diwou/Dottie_-_The_Matrix_Clock_Extended_Edition/signal-2026-06-13-09-17-21-165.jpg

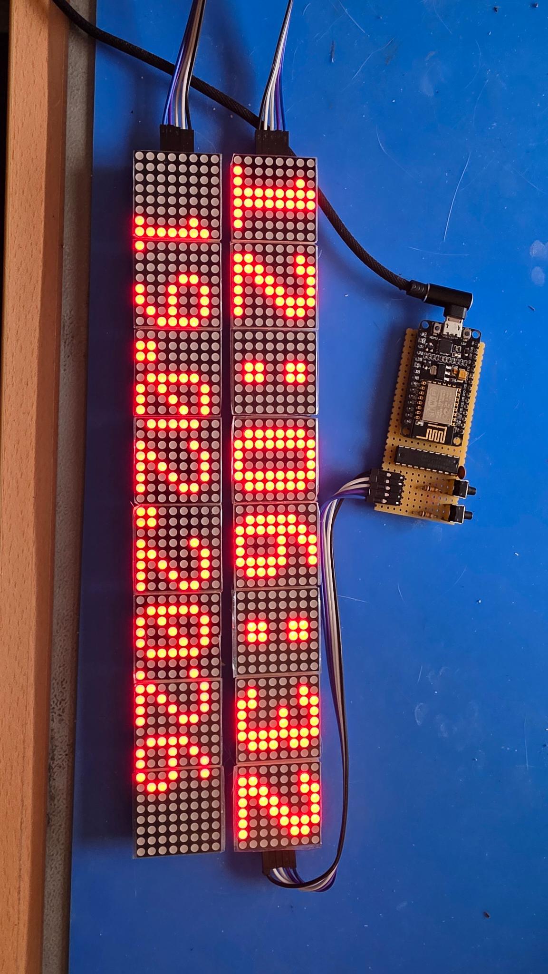
signal-2026-06-13-09-17-21-165.jpg
