diwou/Dottie_-_The_Matrix_Clock_Extended_Edition/signal-2026-06-13-09-19-30-515.jpg

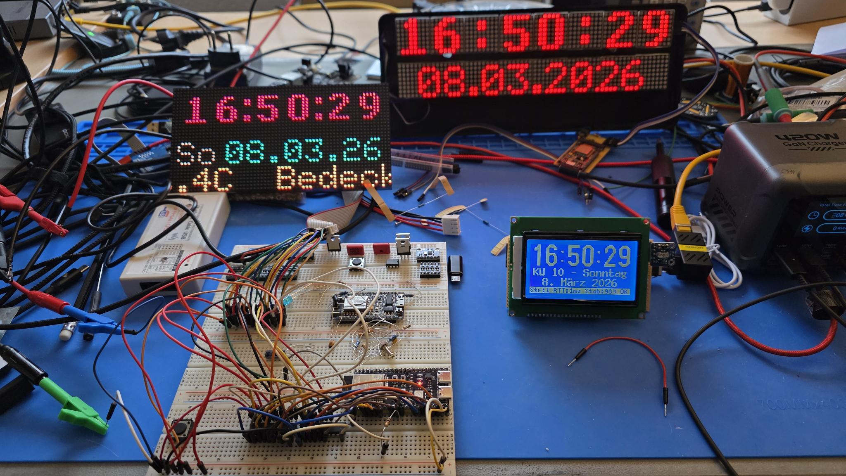
signal-2026-06-13-09-19-30-515.jpg
