diwou/Dottie_-_The_Matrix_Clock_Extended_Edition/kicad/fab/rev0.5/bom.csv

Designator | Footprint | Quantity | Value | LCSC Part #
BT1 | BatteryHolder_MYOUNG_BS-07-A1BJ001_CR2032 | 1 | CR2032
C1, C38 | 0805 | 2 | 10µ
C10, C11, C12, C13, C14, C15, C16, C17, C18, C19, C2, C20, C21, C22, C23, C24, C25, C26, C27, C28, C29, C30, C31, C32, C33, C34, C35, C36, C37, C6, C7, C8, C9 | 0805 | 33 | 100n
C3 | 0805 | 1 | 1µ
C4, C5 | 1206 | 2 | 10µ
D1 | 0805 | 1 | PWR
D2 | D_SMA | 1 | SS14
J1 | PinHeader_1x05_P2.54mm_Vertical | 1 | Conn_01x05
J10, J100, J101, J102, J103, J104, J105, J106, J107, J108, J109, J11, J110, J111, J112, J113, J114, J115, J116, J117, J118, J119, J12, J120, J121, J122, J123, J124, J125, J126, J127, J128, J129, J13, J130, J131, J132, J133, J134, J135, J136, J137, J138, J139, J14, J140, J141, J142, J143, J144, J145, J146, J147, J148, J149, J15, J150, J151, J152, J153, J154, J155, J156, J157, J158, J159, J16, J160, J161, J162, J163, J164, J165, J166, J167, J168, J169, J17, J170, J171, J172, J173, J174, J175, J176, J177, J178, J179, J18, J180, J181, J182, J183, J184, J185, J186, J187, J188, J189, J19, J190, J191, J192, J193, J194, J195, J196, J197, J198, J199, J20, J200, J201, J202, J203, J204, J205, J206, J207, J208, J209, J21, J210, J211, J212, J213, J214, J215, J216, J217, J218, J219, J22, J220, J221, J222, J223, J224, J225, J226, J227, J228, J229, J23, J230, J231, J232, J233, J234, J235, J236, J237, J238, J239, J24, J240, J241, J242, J25, J26, J27, J28, J29, J3, J30, J31, J32, J33, J34, J35, J36, J37, J38, J39, J4, J40, J41, J42, J43, J44, J45, J46, J47, J48, J49, J5, J50, J51, J52, J53, J54, J55, J56, J57, J58, J59, J6, J60, J61, J62 | TestPoint_Pad_1.5x1.5mm | 200 | Conn_01x01_Pin
J2 | USB_C_Receptacle_HCTL_HC-TYPE-C-16P-01A | 1 | USB_C_Receptacle_USB2.0_16P
J63, J64, J65, J66, J67, J68, J69, J7, J70, J71, J72, J73, J74, J75, J76, J77, J78, J79, J8, J80, J81, J82, J83, J84, J85, J86, J87, J88, J89, J9, J90, J91, J92, J93, J94, J95, J96, J97, J98, J99 | TestPoint_Pad_1.5x1.5mm | 40 | Conn_01x01_Pin
LED1, LED10, LED11, LED12, LED13, LED14, LED15, LED16, LED17, LED18, LED19, LED2, LED20, LED21, LED22, LED23, LED24, LED3, LED4, LED5, LED6, LED7, LED8, LED9 | LED_1088_Pin_Header | 24 | 1088AS
R1, R10, R3, R8, R9 | 0805 | 5 | 10k
R11, R12, R13, R14, R15, R16, R17, R18, R19, R20, R21, R22, R23, R24, R25, R26, R27, R28, R29, R30, R31, R32, R33, R34 | 0805 | 24 | 68k
R2 | 0805 | 1 | 1k
R35 | 0805 | 1 | 10
R4, R5 | 0805 | 2 | 5.1k
R6, R7 | 0805 | 2 | 4k7
SW1 | SW_PUSH_6mm_H5mm | 1 | Boot
SW2 | SW_PUSH_6mm_H5mm | 1 | Factory Reset
SW3 | SW_PUSH_6mm_H5mm | 1 | Reset
U1 | SOT-223-3_TabPin2 | 1 | TLV76133DCY
U10, U11, U12, U13, U14, U15, U16, U17, U18, U19, U20, U21, U22, U23, U24, U25, U26, U27, U28, U5, U6, U7, U8, U9 | SOIC-24W_7.5x15.4mm_P1.27mm | 24 | MAX7219CWG
U2 | ESP32-S3-WROOM-1 | 1 | ESP32-S3-WROOM-1
U29 | Bosch_LGA-8_3x3mm_P0.8mm_ClockwisePinNumbering | 1 | BME680
U3 | TSSOP-20_4.4x6.5mm_P0.65mm | 1 | 74HCT245
U30 | XDCR_VEML7700-TT | 1 | VEML7700-TT
U4 | SOIC-16W_7.5x10.3mm_P1.27mm | 1 | DS3231S
