diwou/Dottie_-_The_Matrix_Clock_Extended_Edition/kicad/source/NTP Dot Matrix Clock 64x32.kicad_pcb

## KiCad design kicad/source/NTP Dot Matrix Clock 64x32.kicad_pcb (2026-06-04)

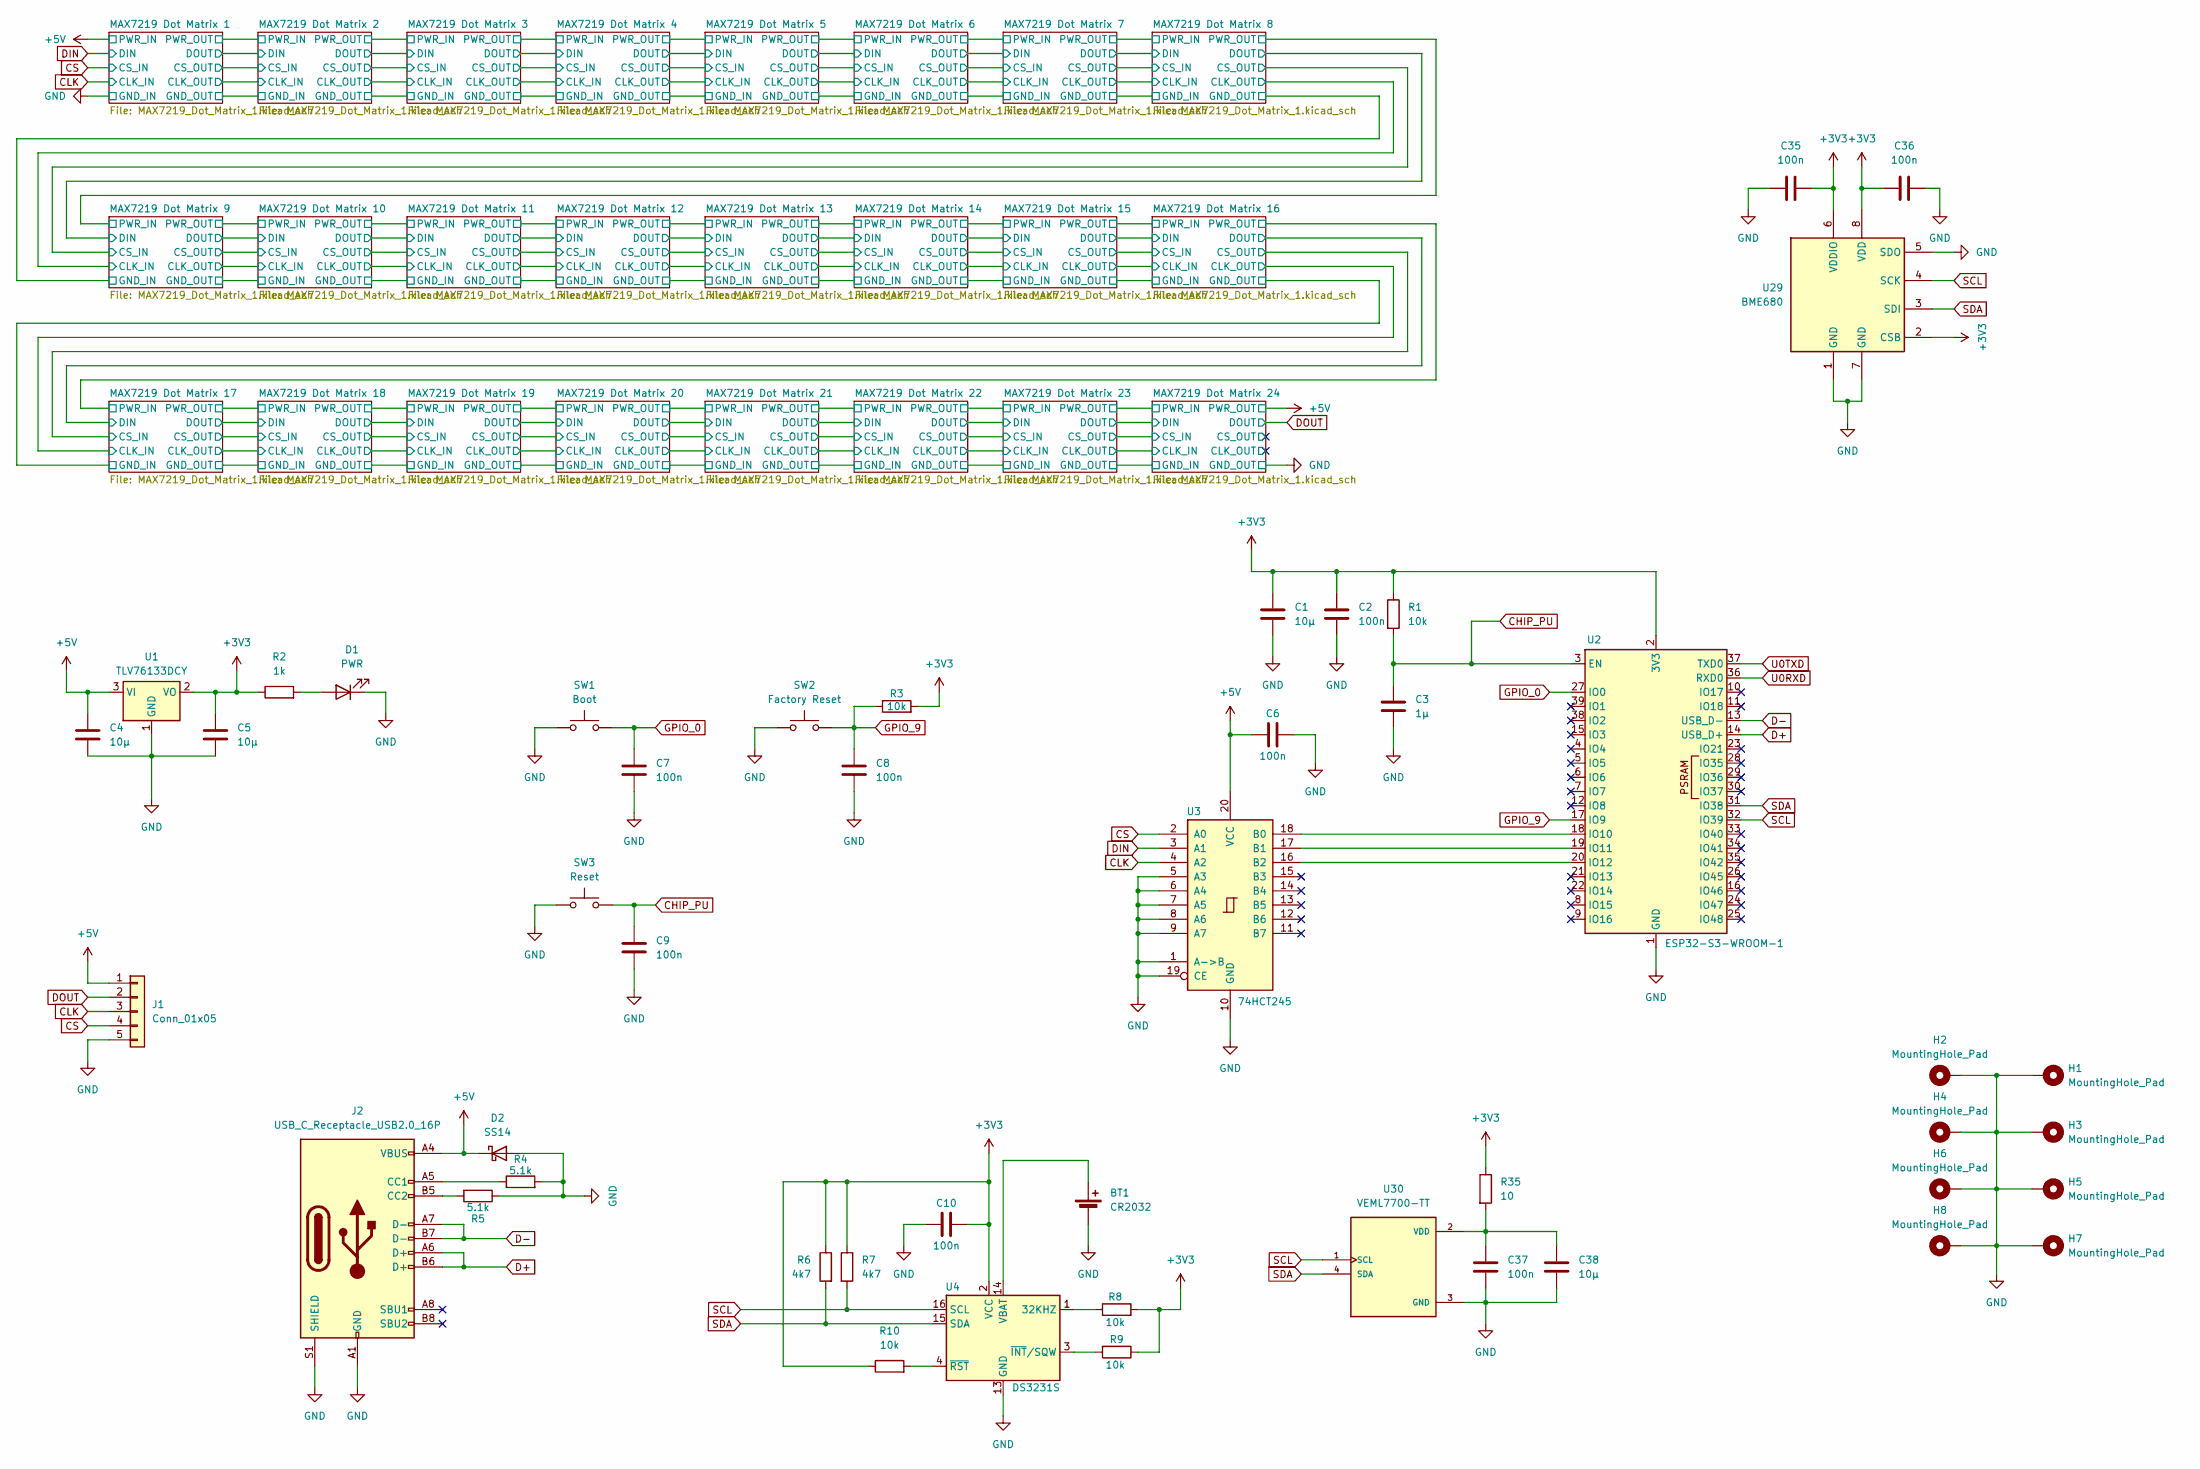
[picture p4: schematic NTP Dot Matrix Clock 64x32.kicad_sch]

Parts:
BT1: CR2032; BatteryHolder_MYOUNG_BS-07-A1BJ001_CR2032
C1, C38: 10µ; C_0805_2012Metric_Pad1.18x1.45mm_HandSolder
C2, C6, C7, C8, C9, C10, C35, C36, C37: 100n; C_0805_2012Metric_Pad1.18x1.45mm_HandSolder
C3: 1µ; C_0805_2012Metric_Pad1.18x1.45mm_HandSolder
C4, C5: 10µ; C_1206_3216Metric_Pad1.33x1.80mm_HandSolder
D1: PWR; LED_0805_2012Metric_Pad1.15x1.40mm_HandSolder
D2: SS14; D_SMA
H1, H2, H3, H4, H5, H6, H7, H8: MountingHole_Pad; MountingHole_3.2mm_M3_DIN965_Pad
J1: Conn_01x05; PinHeader_1x05_P2.54mm_Vertical
J2: USB_C_Receptacle_USB2.0_16P; USB_C_Receptacle_HCTL_HC-TYPE-C-16P-01A
R1, R3, R8, R9, R10: 10k; R_0805_2012Metric_Pad1.20x1.40mm_HandSolder
R2: 1k; R_0805_2012Metric_Pad1.20x1.40mm_HandSolder
R4, R5: 5.1k; R_0805_2012Metric_Pad1.20x1.40mm_HandSolder
R6, R7: 4k7; R_0805_2012Metric_Pad1.20x1.40mm_HandSolder
R35: 10; R_0805_2012Metric_Pad1.20x1.40mm_HandSolder
SW1: Boot; SW_PUSH_6mm_H5mm
SW2: Factory Reset; SW_PUSH_6mm_H5mm
SW3: Reset; SW_PUSH_6mm_H5mm
U1: TLV76133DCY; SOT-223-3_TabPin2
U2: ESP32-S3-WROOM-1
U3: 74HCT245; TSSOP-20_4.4x6.5mm_P0.65mm
U4: DS3231S; SOIC-16W_7.5x10.3mm_P1.27mm
U29: BME680; Bosch_LGA-8_3x3mm_P0.8mm_ClockwisePinNumbering
U30: VEML7700-TT; XDCR_VEML7700-TT; PARTREV 1.6

Connections:
+3V3: C1.1, C2.1, C5.1, C10.2, C35.2, C36.1, R1.1, R2.1, R3.2, R6.1, R7.1, R8.2, R9.1, R10.1, R35.1, U1.2 (VO), U2.2 (3V3), U4.2 (VCC), U29.2 (CSB), U29.6 (VDDIO), U29.8 (VDD)
+5V: C4.1, C6.1, D2.1 (K), J1.1, J2.A4 (VBUS), J2.A9 (VBUS), J2.B4 (VBUS), J2.B9 (VBUS), U1.3 (VI), U3.20 (VCC); also elsewhere on the board
CHIP_PU: C3.1, C9.1, R1.2, SW3.2, U2.3 (EN)
CLK: J1.3, U3.4 (A2); also elsewhere on the board
CS: J1.4, U3.2 (A0); also elsewhere on the board
D+: J2.A6 (D+), J2.B6 (D+), U2.14 (USB_D+)
D-: J2.A7 (D-), J2.B7 (D-), U2.13 (USB_D-)
DIN: U3.3 (A1); also elsewhere on the board
DOUT: J1.2; also elsewhere on the board
GND: BT1.2 (-), C1.2, C2.2, C3.2, C4.2, C5.2, C6.2, C7.2, C8.2, C9.2, C10.1, C35.1, C36.2, C37.2, C38.2, D1.1 (K), D2.2 (A), H1.1 (1_1), H2.1 (1_1), H3.1 (1_1), H4.1 (1_1), H5.1 (1_1), H6.1 (1_1), H7.1 (1_1), H8.1 (1_1), J1.5, J2.A1 (GND), J2.A12 (GND), J2.B1 (GND), J2.B12 (GND), J2.S1 (SHIELD), R4.2, R5.1, SW1.1, SW2.1, SW3.1, U1.1 (GND), U2.1 (GND), U2.40 (GND), U2.41 (GND), U3.1 (A->B), U3.5 (A3), U3.6 (A4), U3.7 (A5), U3.8 (A6), U3.9 (A7), U3.10 (GND), U3.19 (CE), U4.5 (GND), U4.6 (GND), U4.7 (GND), U4.8 (GND), U4.9 (GND), U4.10 (GND), U4.11 (GND), U4.12 (GND), U4.13 (GND), U29.1 (GND), U29.5 (SDO), U29.7 (GND), U30.3 (GND); also elsewhere on the board
GPIO_0: C7.1, SW1.2, U2.27 (IO0)
GPIO_9: C8.1, R3.1, SW2.2, U2.17 (IO9)
unnamed: BT1.1 (+), U4.14 (VBAT)
unnamed: D1.2 (A), R2.2
unnamed: J2.A5 (CC1), R4.1
unnamed: J2.B5 (CC2), R5.2
unnamed: U2.18 (IO10), U3.18 (B0)
unnamed: U2.19 (IO11), U3.17 (B1)
unnamed: U2.20 (IO12), U3.16 (B2)
unnamed: R8.1, U4.1 (32KHZ)
unnamed: R9.2, U4.3 (~INT/SQW)
unnamed: R10.2, U4.4 (~RST)
unnamed: C37.1, C38.1, R35.2, U30.2 (VDD)
SCL: R7.2, U2.32 (IO39), U4.16 (SCL), U29.4 (SCK), U30.1 (SCL)
SDA: R6.2, U2.31 (IO38), U4.15 (SDA), U29.3 (SDI), U30.4 (SDA)
U0RXD: U2.36 (RXD0)
U0TXD: U2.37 (TXD0)
