diwou/Dottie_-_The_Matrix_Clock_Extended_Edition/kicad/source/NTP Dot Matrix Clock 64x32.kicad_pcb

## KiCad design kicad/source/NTP Dot Matrix Clock 64x32.kicad_pcb (continued)

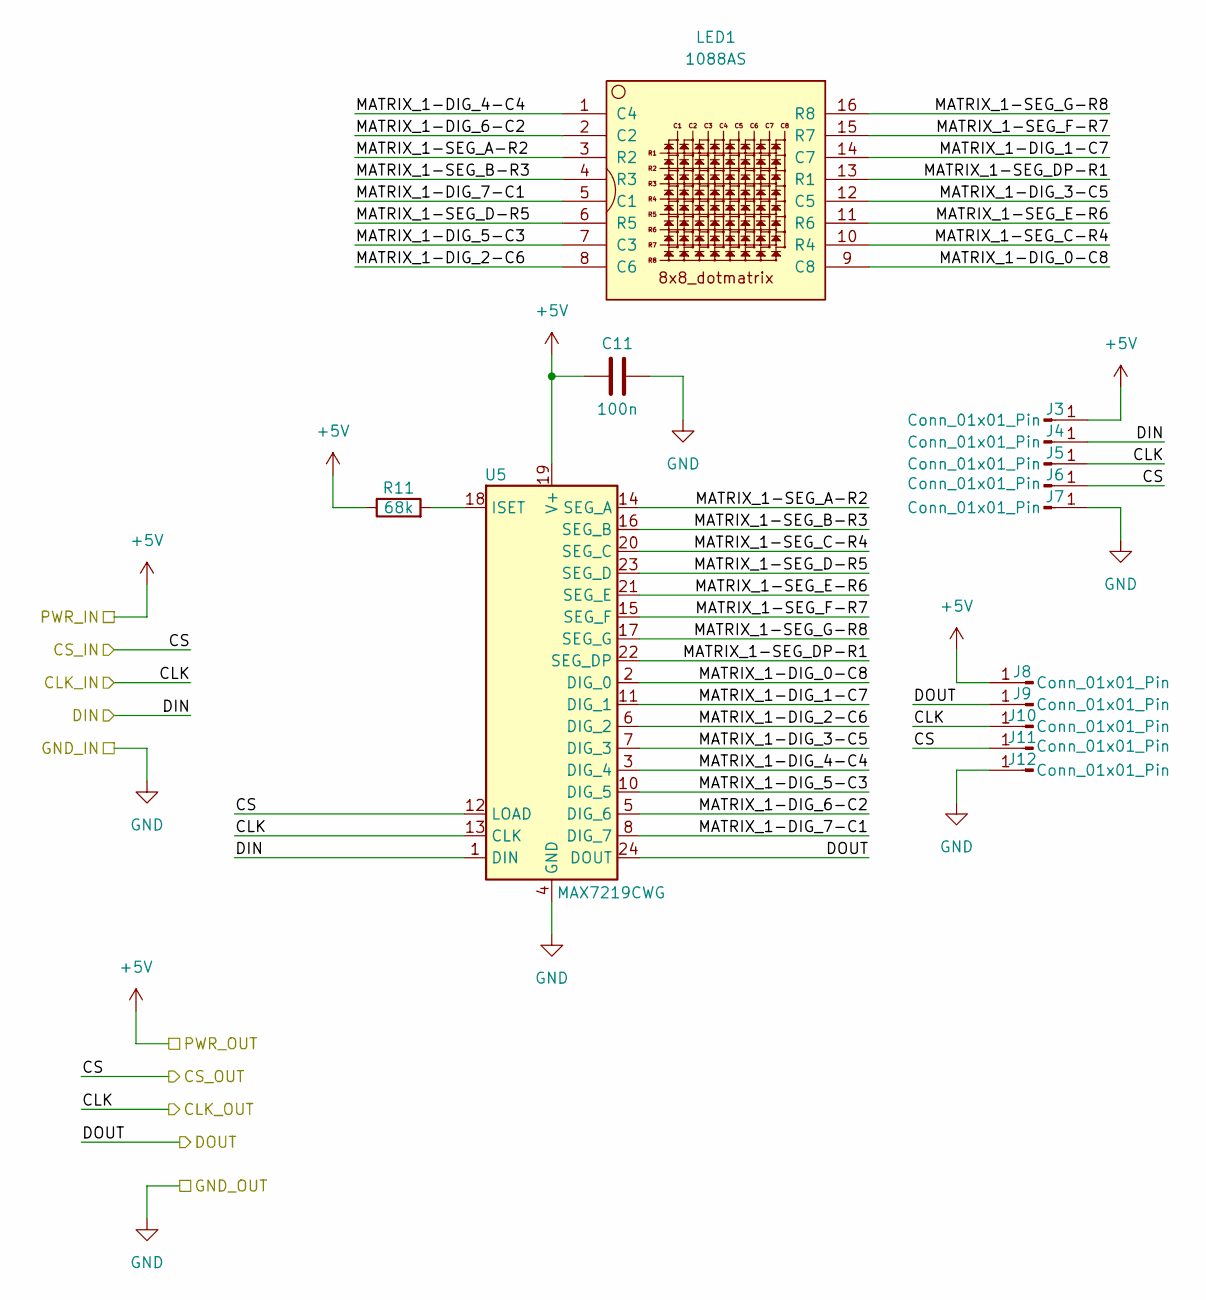
[picture p5: schematic MAX7219_Dot_Matrix_1.kicad_sch, NTP Dot Matrix Clock 64x32]

Parts:
C11: 100n; C_0805_2012Metric_Pad1.18x1.45mm_HandSolder
J3, J4, J5, J6, J7, J8, J9, J10, J11, J12: Conn_01x01_Pin; TestPoint_Pad_1.5x1.5mm
LED1: 1088AS; LED_1088_Pin_Header
R11: 68k; R_0805_2012Metric_Pad1.20x1.40mm_HandSolder
U5: MAX7219CWG; SOIC-24W_7.5x15.4mm_P1.27mm

Connections:
+5V: C11.1, J3.1 (Pin_1_1), J8.1 (Pin_1_1), R11.1, U5.19 (V+); also elsewhere on the board
/MAX7219 Dot Matrix 1/DOUT: J9.1 (Pin_1_1), U5.24 (DOUT); also elsewhere on the board
/MAX7219 Dot Matrix 1/MATRIX_1-DIG_0-C8: LED1.9 (C8), U5.2 (DIG_0)
/MAX7219 Dot Matrix 1/MATRIX_1-DIG_1-C7: LED1.14 (C7), U5.11 (DIG_1)
/MAX7219 Dot Matrix 1/MATRIX_1-DIG_2-C6: LED1.8 (C6), U5.6 (DIG_2)
/MAX7219 Dot Matrix 1/MATRIX_1-DIG_3-C5: LED1.12 (C5), U5.7 (DIG_3)
/MAX7219 Dot Matrix 1/MATRIX_1-DIG_4-C4: LED1.1 (C4), U5.3 (DIG_4)
/MAX7219 Dot Matrix 1/MATRIX_1-DIG_5-C3: LED1.7 (C3), U5.10 (DIG_5)
/MAX7219 Dot Matrix 1/MATRIX_1-DIG_6-C2: LED1.2 (C2), U5.5 (DIG_6)
/MAX7219 Dot Matrix 1/MATRIX_1-DIG_7-C1: LED1.5 (C1), U5.8 (DIG_7)
/MAX7219 Dot Matrix 1/MATRIX_1-SEG_A-R2: LED1.3 (R2), U5.14 (SEG_A)
/MAX7219 Dot Matrix 1/MATRIX_1-SEG_B-R3: LED1.4 (R3), U5.16 (SEG_B)
/MAX7219 Dot Matrix 1/MATRIX_1-SEG_C-R4: LED1.10 (R4), U5.20 (SEG_C)
/MAX7219 Dot Matrix 1/MATRIX_1-SEG_D-R5: LED1.6 (R5), U5.23 (SEG_D)
/MAX7219 Dot Matrix 1/MATRIX_1-SEG_DP-R1: LED1.13 (R1), U5.22 (SEG_DP)
/MAX7219 Dot Matrix 1/MATRIX_1-SEG_E-R6: LED1.11 (R6), U5.21 (SEG_E)
/MAX7219 Dot Matrix 1/MATRIX_1-SEG_F-R7: LED1.15 (R7), U5.15 (SEG_F)
/MAX7219 Dot Matrix 1/MATRIX_1-SEG_G-R8: LED1.16 (R8), U5.17 (SEG_G)
CLK: J5.1 (Pin_1_1), J10.1 (Pin_1_1), U5.13 (CLK); also elsewhere on the board
CS: J6.1 (Pin_1_1), J11.1 (Pin_1_1), U5.12 (LOAD); also elsewhere on the board
DIN: J4.1 (Pin_1_1), U5.1 (DIN); also elsewhere on the board
GND: C11.2, J7.1 (Pin_1_1), J12.1 (Pin_1_1), U5.4 (GND), U5.9 (GND); also elsewhere on the board
unnamed: R11.2, U5.18 (ISET)

Parts of its further copies:
C12, C13, C14, C15, C16, C17, C18, C19, C20, C21, C22, C23, C24, C25, C26, C27, C28, C29, C30, C31, C32, C33, C34: 100n; C_0805_2012Metric_Pad1.18x1.45mm_HandSolder
J13, J14, J15, J16, J17, J18, J19, J20, J21, J22, J23, J24, J25, J26, J27, J28, J29, J30, J31, J32, J33, J34, J35, J36, J37, J38, J39, J40, J41, J42, J43, J44, J45, J46, J47, J48, J49, J50, J51, J52, J53, J54, J55, J56, J57, J58, J59, J60, J61, J62, J63, J64, J65, J66, J67, J68, J69, J70, J71, J72, J73, J74, J75, J76, J77, J78, J79, J80, J81, J82, J83, J84, J85, J86, J87, J88, J89, J90, J91, J92, J93, J94, J95, J96, J97, J98, J99, J100, J101, J102, J103, J104, J105, J106, J107, J108, J109, J110, J111, J112, J113, J114, J115, J116, J117, J118, J119, J120, J121, J122, J123, J124, J125, J126, J127, J128, J129, J130, J131, J132, J133, J134, J135, J136, J137, J138, J139, J140, J141, J142, J143, J144, J145, J146, J147, J148, J149, J150, J151, J152, J153, J154, J155, J156, J157, J158, J159, J160, J161, J162, J163, J164, J165, J166, J167, J168, J169, J170, J171, J172, J173, J174, J175, J176, J177, J178, J179, J180, J181, J182, J183, J184, J185, J186, J187, J188, J189, J190, J191, J192, J193, J194, J195, J196, J197, J198, J199, J200, J201, J202, J203, J204, J205, J206, J207, J208, J209, J210, J211, J212, J213, J214, J215, J216, J217, J218, J219, J220, J221, J222, J223, J224, J225, J226, J227, J228, J229, J230, J231, J232, J233, J234, J235, J236, J237, J238, J239, J240, J241, J242: Conn_01x01_Pin; TestPoint_Pad_1.5x1.5mm
LED2, LED3, LED4, LED5, LED6, LED7, LED8, LED9, LED10, LED11, LED12, LED13, LED14, LED15, LED16, LED17, LED18, LED19, LED20, LED21, LED22, LED23, LED24: 1088AS; LED_1088_Pin_Header
R12, R13, R14, R15, R16, R17, R18, R19, R20, R21, R22, R23, R24, R25, R26, R27, R28, R29, R30, R31, R32, R33, R34: 68k; R_0805_2012Metric_Pad1.20x1.40mm_HandSolder
U6, U7, U8, U9, U10, U11, U12, U13, U14, U15, U16, U17, U18, U19, U20, U21, U22, U23, U24, U25, U26, U27, U28: MAX7219CWG; SOIC-24W_7.5x15.4mm_P1.27mm

Connections of its further copies:
+5V: C12.1, C13.1, C14.1, C15.1, C16.1, C17.1, C18.1, C19.1, C20.1, C21.1, C22.1, C23.1, C24.1, C25.1, C26.1, C27.1, C28.1, C29.1, C30.1, C31.1, C32.1, C33.1, C34.1, J13.1 (Pin_1_1), J18.1 (Pin_1_1), J23.1 (Pin_1_1), J28.1 (Pin_1_1), J33.1 (Pin_1_1), J38.1 (Pin_1_1), J43.1 (Pin_1_1), J48.1 (Pin_1_1), J53.1 (Pin_1_1), J58.1 (Pin_1_1), J63.1 (Pin_1_1), J68.1 (Pin_1_1), J73.1 (Pin_1_1), J78.1 (Pin_1_1), J83.1 (Pin_1_1), J88.1 (Pin_1_1), J93.1 (Pin_1_1), J98.1 (Pin_1_1), J103.1 (Pin_1_1), J108.1 (Pin_1_1), J113.1 (Pin_1_1), J118.1 (Pin_1_1), J123.1 (Pin_1_1), J128.1 (Pin_1_1), J133.1 (Pin_1_1), J138.1 (Pin_1_1), J143.1 (Pin_1_1), J148.1 (Pin_1_1), J153.1 (Pin_1_1), J158.1 (Pin_1_1), J163.1 (Pin_1_1), J168.1 (Pin_1_1), J173.1 (Pin_1_1), J178.1 (Pin_1_1), J183.1 (Pin_1_1), J188.1 (Pin_1_1), J193.1 (Pin_1_1), J198.1 (Pin_1_1), J203.1 (Pin_1_1), J208.1 (Pin_1_1), J213.1 (Pin_1_1), J218.1 (Pin_1_1), J223.1 (Pin_1_1), J228.1 (Pin_1_1), J233.1 (Pin_1_1), J238.1 (Pin_1_1), R12.1, R13.1, R14.1, R15.1, R16.1, R17.1, R18.1, R19.1, R20.1, R21.1, R22.1, R23.1, R24.1, R25.1, R26.1, R27.1, R28.1, R29.1, R30.1, R31.1, R32.1, R33.1, R34.1, U6.19 (V+), U7.19 (V+), U8.19 (V+), U9.19 (V+), U10.19 (V+), U11.19 (V+), U12.19 (V+), U13.19 (V+), U14.19 (V+), U15.19 (V+), U16.19 (V+), U17.19 (V+), U18.19 (V+), U19.19 (V+), U20.19 (V+), U21.19 (V+), U22.19 (V+), U23.19 (V+), U24.19 (V+), U25.19 (V+), U26.19 (V+), U27.19 (V+), U28.19 (V+); also elsewhere on the board
/MAX7219 Dot Matrix 1/DOUT: J14.1 (Pin_1_1), U6.1 (DIN); also elsewhere on the board
/MAX7219 Dot Matrix 2/DOUT: J19.1 (Pin_1_1), J24.1 (Pin_1_1), U6.24 (DOUT), U7.1 (DIN)
/MAX7219 Dot Matrix 2/MATRIX_1-DIG_0-C8: LED2.9 (C8), U6.2 (DIG_0)
/MAX7219 Dot Matrix 2/MATRIX_1-DIG_1-C7: LED2.14 (C7), U6.11 (DIG_1)
/MAX7219 Dot Matrix 2/MATRIX_1-DIG_2-C6: LED2.8 (C6), U6.6 (DIG_2)
/MAX7219 Dot Matrix 2/MATRIX_1-DIG_3-C5: LED2.12 (C5), U6.7 (DIG_3)
/MAX7219 Dot Matrix 2/MATRIX_1-DIG_4-C4: LED2.1 (C4), U6.3 (DIG_4)
/MAX7219 Dot Matrix 2/MATRIX_1-DIG_5-C3: LED2.7 (C3), U6.10 (DIG_5)
/MAX7219 Dot Matrix 2/MATRIX_1-DIG_6-C2: LED2.2 (C2), U6.5 (DIG_6)
/MAX7219 Dot Matrix 2/MATRIX_1-DIG_7-C1: LED2.5 (C1), U6.8 (DIG_7)
/MAX7219 Dot Matrix 2/MATRIX_1-SEG_A-R2: LED2.3 (R2), U6.14 (SEG_A)
/MAX7219 Dot Matrix 2/MATRIX_1-SEG_B-R3: LED2.4 (R3), U6.16 (SEG_B)
/MAX7219 Dot Matrix 2/MATRIX_1-SEG_C-R4: LED2.10 (R4), U6.20 (SEG_C)
/MAX7219 Dot Matrix 2/MATRIX_1-SEG_D-R5: LED2.6 (R5), U6.23 (SEG_D)
/MAX7219 Dot Matrix 2/MATRIX_1-SEG_DP-R1: LED2.13 (R1), U6.22 (SEG_DP)
/MAX7219 Dot Matrix 2/MATRIX_1-SEG_E-R6: LED2.11 (R6), U6.21 (SEG_E)
/MAX7219 Dot Matrix 2/MATRIX_1-SEG_F-R7: LED2.15 (R7), U6.15 (SEG_F)
/MAX7219 Dot Matrix 2/MATRIX_1-SEG_G-R8: LED2.16 (R8), U6.17 (SEG_G)
/MAX7219 Dot Matrix 3/DOUT: J29.1 (Pin_1_1), J34.1 (Pin_1_1), U7.24 (DOUT), U8.1 (DIN)
/MAX7219 Dot Matrix 3/MATRIX_1-DIG_0-C8: LED3.9 (C8), U7.2 (DIG_0)
/MAX7219 Dot Matrix 3/MATRIX_1-DIG_1-C7: LED3.14 (C7), U7.11 (DIG_1)
/MAX7219 Dot Matrix 3/MATRIX_1-DIG_2-C6: LED3.8 (C6), U7.6 (DIG_2)
/MAX7219 Dot Matrix 3/MATRIX_1-DIG_3-C5: LED3.12 (C5), U7.7 (DIG_3)
/MAX7219 Dot Matrix 3/MATRIX_1-DIG_4-C4: LED3.1 (C4), U7.3 (DIG_4)
/MAX7219 Dot Matrix 3/MATRIX_1-DIG_5-C3: LED3.7 (C3), U7.10 (DIG_5)
/MAX7219 Dot Matrix 3/MATRIX_1-DIG_6-C2: LED3.2 (C2), U7.5 (DIG_6)
/MAX7219 Dot Matrix 3/MATRIX_1-DIG_7-C1: LED3.5 (C1), U7.8 (DIG_7)
/MAX7219 Dot Matrix 3/MATRIX_1-SEG_A-R2: LED3.3 (R2), U7.14 (SEG_A)
/MAX7219 Dot Matrix 3/MATRIX_1-SEG_B-R3: LED3.4 (R3), U7.16 (SEG_B)
/MAX7219 Dot Matrix 3/MATRIX_1-SEG_C-R4: LED3.10 (R4), U7.20 (SEG_C)
/MAX7219 Dot Matrix 3/MATRIX_1-SEG_D-R5: LED3.6 (R5), U7.23 (SEG_D)
/MAX7219 Dot Matrix 3/MATRIX_1-SEG_DP-R1: LED3.13 (R1), U7.22 (SEG_DP)
/MAX7219 Dot Matrix 3/MATRIX_1-SEG_E-R6: LED3.11 (R6), U7.21 (SEG_E)
/MAX7219 Dot Matrix 3/MATRIX_1-SEG_F-R7: LED3.15 (R7), U7.15 (SEG_F)
/MAX7219 Dot Matrix 3/MATRIX_1-SEG_G-R8: LED3.16 (R8), U7.17 (SEG_G)
/MAX7219 Dot Matrix 4/DOUT: J39.1 (Pin_1_1), J44.1 (Pin_1_1), U8.24 (DOUT), U9.1 (DIN)
/MAX7219 Dot Matrix 4/MATRIX_1-DIG_0-C8: LED4.9 (C8), U8.2 (DIG_0)
/MAX7219 Dot Matrix 4/MATRIX_1-DIG_1-C7: LED4.14 (C7), U8.11 (DIG_1)
/MAX7219 Dot Matrix 4/MATRIX_1-DIG_2-C6: LED4.8 (C6), U8.6 (DIG_2)
/MAX7219 Dot Matrix 4/MATRIX_1-DIG_3-C5: LED4.12 (C5), U8.7 (DIG_3)
/MAX7219 Dot Matrix 4/MATRIX_1-DIG_4-C4: LED4.1 (C4), U8.3 (DIG_4)
/MAX7219 Dot Matrix 4/MATRIX_1-DIG_5-C3: LED4.7 (C3), U8.10 (DIG_5)
/MAX7219 Dot Matrix 4/MATRIX_1-DIG_6-C2: LED4.2 (C2), U8.5 (DIG_6)
/MAX7219 Dot Matrix 4/MATRIX_1-DIG_7-C1: LED4.5 (C1), U8.8 (DIG_7)
/MAX7219 Dot Matrix 4/MATRIX_1-SEG_A-R2: LED4.3 (R2), U8.14 (SEG_A)
/MAX7219 Dot Matrix 4/MATRIX_1-SEG_B-R3: LED4.4 (R3), U8.16 (SEG_B)
/MAX7219 Dot Matrix 4/MATRIX_1-SEG_C-R4: LED4.10 (R4), U8.20 (SEG_C)
/MAX7219 Dot Matrix 4/MATRIX_1-SEG_D-R5: LED4.6 (R5), U8.23 (SEG_D)
/MAX7219 Dot Matrix 4/MATRIX_1-SEG_DP-R1: LED4.13 (R1), U8.22 (SEG_DP)
/MAX7219 Dot Matrix 4/MATRIX_1-SEG_E-R6: LED4.11 (R6), U8.21 (SEG_E)
/MAX7219 Dot Matrix 4/MATRIX_1-SEG_F-R7: LED4.15 (R7), U8.15 (SEG_F)
/MAX7219 Dot Matrix 4/MATRIX_1-SEG_G-R8: LED4.16 (R8), U8.17 (SEG_G)
/MAX7219 Dot Matrix 5/DOUT: J49.1 (Pin_1_1), J54.1 (Pin_1_1), U9.24 (DOUT), U10.1 (DIN)
/MAX7219 Dot Matrix 5/MATRIX_1-DIG_0-C8: LED5.9 (C8), U9.2 (DIG_0)
/MAX7219 Dot Matrix 5/MATRIX_1-DIG_1-C7: LED5.14 (C7), U9.11 (DIG_1)
/MAX7219 Dot Matrix 5/MATRIX_1-DIG_2-C6: LED5.8 (C6), U9.6 (DIG_2)
/MAX7219 Dot Matrix 5/MATRIX_1-DIG_3-C5: LED5.12 (C5), U9.7 (DIG_3)
/MAX7219 Dot Matrix 5/MATRIX_1-DIG_4-C4: LED5.1 (C4), U9.3 (DIG_4)
/MAX7219 Dot Matrix 5/MATRIX_1-DIG_5-C3: LED5.7 (C3), U9.10 (DIG_5)
/MAX7219 Dot Matrix 5/MATRIX_1-DIG_6-C2: LED5.2 (C2), U9.5 (DIG_6)
/MAX7219 Dot Matrix 5/MATRIX_1-DIG_7-C1: LED5.5 (C1), U9.8 (DIG_7)
/MAX7219 Dot Matrix 5/MATRIX_1-SEG_A-R2: LED5.3 (R2), U9.14 (SEG_A)
/MAX7219 Dot Matrix 5/MATRIX_1-SEG_B-R3: LED5.4 (R3), U9.16 (SEG_B)
/MAX7219 Dot Matrix 5/MATRIX_1-SEG_C-R4: LED5.10 (R4), U9.20 (SEG_C)
/MAX7219 Dot Matrix 5/MATRIX_1-SEG_D-R5: LED5.6 (R5), U9.23 (SEG_D)
/MAX7219 Dot Matrix 5/MATRIX_1-SEG_DP-R1: LED5.13 (R1), U9.22 (SEG_DP)
/MAX7219 Dot Matrix 5/MATRIX_1-SEG_E-R6: LED5.11 (R6), U9.21 (SEG_E)
/MAX7219 Dot Matrix 5/MATRIX_1-SEG_F-R7: LED5.15 (R7), U9.15 (SEG_F)
/MAX7219 Dot Matrix 5/MATRIX_1-SEG_G-R8: LED5.16 (R8), U9.17 (SEG_G)
/MAX7219 Dot Matrix 6/DOUT: J59.1 (Pin_1_1), J64.1 (Pin_1_1), U10.24 (DOUT), U11.1 (DIN)
/MAX7219 Dot Matrix 6/MATRIX_1-DIG_0-C8: LED6.9 (C8), U10.2 (DIG_0)
/MAX7219 Dot Matrix 6/MATRIX_1-DIG_1-C7: LED6.14 (C7), U10.11 (DIG_1)
/MAX7219 Dot Matrix 6/MATRIX_1-DIG_2-C6: LED6.8 (C6), U10.6 (DIG_2)
/MAX7219 Dot Matrix 6/MATRIX_1-DIG_3-C5: LED6.12 (C5), U10.7 (DIG_3)
/MAX7219 Dot Matrix 6/MATRIX_1-DIG_4-C4: LED6.1 (C4), U10.3 (DIG_4)
/MAX7219 Dot Matrix 6/MATRIX_1-DIG_5-C3: LED6.7 (C3), U10.10 (DIG_5)
/MAX7219 Dot Matrix 6/MATRIX_1-DIG_6-C2: LED6.2 (C2), U10.5 (DIG_6)
/MAX7219 Dot Matrix 6/MATRIX_1-DIG_7-C1: LED6.5 (C1), U10.8 (DIG_7)
/MAX7219 Dot Matrix 6/MATRIX_1-SEG_A-R2: LED6.3 (R2), U10.14 (SEG_A)
/MAX7219 Dot Matrix 6/MATRIX_1-SEG_B-R3: LED6.4 (R3), U10.16 (SEG_B)
/MAX7219 Dot Matrix 6/MATRIX_1-SEG_C-R4: LED6.10 (R4), U10.20 (SEG_C)
/MAX7219 Dot Matrix 6/MATRIX_1-SEG_D-R5: LED6.6 (R5), U10.23 (SEG_D)
/MAX7219 Dot Matrix 6/MATRIX_1-SEG_DP-R1: LED6.13 (R1), U10.22 (SEG_DP)
/MAX7219 Dot Matrix 6/MATRIX_1-SEG_E-R6: LED6.11 (R6), U10.21 (SEG_E)
/MAX7219 Dot Matrix 6/MATRIX_1-SEG_F-R7: LED6.15 (R7), U10.15 (SEG_F)
/MAX7219 Dot Matrix 6/MATRIX_1-SEG_G-R8: LED6.16 (R8), U10.17 (SEG_G)
/MAX7219 Dot Matrix 7/DOUT: J69.1 (Pin_1_1), J74.1 (Pin_1_1), U11.24 (DOUT), U12.1 (DIN)
/MAX7219 Dot Matrix 7/MATRIX_1-DIG_0-C8: LED7.9 (C8), U11.2 (DIG_0)
/MAX7219 Dot Matrix 7/MATRIX_1-DIG_1-C7: LED7.14 (C7), U11.11 (DIG_1)
/MAX7219 Dot Matrix 7/MATRIX_1-DIG_2-C6: LED7.8 (C6), U11.6 (DIG_2)
/MAX7219 Dot Matrix 7/MATRIX_1-DIG_3-C5: LED7.12 (C5), U11.7 (DIG_3)
/MAX7219 Dot Matrix 7/MATRIX_1-DIG_4-C4: LED7.1 (C4), U11.3 (DIG_4)
/MAX7219 Dot Matrix 7/MATRIX_1-DIG_5-C3: LED7.7 (C3), U11.10 (DIG_5)
/MAX7219 Dot Matrix 7/MATRIX_1-DIG_6-C2: LED7.2 (C2), U11.5 (DIG_6)
/MAX7219 Dot Matrix 7/MATRIX_1-DIG_7-C1: LED7.5 (C1), U11.8 (DIG_7)
/MAX7219 Dot Matrix 7/MATRIX_1-SEG_A-R2: LED7.3 (R2), U11.14 (SEG_A)
/MAX7219 Dot Matrix 7/MATRIX_1-SEG_B-R3: LED7.4 (R3), U11.16 (SEG_B)
/MAX7219 Dot Matrix 7/MATRIX_1-SEG_C-R4: LED7.10 (R4), U11.20 (SEG_C)
/MAX7219 Dot Matrix 7/MATRIX_1-SEG_D-R5: LED7.6 (R5), U11.23 (SEG_D)
/MAX7219 Dot Matrix 7/MATRIX_1-SEG_DP-R1: LED7.13 (R1), U11.22 (SEG_DP)
/MAX7219 Dot Matrix 7/MATRIX_1-SEG_E-R6: LED7.11 (R6), U11.21 (SEG_E)
/MAX7219 Dot Matrix 7/MATRIX_1-SEG_F-R7: LED7.15 (R7), U11.15 (SEG_F)
/MAX7219 Dot Matrix 7/MATRIX_1-SEG_G-R8: LED7.16 (R8), U11.17 (SEG_G)
/MAX7219 Dot Matrix 8/DOUT: J79.1 (Pin_1_1), J84.1 (Pin_1_1), U12.24 (DOUT), U13.1 (DIN)
/MAX7219 Dot Matrix 8/MATRIX_1-DIG_0-C8: LED8.9 (C8), U12.2 (DIG_0)
/MAX7219 Dot Matrix 8/MATRIX_1-DIG_1-C7: LED8.14 (C7), U12.11 (DIG_1)
/MAX7219 Dot Matrix 8/MATRIX_1-DIG_2-C6: LED8.8 (C6), U12.6 (DIG_2)
/MAX7219 Dot Matrix 8/MATRIX_1-DIG_3-C5: LED8.12 (C5), U12.7 (DIG_3)
/MAX7219 Dot Matrix 8/MATRIX_1-DIG_4-C4: LED8.1 (C4), U12.3 (DIG_4)
/MAX7219 Dot Matrix 8/MATRIX_1-DIG_5-C3: LED8.7 (C3), U12.10 (DIG_5)
/MAX7219 Dot Matrix 8/MATRIX_1-DIG_6-C2: LED8.2 (C2), U12.5 (DIG_6)
/MAX7219 Dot Matrix 8/MATRIX_1-DIG_7-C1: LED8.5 (C1), U12.8 (DIG_7)
/MAX7219 Dot Matrix 8/MATRIX_1-SEG_A-R2: LED8.3 (R2), U12.14 (SEG_A)
/MAX7219 Dot Matrix 8/MATRIX_1-SEG_B-R3: LED8.4 (R3), U12.16 (SEG_B)
/MAX7219 Dot Matrix 8/MATRIX_1-SEG_C-R4: LED8.10 (R4), U12.20 (SEG_C)
/MAX7219 Dot Matrix 8/MATRIX_1-SEG_D-R5: LED8.6 (R5), U12.23 (SEG_D)
/MAX7219 Dot Matrix 8/MATRIX_1-SEG_DP-R1: LED8.13 (R1), U12.22 (SEG_DP)
/MAX7219 Dot Matrix 8/MATRIX_1-SEG_E-R6: LED8.11 (R6), U12.21 (SEG_E)
/MAX7219 Dot Matrix 8/MATRIX_1-SEG_F-R7: LED8.15 (R7), U12.15 (SEG_F)
/MAX7219 Dot Matrix 8/MATRIX_1-SEG_G-R8: LED8.16 (R8), U12.17 (SEG_G)
/MAX7219 Dot Matrix 9/MATRIX_1-DIG_0-C8: LED9.9 (C8), U13.2 (DIG_0)
/MAX7219 Dot Matrix 9/MATRIX_1-DIG_1-C7: LED9.14 (C7), U13.11 (DIG_1)
/MAX7219 Dot Matrix 9/MATRIX_1-DIG_2-C6: LED9.8 (C6), U13.6 (DIG_2)
/MAX7219 Dot Matrix 9/MATRIX_1-DIG_3-C5: LED9.12 (C5), U13.7 (DIG_3)
/MAX7219 Dot Matrix 9/MATRIX_1-DIG_4-C4: LED9.1 (C4), U13.3 (DIG_4)
/MAX7219 Dot Matrix 9/MATRIX_1-DIG_5-C3: LED9.7 (C3), U13.10 (DIG_5)
/MAX7219 Dot Matrix 9/MATRIX_1-DIG_6-C2: LED9.2 (C2), U13.5 (DIG_6)
/MAX7219 Dot Matrix 9/MATRIX_1-DIG_7-C1: LED9.5 (C1), U13.8 (DIG_7)
/MAX7219 Dot Matrix 9/MATRIX_1-SEG_A-R2: LED9.3 (R2), U13.14 (SEG_A)
/MAX7219 Dot Matrix 9/MATRIX_1-SEG_B-R3: LED9.4 (R3), U13.16 (SEG_B)
/MAX7219 Dot Matrix 9/MATRIX_1-SEG_C-R4: LED9.10 (R4), U13.20 (SEG_C)
/MAX7219 Dot Matrix 9/MATRIX_1-SEG_D-R5: LED9.6 (R5), U13.23 (SEG_D)
/MAX7219 Dot Matrix 9/MATRIX_1-SEG_DP-R1: LED9.13 (R1), U13.22 (SEG_DP)
/MAX7219 Dot Matrix 9/MATRIX_1-SEG_E-R6: LED9.11 (R6), U13.21 (SEG_E)
/MAX7219 Dot Matrix 9/MATRIX_1-SEG_F-R7: LED9.15 (R7), U13.15 (SEG_F)
/MAX7219 Dot Matrix 9/MATRIX_1-SEG_G-R8: LED9.16 (R8), U13.17 (SEG_G)
/MAX7219 Dot Matrix 10/DIN: J89.1 (Pin_1_1), J94.1 (Pin_1_1), U13.24 (DOUT), U14.1 (DIN)
/MAX7219 Dot Matrix 10/DOUT: J99.1 (Pin_1_1), J104.1 (Pin_1_1), U14.24 (DOUT), U15.1 (DIN)
/MAX7219 Dot Matrix 10/MATRIX_1-DIG_0-C8: LED10.9 (C8), U14.2 (DIG_0)
/MAX7219 Dot Matrix 10/MATRIX_1-DIG_1-C7: LED10.14 (C7), U14.11 (DIG_1)
/MAX7219 Dot Matrix 10/MATRIX_1-DIG_2-C6: LED10.8 (C6), U14.6 (DIG_2)
/MAX7219 Dot Matrix 10/MATRIX_1-DIG_3-C5: LED10.12 (C5), U14.7 (DIG_3)
/MAX7219 Dot Matrix 10/MATRIX_1-DIG_4-C4: LED10.1 (C4), U14.3 (DIG_4)
/MAX7219 Dot Matrix 10/MATRIX_1-DIG_5-C3: LED10.7 (C3), U14.10 (DIG_5)
/MAX7219 Dot Matrix 10/MATRIX_1-DIG_6-C2: LED10.2 (C2), U14.5 (DIG_6)
/MAX7219 Dot Matrix 10/MATRIX_1-DIG_7-C1: LED10.5 (C1), U14.8 (DIG_7)
/MAX7219 Dot Matrix 10/MATRIX_1-SEG_A-R2: LED10.3 (R2), U14.14 (SEG_A)
/MAX7219 Dot Matrix 10/MATRIX_1-SEG_B-R3: LED10.4 (R3), U14.16 (SEG_B)
/MAX7219 Dot Matrix 10/MATRIX_1-SEG_C-R4: LED10.10 (R4), U14.20 (SEG_C)
/MAX7219 Dot Matrix 10/MATRIX_1-SEG_D-R5: LED10.6 (R5), U14.23 (SEG_D)
/MAX7219 Dot Matrix 10/MATRIX_1-SEG_DP-R1: LED10.13 (R1), U14.22 (SEG_DP)
/MAX7219 Dot Matrix 10/MATRIX_1-SEG_E-R6: LED10.11 (R6), U14.21 (SEG_E)
/MAX7219 Dot Matrix 10/MATRIX_1-SEG_F-R7: LED10.15 (R7), U14.15 (SEG_F)
/MAX7219 Dot Matrix 10/MATRIX_1-SEG_G-R8: LED10.16 (R8), U14.17 (SEG_G)
/MAX7219 Dot Matrix 11/DOUT: J109.1 (Pin_1_1), J114.1 (Pin_1_1), U15.24 (DOUT), U16.1 (DIN)
/MAX7219 Dot Matrix 11/MATRIX_1-DIG_0-C8: LED11.9 (C8), U15.2 (DIG_0)
/MAX7219 Dot Matrix 11/MATRIX_1-DIG_1-C7: LED11.14 (C7), U15.11 (DIG_1)
/MAX7219 Dot Matrix 11/MATRIX_1-DIG_2-C6: LED11.8 (C6), U15.6 (DIG_2)
/MAX7219 Dot Matrix 11/MATRIX_1-DIG_3-C5: LED11.12 (C5), U15.7 (DIG_3)
/MAX7219 Dot Matrix 11/MATRIX_1-DIG_4-C4: LED11.1 (C4), U15.3 (DIG_4)
/MAX7219 Dot Matrix 11/MATRIX_1-DIG_5-C3: LED11.7 (C3), U15.10 (DIG_5)
/MAX7219 Dot Matrix 11/MATRIX_1-DIG_6-C2: LED11.2 (C2), U15.5 (DIG_6)
/MAX7219 Dot Matrix 11/MATRIX_1-DIG_7-C1: LED11.5 (C1), U15.8 (DIG_7)
/MAX7219 Dot Matrix 11/MATRIX_1-SEG_A-R2: LED11.3 (R2), U15.14 (SEG_A)
/MAX7219 Dot Matrix 11/MATRIX_1-SEG_B-R3: LED11.4 (R3), U15.16 (SEG_B)
/MAX7219 Dot Matrix 11/MATRIX_1-SEG_C-R4: LED11.10 (R4), U15.20 (SEG_C)
/MAX7219 Dot Matrix 11/MATRIX_1-SEG_D-R5: LED11.6 (R5), U15.23 (SEG_D)
/MAX7219 Dot Matrix 11/MATRIX_1-SEG_DP-R1: LED11.13 (R1), U15.22 (SEG_DP)
/MAX7219 Dot Matrix 11/MATRIX_1-SEG_E-R6: LED11.11 (R6), U15.21 (SEG_E)
/MAX7219 Dot Matrix 11/MATRIX_1-SEG_F-R7: LED11.15 (R7), U15.15 (SEG_F)
/MAX7219 Dot Matrix 11/MATRIX_1-SEG_G-R8: LED11.16 (R8), U15.17 (SEG_G)
/MAX7219 Dot Matrix 12/DOUT: J119.1 (Pin_1_1), J124.1 (Pin_1_1), U16.24 (DOUT), U17.1 (DIN)
/MAX7219 Dot Matrix 12/MATRIX_1-DIG_0-C8: LED12.9 (C8), U16.2 (DIG_0)
/MAX7219 Dot Matrix 12/MATRIX_1-DIG_1-C7: LED12.14 (C7), U16.11 (DIG_1)
/MAX7219 Dot Matrix 12/MATRIX_1-DIG_2-C6: LED12.8 (C6), U16.6 (DIG_2)
/MAX7219 Dot Matrix 12/MATRIX_1-DIG_3-C5: LED12.12 (C5), U16.7 (DIG_3)
/MAX7219 Dot Matrix 12/MATRIX_1-DIG_4-C4: LED12.1 (C4), U16.3 (DIG_4)
/MAX7219 Dot Matrix 12/MATRIX_1-DIG_5-C3: LED12.7 (C3), U16.10 (DIG_5)
/MAX7219 Dot Matrix 12/MATRIX_1-DIG_6-C2: LED12.2 (C2), U16.5 (DIG_6)
/MAX7219 Dot Matrix 12/MATRIX_1-DIG_7-C1: LED12.5 (C1), U16.8 (DIG_7)
/MAX7219 Dot Matrix 12/MATRIX_1-SEG_A-R2: LED12.3 (R2), U16.14 (SEG_A)
/MAX7219 Dot Matrix 12/MATRIX_1-SEG_B-R3: LED12.4 (R3), U16.16 (SEG_B)
/MAX7219 Dot Matrix 12/MATRIX_1-SEG_C-R4: LED12.10 (R4), U16.20 (SEG_C)
/MAX7219 Dot Matrix 12/MATRIX_1-SEG_D-R5: LED12.6 (R5), U16.23 (SEG_D)
/MAX7219 Dot Matrix 12/MATRIX_1-SEG_DP-R1: LED12.13 (R1), U16.22 (SEG_DP)
/MAX7219 Dot Matrix 12/MATRIX_1-SEG_E-R6: LED12.11 (R6), U16.21 (SEG_E)
/MAX7219 Dot Matrix 12/MATRIX_1-SEG_F-R7: LED12.15 (R7), U16.15 (SEG_F)
/MAX7219 Dot Matrix 12/MATRIX_1-SEG_G-R8: LED12.16 (R8), U16.17 (SEG_G)
/MAX7219 Dot Matrix 13/DOUT: J129.1 (Pin_1_1), J134.1 (Pin_1_1), U17.24 (DOUT), U18.1 (DIN)
/MAX7219 Dot Matrix 13/MATRIX_1-DIG_0-C8: LED13.9 (C8), U17.2 (DIG_0)
/MAX7219 Dot Matrix 13/MATRIX_1-DIG_1-C7: LED13.14 (C7), U17.11 (DIG_1)
/MAX7219 Dot Matrix 13/MATRIX_1-DIG_2-C6: LED13.8 (C6), U17.6 (DIG_2)
/MAX7219 Dot Matrix 13/MATRIX_1-DIG_3-C5: LED13.12 (C5), U17.7 (DIG_3)
/MAX7219 Dot Matrix 13/MATRIX_1-DIG_4-C4: LED13.1 (C4), U17.3 (DIG_4)
/MAX7219 Dot Matrix 13/MATRIX_1-DIG_5-C3: LED13.7 (C3), U17.10 (DIG_5)
/MAX7219 Dot Matrix 13/MATRIX_1-DIG_6-C2: LED13.2 (C2), U17.5 (DIG_6)
/MAX7219 Dot Matrix 13/MATRIX_1-DIG_7-C1: LED13.5 (C1), U17.8 (DIG_7)
/MAX7219 Dot Matrix 13/MATRIX_1-SEG_A-R2: LED13.3 (R2), U17.14 (SEG_A)
/MAX7219 Dot Matrix 13/MATRIX_1-SEG_B-R3: LED13.4 (R3), U17.16 (SEG_B)
/MAX7219 Dot Matrix 13/MATRIX_1-SEG_C-R4: LED13.10 (R4), U17.20 (SEG_C)
/MAX7219 Dot Matrix 13/MATRIX_1-SEG_D-R5: LED13.6 (R5), U17.23 (SEG_D)
/MAX7219 Dot Matrix 13/MATRIX_1-SEG_DP-R1: LED13.13 (R1), U17.22 (SEG_DP)
/MAX7219 Dot Matrix 13/MATRIX_1-SEG_E-R6: LED13.11 (R6), U17.21 (SEG_E)
/MAX7219 Dot Matrix 13/MATRIX_1-SEG_F-R7: LED13.15 (R7), U17.15 (SEG_F)
/MAX7219 Dot Matrix 13/MATRIX_1-SEG_G-R8: LED13.16 (R8), U17.17 (SEG_G)
/MAX7219 Dot Matrix 14/DOUT: J139.1 (Pin_1_1), J144.1 (Pin_1_1), U18.24 (DOUT), U19.1 (DIN)
/MAX7219 Dot Matrix 14/MATRIX_1-DIG_0-C8: LED14.9 (C8), U18.2 (DIG_0)
/MAX7219 Dot Matrix 14/MATRIX_1-DIG_1-C7: LED14.14 (C7), U18.11 (DIG_1)
/MAX7219 Dot Matrix 14/MATRIX_1-DIG_2-C6: LED14.8 (C6), U18.6 (DIG_2)
/MAX7219 Dot Matrix 14/MATRIX_1-DIG_3-C5: LED14.12 (C5), U18.7 (DIG_3)
/MAX7219 Dot Matrix 14/MATRIX_1-DIG_4-C4: LED14.1 (C4), U18.3 (DIG_4)
/MAX7219 Dot Matrix 14/MATRIX_1-DIG_5-C3: LED14.7 (C3), U18.10 (DIG_5)
/MAX7219 Dot Matrix 14/MATRIX_1-DIG_6-C2: LED14.2 (C2), U18.5 (DIG_6)
/MAX7219 Dot Matrix 14/MATRIX_1-DIG_7-C1: LED14.5 (C1), U18.8 (DIG_7)
/MAX7219 Dot Matrix 14/MATRIX_1-SEG_A-R2: LED14.3 (R2), U18.14 (SEG_A)
/MAX7219 Dot Matrix 14/MATRIX_1-SEG_B-R3: LED14.4 (R3), U18.16 (SEG_B)
/MAX7219 Dot Matrix 14/MATRIX_1-SEG_C-R4: LED14.10 (R4), U18.20 (SEG_C)
/MAX7219 Dot Matrix 14/MATRIX_1-SEG_D-R5: LED14.6 (R5), U18.23 (SEG_D)
/MAX7219 Dot Matrix 14/MATRIX_1-SEG_DP-R1: LED14.13 (R1), U18.22 (SEG_DP)
/MAX7219 Dot Matrix 14/MATRIX_1-SEG_E-R6: LED14.11 (R6), U18.21 (SEG_E)
/MAX7219 Dot Matrix 14/MATRIX_1-SEG_F-R7: LED14.15 (R7), U18.15 (SEG_F)
/MAX7219 Dot Matrix 14/MATRIX_1-SEG_G-R8: LED14.16 (R8), U18.17 (SEG_G)
/MAX7219 Dot Matrix 15/DOUT: J149.1 (Pin_1_1), J154.1 (Pin_1_1), U19.24 (DOUT), U20.1 (DIN)
/MAX7219 Dot Matrix 15/MATRIX_1-DIG_0-C8: LED15.9 (C8), U19.2 (DIG_0)
/MAX7219 Dot Matrix 15/MATRIX_1-DIG_1-C7: LED15.14 (C7), U19.11 (DIG_1)
/MAX7219 Dot Matrix 15/MATRIX_1-DIG_2-C6: LED15.8 (C6), U19.6 (DIG_2)
/MAX7219 Dot Matrix 15/MATRIX_1-DIG_3-C5: LED15.12 (C5), U19.7 (DIG_3)
/MAX7219 Dot Matrix 15/MATRIX_1-DIG_4-C4: LED15.1 (C4), U19.3 (DIG_4)
/MAX7219 Dot Matrix 15/MATRIX_1-DIG_5-C3: LED15.7 (C3), U19.10 (DIG_5)
/MAX7219 Dot Matrix 15/MATRIX_1-DIG_6-C2: LED15.2 (C2), U19.5 (DIG_6)
/MAX7219 Dot Matrix 15/MATRIX_1-DIG_7-C1: LED15.5 (C1), U19.8 (DIG_7)
/MAX7219 Dot Matrix 15/MATRIX_1-SEG_A-R2: LED15.3 (R2), U19.14 (SEG_A)
/MAX7219 Dot Matrix 15/MATRIX_1-SEG_B-R3: LED15.4 (R3), U19.16 (SEG_B)
/MAX7219 Dot Matrix 15/MATRIX_1-SEG_C-R4: LED15.10 (R4), U19.20 (SEG_C)
/MAX7219 Dot Matrix 15/MATRIX_1-SEG_D-R5: LED15.6 (R5), U19.23 (SEG_D)
/MAX7219 Dot Matrix 15/MATRIX_1-SEG_DP-R1: LED15.13 (R1), U19.22 (SEG_DP)
/MAX7219 Dot Matrix 15/MATRIX_1-SEG_E-R6: LED15.11 (R6), U19.21 (SEG_E)
/MAX7219 Dot Matrix 15/MATRIX_1-SEG_F-R7: LED15.15 (R7), U19.15 (SEG_F)
/MAX7219 Dot Matrix 15/MATRIX_1-SEG_G-R8: LED15.16 (R8), U19.17 (SEG_G)
/MAX7219 Dot Matrix 16/DOUT: J159.1 (Pin_1_1), J164.1 (Pin_1_1), U20.24 (DOUT), U21.1 (DIN)
/MAX7219 Dot Matrix 16/MATRIX_1-DIG_0-C8: LED16.9 (C8), U20.2 (DIG_0)
/MAX7219 Dot Matrix 16/MATRIX_1-DIG_1-C7: LED16.14 (C7), U20.11 (DIG_1)
/MAX7219 Dot Matrix 16/MATRIX_1-DIG_2-C6: LED16.8 (C6), U20.6 (DIG_2)
/MAX7219 Dot Matrix 16/MATRIX_1-DIG_3-C5: LED16.12 (C5), U20.7 (DIG_3)
/MAX7219 Dot Matrix 16/MATRIX_1-DIG_4-C4: LED16.1 (C4), U20.3 (DIG_4)
/MAX7219 Dot Matrix 16/MATRIX_1-DIG_5-C3: LED16.7 (C3), U20.10 (DIG_5)
/MAX7219 Dot Matrix 16/MATRIX_1-DIG_6-C2: LED16.2 (C2), U20.5 (DIG_6)
/MAX7219 Dot Matrix 16/MATRIX_1-DIG_7-C1: LED16.5 (C1), U20.8 (DIG_7)
/MAX7219 Dot Matrix 16/MATRIX_1-SEG_A-R2: LED16.3 (R2), U20.14 (SEG_A)
/MAX7219 Dot Matrix 16/MATRIX_1-SEG_B-R3: LED16.4 (R3), U20.16 (SEG_B)
/MAX7219 Dot Matrix 16/MATRIX_1-SEG_C-R4: LED16.10 (R4), U20.20 (SEG_C)
/MAX7219 Dot Matrix 16/MATRIX_1-SEG_D-R5: LED16.6 (R5), U20.23 (SEG_D)
/MAX7219 Dot Matrix 16/MATRIX_1-SEG_DP-R1: LED16.13 (R1), U20.22 (SEG_DP)
/MAX7219 Dot Matrix 16/MATRIX_1-SEG_E-R6: LED16.11 (R6), U20.21 (SEG_E)
/MAX7219 Dot Matrix 16/MATRIX_1-SEG_F-R7: LED16.15 (R7), U20.15 (SEG_F)
/MAX7219 Dot Matrix 16/MATRIX_1-SEG_G-R8: LED16.16 (R8), U20.17 (SEG_G)
/MAX7219 Dot Matrix 17/DOUT: J169.1 (Pin_1_1), J174.1 (Pin_1_1), U21.24 (DOUT), U22.1 (DIN)
/MAX7219 Dot Matrix 17/MATRIX_1-DIG_0-C8: LED17.9 (C8), U21.2 (DIG_0)
/MAX7219 Dot Matrix 17/MATRIX_1-DIG_1-C7: LED17.14 (C7), U21.11 (DIG_1)
/MAX7219 Dot Matrix 17/MATRIX_1-DIG_2-C6: LED17.8 (C6), U21.6 (DIG_2)
/MAX7219 Dot Matrix 17/MATRIX_1-DIG_3-C5: LED17.12 (C5), U21.7 (DIG_3)
/MAX7219 Dot Matrix 17/MATRIX_1-DIG_4-C4: LED17.1 (C4), U21.3 (DIG_4)
/MAX7219 Dot Matrix 17/MATRIX_1-DIG_5-C3: LED17.7 (C3), U21.10 (DIG_5)
/MAX7219 Dot Matrix 17/MATRIX_1-DIG_6-C2: LED17.2 (C2), U21.5 (DIG_6)
/MAX7219 Dot Matrix 17/MATRIX_1-DIG_7-C1: LED17.5 (C1), U21.8 (DIG_7)
/MAX7219 Dot Matrix 17/MATRIX_1-SEG_A-R2: LED17.3 (R2), U21.14 (SEG_A)
/MAX7219 Dot Matrix 17/MATRIX_1-SEG_B-R3: LED17.4 (R3), U21.16 (SEG_B)
/MAX7219 Dot Matrix 17/MATRIX_1-SEG_C-R4: LED17.10 (R4), U21.20 (SEG_C)
/MAX7219 Dot Matrix 17/MATRIX_1-SEG_D-R5: LED17.6 (R5), U21.23 (SEG_D)
/MAX7219 Dot Matrix 17/MATRIX_1-SEG_DP-R1: LED17.13 (R1), U21.22 (SEG_DP)
/MAX7219 Dot Matrix 17/MATRIX_1-SEG_E-R6: LED17.11 (R6), U21.21 (SEG_E)
/MAX7219 Dot Matrix 17/MATRIX_1-SEG_F-R7: LED17.15 (R7), U21.15 (SEG_F)
/MAX7219 Dot Matrix 17/MATRIX_1-SEG_G-R8: LED17.16 (R8), U21.17 (SEG_G)
/MAX7219 Dot Matrix 18/DOUT: J179.1 (Pin_1_1), J184.1 (Pin_1_1), U22.24 (DOUT), U23.1 (DIN)
/MAX7219 Dot Matrix 18/MATRIX_1-DIG_0-C8: LED18.9 (C8), U22.2 (DIG_0)
/MAX7219 Dot Matrix 18/MATRIX_1-DIG_1-C7: LED18.14 (C7), U22.11 (DIG_1)
/MAX7219 Dot Matrix 18/MATRIX_1-DIG_2-C6: LED18.8 (C6), U22.6 (DIG_2)
/MAX7219 Dot Matrix 18/MATRIX_1-DIG_3-C5: LED18.12 (C5), U22.7 (DIG_3)
/MAX7219 Dot Matrix 18/MATRIX_1-DIG_4-C4: LED18.1 (C4), U22.3 (DIG_4)
/MAX7219 Dot Matrix 18/MATRIX_1-DIG_5-C3: LED18.7 (C3), U22.10 (DIG_5)
/MAX7219 Dot Matrix 18/MATRIX_1-DIG_6-C2: LED18.2 (C2), U22.5 (DIG_6)
/MAX7219 Dot Matrix 18/MATRIX_1-DIG_7-C1: LED18.5 (C1), U22.8 (DIG_7)
/MAX7219 Dot Matrix 18/MATRIX_1-SEG_A-R2: LED18.3 (R2), U22.14 (SEG_A)
/MAX7219 Dot Matrix 18/MATRIX_1-SEG_B-R3: LED18.4 (R3), U22.16 (SEG_B)
/MAX7219 Dot Matrix 18/MATRIX_1-SEG_C-R4: LED18.10 (R4), U22.20 (SEG_C)
/MAX7219 Dot Matrix 18/MATRIX_1-SEG_D-R5: LED18.6 (R5), U22.23 (SEG_D)
/MAX7219 Dot Matrix 18/MATRIX_1-SEG_DP-R1: LED18.13 (R1), U22.22 (SEG_DP)
/MAX7219 Dot Matrix 18/MATRIX_1-SEG_E-R6: LED18.11 (R6), U22.21 (SEG_E)
/MAX7219 Dot Matrix 18/MATRIX_1-SEG_F-R7: LED18.15 (R7), U22.15 (SEG_F)
/MAX7219 Dot Matrix 18/MATRIX_1-SEG_G-R8: LED18.16 (R8), U22.17 (SEG_G)
/MAX7219 Dot Matrix 19/DOUT: J189.1 (Pin_1_1), J194.1 (Pin_1_1), U23.24 (DOUT), U24.1 (DIN)
/MAX7219 Dot Matrix 19/MATRIX_1-DIG_0-C8: LED19.9 (C8), U23.2 (DIG_0)
/MAX7219 Dot Matrix 19/MATRIX_1-DIG_1-C7: LED19.14 (C7), U23.11 (DIG_1)
/MAX7219 Dot Matrix 19/MATRIX_1-DIG_2-C6: LED19.8 (C6), U23.6 (DIG_2)
/MAX7219 Dot Matrix 19/MATRIX_1-DIG_3-C5: LED19.12 (C5), U23.7 (DIG_3)
/MAX7219 Dot Matrix 19/MATRIX_1-DIG_4-C4: LED19.1 (C4), U23.3 (DIG_4)
/MAX7219 Dot Matrix 19/MATRIX_1-DIG_5-C3: LED19.7 (C3), U23.10 (DIG_5)
/MAX7219 Dot Matrix 19/MATRIX_1-DIG_6-C2: LED19.2 (C2), U23.5 (DIG_6)
/MAX7219 Dot Matrix 19/MATRIX_1-DIG_7-C1: LED19.5 (C1), U23.8 (DIG_7)
/MAX7219 Dot Matrix 19/MATRIX_1-SEG_A-R2: LED19.3 (R2), U23.14 (SEG_A)
/MAX7219 Dot Matrix 19/MATRIX_1-SEG_B-R3: LED19.4 (R3), U23.16 (SEG_B)
/MAX7219 Dot Matrix 19/MATRIX_1-SEG_C-R4: LED19.10 (R4), U23.20 (SEG_C)
/MAX7219 Dot Matrix 19/MATRIX_1-SEG_D-R5: LED19.6 (R5), U23.23 (SEG_D)
/MAX7219 Dot Matrix 19/MATRIX_1-SEG_DP-R1: LED19.13 (R1), U23.22 (SEG_DP)
/MAX7219 Dot Matrix 19/MATRIX_1-SEG_E-R6: LED19.11 (R6), U23.21 (SEG_E)
/MAX7219 Dot Matrix 19/MATRIX_1-SEG_F-R7: LED19.15 (R7), U23.15 (SEG_F)
/MAX7219 Dot Matrix 19/MATRIX_1-SEG_G-R8: LED19.16 (R8), U23.17 (SEG_G)
/MAX7219 Dot Matrix 20/DOUT: J199.1 (Pin_1_1), J204.1 (Pin_1_1), U24.24 (DOUT), U25.1 (DIN)
/MAX7219 Dot Matrix 20/MATRIX_1-DIG_0-C8: LED20.9 (C8), U24.2 (DIG_0)
/MAX7219 Dot Matrix 20/MATRIX_1-DIG_1-C7: LED20.14 (C7), U24.11 (DIG_1)
/MAX7219 Dot Matrix 20/MATRIX_1-DIG_2-C6: LED20.8 (C6), U24.6 (DIG_2)
/MAX7219 Dot Matrix 20/MATRIX_1-DIG_3-C5: LED20.12 (C5), U24.7 (DIG_3)
/MAX7219 Dot Matrix 20/MATRIX_1-DIG_4-C4: LED20.1 (C4), U24.3 (DIG_4)
/MAX7219 Dot Matrix 20/MATRIX_1-DIG_5-C3: LED20.7 (C3), U24.10 (DIG_5)
/MAX7219 Dot Matrix 20/MATRIX_1-DIG_6-C2: LED20.2 (C2), U24.5 (DIG_6)
/MAX7219 Dot Matrix 20/MATRIX_1-DIG_7-C1: LED20.5 (C1), U24.8 (DIG_7)
/MAX7219 Dot Matrix 20/MATRIX_1-SEG_A-R2: LED20.3 (R2), U24.14 (SEG_A)
/MAX7219 Dot Matrix 20/MATRIX_1-SEG_B-R3: LED20.4 (R3), U24.16 (SEG_B)
/MAX7219 Dot Matrix 20/MATRIX_1-SEG_C-R4: LED20.10 (R4), U24.20 (SEG_C)
/MAX7219 Dot Matrix 20/MATRIX_1-SEG_D-R5: LED20.6 (R5), U24.23 (SEG_D)
/MAX7219 Dot Matrix 20/MATRIX_1-SEG_DP-R1: LED20.13 (R1), U24.22 (SEG_DP)
/MAX7219 Dot Matrix 20/MATRIX_1-SEG_E-R6: LED20.11 (R6), U24.21 (SEG_E)
/MAX7219 Dot Matrix 20/MATRIX_1-SEG_F-R7: LED20.15 (R7), U24.15 (SEG_F)
/MAX7219 Dot Matrix 20/MATRIX_1-SEG_G-R8: LED20.16 (R8), U24.17 (SEG_G)
/MAX7219 Dot Matrix 21/DOUT: J209.1 (Pin_1_1), J214.1 (Pin_1_1), U25.24 (DOUT), U26.1 (DIN)
/MAX7219 Dot Matrix 21/MATRIX_1-DIG_0-C8: LED21.9 (C8), U25.2 (DIG_0)
/MAX7219 Dot Matrix 21/MATRIX_1-DIG_1-C7: LED21.14 (C7), U25.11 (DIG_1)
/MAX7219 Dot Matrix 21/MATRIX_1-DIG_2-C6: LED21.8 (C6), U25.6 (DIG_2)
/MAX7219 Dot Matrix 21/MATRIX_1-DIG_3-C5: LED21.12 (C5), U25.7 (DIG_3)
/MAX7219 Dot Matrix 21/MATRIX_1-DIG_4-C4: LED21.1 (C4), U25.3 (DIG_4)
/MAX7219 Dot Matrix 21/MATRIX_1-DIG_5-C3: LED21.7 (C3), U25.10 (DIG_5)
/MAX7219 Dot Matrix 21/MATRIX_1-DIG_6-C2: LED21.2 (C2), U25.5 (DIG_6)
/MAX7219 Dot Matrix 21/MATRIX_1-DIG_7-C1: LED21.5 (C1), U25.8 (DIG_7)
/MAX7219 Dot Matrix 21/MATRIX_1-SEG_A-R2: LED21.3 (R2), U25.14 (SEG_A)
/MAX7219 Dot Matrix 21/MATRIX_1-SEG_B-R3: LED21.4 (R3), U25.16 (SEG_B)
/MAX7219 Dot Matrix 21/MATRIX_1-SEG_C-R4: LED21.10 (R4), U25.20 (SEG_C)
/MAX7219 Dot Matrix 21/MATRIX_1-SEG_D-R5: LED21.6 (R5), U25.23 (SEG_D)
/MAX7219 Dot Matrix 21/MATRIX_1-SEG_DP-R1: LED21.13 (R1), U25.22 (SEG_DP)
/MAX7219 Dot Matrix 21/MATRIX_1-SEG_E-R6: LED21.11 (R6), U25.21 (SEG_E)
/MAX7219 Dot Matrix 21/MATRIX_1-SEG_F-R7: LED21.15 (R7), U25.15 (SEG_F)
/MAX7219 Dot Matrix 21/MATRIX_1-SEG_G-R8: LED21.16 (R8), U25.17 (SEG_G)
/MAX7219 Dot Matrix 22/DOUT: J219.1 (Pin_1_1), J224.1 (Pin_1_1), U26.24 (DOUT), U27.1 (DIN)
/MAX7219 Dot Matrix 22/MATRIX_1-DIG_0-C8: LED22.9 (C8), U26.2 (DIG_0)
/MAX7219 Dot Matrix 22/MATRIX_1-DIG_1-C7: LED22.14 (C7), U26.11 (DIG_1)
/MAX7219 Dot Matrix 22/MATRIX_1-DIG_2-C6: LED22.8 (C6), U26.6 (DIG_2)
/MAX7219 Dot Matrix 22/MATRIX_1-DIG_3-C5: LED22.12 (C5), U26.7 (DIG_3)
/MAX7219 Dot Matrix 22/MATRIX_1-DIG_4-C4: LED22.1 (C4), U26.3 (DIG_4)
/MAX7219 Dot Matrix 22/MATRIX_1-DIG_5-C3: LED22.7 (C3), U26.10 (DIG_5)
/MAX7219 Dot Matrix 22/MATRIX_1-DIG_6-C2: LED22.2 (C2), U26.5 (DIG_6)
/MAX7219 Dot Matrix 22/MATRIX_1-DIG_7-C1: LED22.5 (C1), U26.8 (DIG_7)
/MAX7219 Dot Matrix 22/MATRIX_1-SEG_A-R2: LED22.3 (R2), U26.14 (SEG_A)
/MAX7219 Dot Matrix 22/MATRIX_1-SEG_B-R3: LED22.4 (R3), U26.16 (SEG_B)
/MAX7219 Dot Matrix 22/MATRIX_1-SEG_C-R4: LED22.10 (R4), U26.20 (SEG_C)
/MAX7219 Dot Matrix 22/MATRIX_1-SEG_D-R5: LED22.6 (R5), U26.23 (SEG_D)
/MAX7219 Dot Matrix 22/MATRIX_1-SEG_DP-R1: LED22.13 (R1), U26.22 (SEG_DP)
/MAX7219 Dot Matrix 22/MATRIX_1-SEG_E-R6: LED22.11 (R6), U26.21 (SEG_E)
/MAX7219 Dot Matrix 22/MATRIX_1-SEG_F-R7: LED22.15 (R7), U26.15 (SEG_F)
/MAX7219 Dot Matrix 22/MATRIX_1-SEG_G-R8: LED22.16 (R8), U26.17 (SEG_G)
/MAX7219 Dot Matrix 23/DOUT: J229.1 (Pin_1_1), J234.1 (Pin_1_1), U27.24 (DOUT), U28.1 (DIN)
/MAX7219 Dot Matrix 23/MATRIX_1-DIG_0-C8: LED23.9 (C8), U27.2 (DIG_0)
/MAX7219 Dot Matrix 23/MATRIX_1-DIG_1-C7: LED23.14 (C7), U27.11 (DIG_1)
/MAX7219 Dot Matrix 23/MATRIX_1-DIG_2-C6: LED23.8 (C6), U27.6 (DIG_2)
/MAX7219 Dot Matrix 23/MATRIX_1-DIG_3-C5: LED23.12 (C5), U27.7 (DIG_3)
/MAX7219 Dot Matrix 23/MATRIX_1-DIG_4-C4: LED23.1 (C4), U27.3 (DIG_4)
/MAX7219 Dot Matrix 23/MATRIX_1-DIG_5-C3: LED23.7 (C3), U27.10 (DIG_5)
/MAX7219 Dot Matrix 23/MATRIX_1-DIG_6-C2: LED23.2 (C2), U27.5 (DIG_6)
/MAX7219 Dot Matrix 23/MATRIX_1-DIG_7-C1: LED23.5 (C1), U27.8 (DIG_7)
/MAX7219 Dot Matrix 23/MATRIX_1-SEG_A-R2: LED23.3 (R2), U27.14 (SEG_A)
/MAX7219 Dot Matrix 23/MATRIX_1-SEG_B-R3: LED23.4 (R3), U27.16 (SEG_B)
/MAX7219 Dot Matrix 23/MATRIX_1-SEG_C-R4: LED23.10 (R4), U27.20 (SEG_C)
/MAX7219 Dot Matrix 23/MATRIX_1-SEG_D-R5: LED23.6 (R5), U27.23 (SEG_D)
/MAX7219 Dot Matrix 23/MATRIX_1-SEG_DP-R1: LED23.13 (R1), U27.22 (SEG_DP)
/MAX7219 Dot Matrix 23/MATRIX_1-SEG_E-R6: LED23.11 (R6), U27.21 (SEG_E)
/MAX7219 Dot Matrix 23/MATRIX_1-SEG_F-R7: LED23.15 (R7), U27.15 (SEG_F)
/MAX7219 Dot Matrix 23/MATRIX_1-SEG_G-R8: LED23.16 (R8), U27.17 (SEG_G)
/MAX7219 Dot Matrix 24/MATRIX_1-DIG_0-C8: LED24.9 (C8), U28.2 (DIG_0)
/MAX7219 Dot Matrix 24/MATRIX_1-DIG_1-C7: LED24.14 (C7), U28.11 (DIG_1)
/MAX7219 Dot Matrix 24/MATRIX_1-DIG_2-C6: LED24.8 (C6), U28.6 (DIG_2)
/MAX7219 Dot Matrix 24/MATRIX_1-DIG_3-C5: LED24.12 (C5), U28.7 (DIG_3)
/MAX7219 Dot Matrix 24/MATRIX_1-DIG_4-C4: LED24.1 (C4), U28.3 (DIG_4)
/MAX7219 Dot Matrix 24/MATRIX_1-DIG_5-C3: LED24.7 (C3), U28.10 (DIG_5)
/MAX7219 Dot Matrix 24/MATRIX_1-DIG_6-C2: LED24.2 (C2), U28.5 (DIG_6)
/MAX7219 Dot Matrix 24/MATRIX_1-DIG_7-C1: LED24.5 (C1), U28.8 (DIG_7)
/MAX7219 Dot Matrix 24/MATRIX_1-SEG_A-R2: LED24.3 (R2), U28.14 (SEG_A)
/MAX7219 Dot Matrix 24/MATRIX_1-SEG_B-R3: LED24.4 (R3), U28.16 (SEG_B)
/MAX7219 Dot Matrix 24/MATRIX_1-SEG_C-R4: LED24.10 (R4), U28.20 (SEG_C)
/MAX7219 Dot Matrix 24/MATRIX_1-SEG_D-R5: LED24.6 (R5), U28.23 (SEG_D)
/MAX7219 Dot Matrix 24/MATRIX_1-SEG_DP-R1: LED24.13 (R1), U28.22 (SEG_DP)
/MAX7219 Dot Matrix 24/MATRIX_1-SEG_E-R6: LED24.11 (R6), U28.21 (SEG_E)
/MAX7219 Dot Matrix 24/MATRIX_1-SEG_F-R7: LED24.15 (R7), U28.15 (SEG_F)
/MAX7219 Dot Matrix 24/MATRIX_1-SEG_G-R8: LED24.16 (R8), U28.17 (SEG_G)
CLK: J15.1 (Pin_1_1), J20.1 (Pin_1_1), J25.1 (Pin_1_1), J30.1 (Pin_1_1), J35.1 (Pin_1_1), J40.1 (Pin_1_1), J45.1 (Pin_1_1), J50.1 (Pin_1_1), J55.1 (Pin_1_1), J60.1 (Pin_1_1), J65.1 (Pin_1_1), J70.1 (Pin_1_1), J75.1 (Pin_1_1), J80.1 (Pin_1_1), J85.1 (Pin_1_1), J90.1 (Pin_1_1), J95.1 (Pin_1_1), J100.1 (Pin_1_1), J105.1 (Pin_1_1), J110.1 (Pin_1_1), J115.1 (Pin_1_1), J120.1 (Pin_1_1), J125.1 (Pin_1_1), J130.1 (Pin_1_1), J135.1 (Pin_1_1), J140.1 (Pin_1_1), J145.1 (Pin_1_1), J150.1 (Pin_1_1), J155.1 (Pin_1_1), J160.1 (Pin_1_1), J165.1 (Pin_1_1), J170.1 (Pin_1_1), J175.1 (Pin_1_1), J180.1 (Pin_1_1), J185.1 (Pin_1_1), J190.1 (Pin_1_1), J195.1 (Pin_1_1), J200.1 (Pin_1_1), J205.1 (Pin_1_1), J210.1 (Pin_1_1), J215.1 (Pin_1_1), J220.1 (Pin_1_1), J225.1 (Pin_1_1), J230.1 (Pin_1_1), J235.1 (Pin_1_1), J240.1 (Pin_1_1), U6.13 (CLK), U7.13 (CLK), U8.13 (CLK), U9.13 (CLK), U10.13 (CLK), U11.13 (CLK), U12.13 (CLK), U13.13 (CLK), U14.13 (CLK), U15.13 (CLK), U16.13 (CLK), U17.13 (CLK), U18.13 (CLK), U19.13 (CLK), U20.13 (CLK), U21.13 (CLK), U22.13 (CLK), U23.13 (CLK), U24.13 (CLK), U25.13 (CLK), U26.13 (CLK), U27.13 (CLK), U28.13 (CLK); also elsewhere on the board
CS: J16.1 (Pin_1_1), J21.1 (Pin_1_1), J26.1 (Pin_1_1), J31.1 (Pin_1_1), J36.1 (Pin_1_1), J41.1 (Pin_1_1), J46.1 (Pin_1_1), J51.1 (Pin_1_1), J56.1 (Pin_1_1), J61.1 (Pin_1_1), J66.1 (Pin_1_1), J71.1 (Pin_1_1), J76.1 (Pin_1_1), J81.1 (Pin_1_1), J86.1 (Pin_1_1), J91.1 (Pin_1_1), J96.1 (Pin_1_1), J101.1 (Pin_1_1), J106.1 (Pin_1_1), J111.1 (Pin_1_1), J116.1 (Pin_1_1), J121.1 (Pin_1_1), J126.1 (Pin_1_1), J131.1 (Pin_1_1), J136.1 (Pin_1_1), J141.1 (Pin_1_1), J146.1 (Pin_1_1), J151.1 (Pin_1_1), J156.1 (Pin_1_1), J161.1 (Pin_1_1), J166.1 (Pin_1_1), J171.1 (Pin_1_1), J176.1 (Pin_1_1), J181.1 (Pin_1_1), J186.1 (Pin_1_1), J191.1 (Pin_1_1), J196.1 (Pin_1_1), J201.1 (Pin_1_1), J206.1 (Pin_1_1), J211.1 (Pin_1_1), J216.1 (Pin_1_1), J221.1 (Pin_1_1), J226.1 (Pin_1_1), J231.1 (Pin_1_1), J236.1 (Pin_1_1), J241.1 (Pin_1_1), U6.12 (LOAD), U7.12 (LOAD), U8.12 (LOAD), U9.12 (LOAD), U10.12 (LOAD), U11.12 (LOAD), U12.12 (LOAD), U13.12 (LOAD), U14.12 (LOAD), U15.12 (LOAD), U16.12 (LOAD), U17.12 (LOAD), U18.12 (LOAD), U19.12 (LOAD), U20.12 (LOAD), U21.12 (LOAD), U22.12 (LOAD), U23.12 (LOAD), U24.12 (LOAD), U25.12 (LOAD), U26.12 (LOAD), U27.12 (LOAD), U28.12 (LOAD); also elsewhere on the board
DOUT: J239.1 (Pin_1_1), U28.24 (DOUT); also elsewhere on the board
GND: C12.2, C13.2, C14.2, C15.2, C16.2, C17.2, C18.2, C19.2, C20.2, C21.2, C22.2, C23.2, C24.2, C25.2, C26.2, C27.2, C28.2, C29.2, C30.2, C31.2, C32.2, C33.2, C34.2, J17.1 (Pin_1_1), J22.1 (Pin_1_1), J27.1 (Pin_1_1), J32.1 (Pin_1_1), J37.1 (Pin_1_1), J42.1 (Pin_1_1), J47.1 (Pin_1_1), J52.1 (Pin_1_1), J57.1 (Pin_1_1), J62.1 (Pin_1_1), J67.1 (Pin_1_1), J72.1 (Pin_1_1), J77.1 (Pin_1_1), J82.1 (Pin_1_1), J87.1 (Pin_1_1), J92.1 (Pin_1_1), J97.1 (Pin_1_1), J102.1 (Pin_1_1), J107.1 (Pin_1_1), J112.1 (Pin_1_1), J117.1 (Pin_1_1), J122.1 (Pin_1_1), J127.1 (Pin_1_1), J132.1 (Pin_1_1), J137.1 (Pin_1_1), J142.1 (Pin_1_1), J147.1 (Pin_1_1), J152.1 (Pin_1_1), J157.1 (Pin_1_1), J162.1 (Pin_1_1), J167.1 (Pin_1_1), J172.1 (Pin_1_1), J177.1 (Pin_1_1), J182.1 (Pin_1_1), J187.1 (Pin_1_1), J192.1 (Pin_1_1), J197.1 (Pin_1_1), J202.1 (Pin_1_1), J207.1 (Pin_1_1), J212.1 (Pin_1_1), J217.1 (Pin_1_1), J222.1 (Pin_1_1), J227.1 (Pin_1_1), J232.1 (Pin_1_1), J237.1 (Pin_1_1), J242.1 (Pin_1_1), U6.4 (GND), U6.9 (GND), U7.4 (GND), U7.9 (GND), U8.4 (GND), U8.9 (GND), U9.4 (GND), U9.9 (GND), U10.4 (GND), U10.9 (GND), U11.4 (GND), U11.9 (GND), U12.4 (GND), U12.9 (GND), U13.4 (GND), U13.9 (GND), U14.4 (GND), U14.9 (GND), U15.4 (GND), U15.9 (GND), U16.4 (GND), U16.9 (GND), U17.4 (GND), U17.9 (GND), U18.4 (GND), U18.9 (GND), U19.4 (GND), U19.9 (GND), U20.4 (GND), U20.9 (GND), U21.4 (GND), U21.9 (GND), U22.4 (GND), U22.9 (GND), U23.4 (GND), U23.9 (GND), U24.4 (GND), U24.9 (GND), U25.4 (GND), U25.9 (GND), U26.4 (GND), U26.9 (GND), U27.4 (GND), U27.9 (GND), U28.4 (GND), U28.9 (GND); also elsewhere on the board
unnamed: R12.2, U6.18 (ISET)
unnamed: R13.2, U7.18 (ISET)
unnamed: R14.2, U8.18 (ISET)
unnamed: R15.2, U9.18 (ISET)
unnamed: R16.2, U10.18 (ISET)
unnamed: R17.2, U11.18 (ISET)
unnamed: R18.2, U12.18 (ISET)
unnamed: R19.2, U13.18 (ISET)
unnamed: R20.2, U14.18 (ISET)
unnamed: R21.2, U15.18 (ISET)
unnamed: R22.2, U16.18 (ISET)
unnamed: R23.2, U17.18 (ISET)
unnamed: R24.2, U18.18 (ISET)
unnamed: R25.2, U19.18 (ISET)
unnamed: R26.2, U20.18 (ISET)
unnamed: R27.2, U21.18 (ISET)
unnamed: R28.2, U22.18 (ISET)
unnamed: R29.2, U23.18 (ISET)
unnamed: R30.2, U24.18 (ISET)
unnamed: R31.2, U25.18 (ISET)
unnamed: R32.2, U26.18 (ISET)
unnamed: R33.2, U27.18 (ISET)
unnamed: R34.2, U28.18 (ISET)

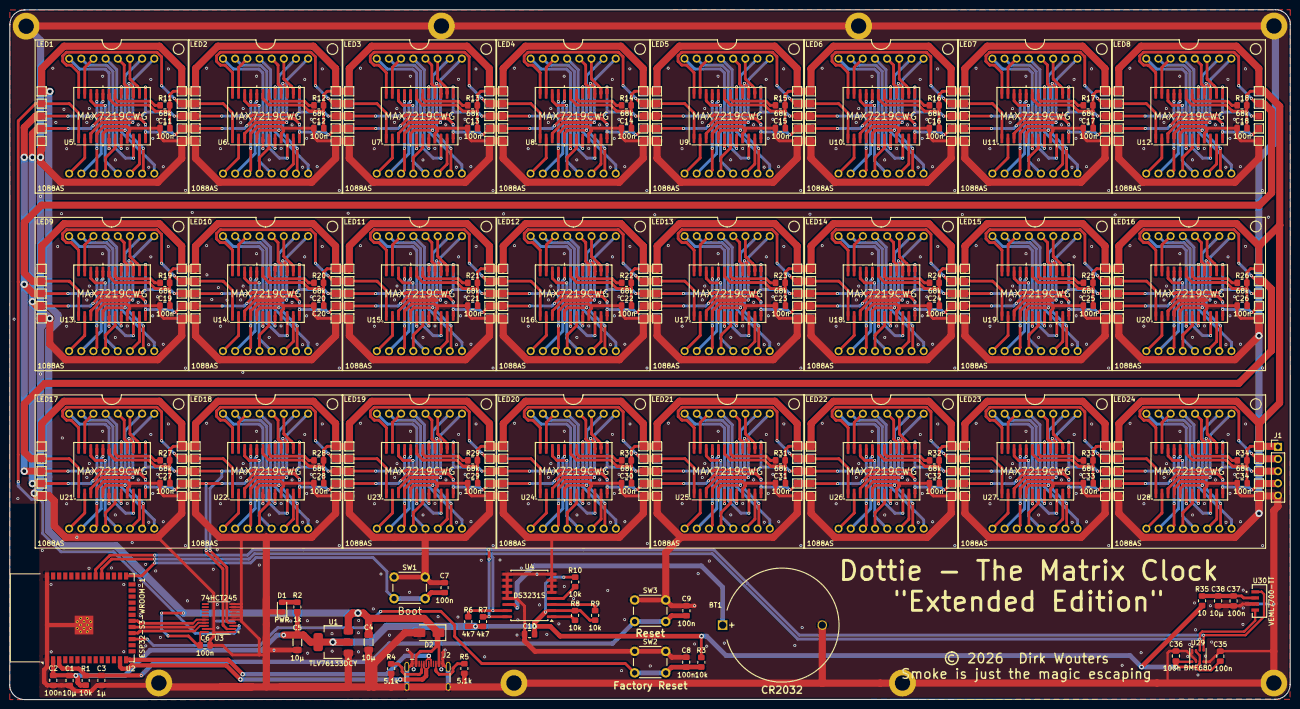
[picture p6: board NTP Dot Matrix Clock 64x32.kicad_pcb from above]

Board: 2 copper layers, 267.4 x 144.1 mm, 383 parts (0 on the bottom side), 456 nets.
