diwou/Dottie_-_The_Matrix_Clock_Extended_Edition/src/ClockWebUi.h

#pragma once

#include "platform_compat.h"
#include "config.h"
#include <Update.h>

extern ClockWebServer server;
extern DNSServer        dnsServer;

// Deferred SPI actions: web task must not call mx.*() directly.
extern void requestBrightnessFromLoop();

static bool firmwareUpdateOk = false;
static String firmwareUpdateError;

// ============================================================
// Web-UI: HTML-Hilfsfunktionen (Streaming)
// ============================================================
static void chunk(const String& s)              { server.sendContent(s); yield(); }
static void chunk(const __FlashStringHelper* s) { server.sendContent(s); yield(); }

// ============================================================
// HTML-Escape / Form-Helpers
// ============================================================
static String htmlEscape(String s) {
  s.replace(F("&"),  F("&amp;"));
  s.replace(F("<"),  F("&lt;"));
  s.replace(F(">"),  F("&gt;"));
  s.replace(F("\""), F("&quot;"));
  s.replace(F("'"),  F("&#39;"));
  return s;
}
static String jsonEscape(const String& s) {
  String out;
  out.reserve(s.length() + 8);
  for (uint16_t i = 0; i < s.length(); i++) {
    char c = s[i];
    if      (c == '"')  out += "\\\"";
    else if (c == '\\') out += "\\\\";
    else if (c == '\n') out += "\\n";
    else if (c == '\r') {}
    else if ((uint8_t)c < 0x20) {}
    else                out += c;
  }
  return out;
}
static const char* checked(bool v)  { return v ? " checked"  : ""; }
static const char* selected(bool v) { return v ? " selected" : ""; }

static const char* dstModeLabel(uint8_t m) {
  switch (m) {
    case 0:  return "Aus";
    case 1:  return "EU (letzter So. Mär/Okt)";
    case 2:  return "US (2. So. Mär / 1. So. Nov)";
    default: return "Benutzerdefiniert (M.w.d/h)";
  }
}

// ============================================================
// Web-UI: handleRoot() — modernes Tab-Design
// ============================================================
static void handleRoot() {
  bool inAP = WiFi.getMode() & WIFI_AP;
  String lux_s = isfinite(luxHold) ? (String(luxHold, 1) + " lx") : String("-");
  String bl_s = String((int)displayIntensityApplied) + " / 15";
  String sensor_s = vemlOk ? F("OK") : F("nicht gefunden");
  String auto_s = cfg.auto_brightness ? F("aktiv") : F("aus");

  server.setContentLength(CONTENT_LENGTH_UNKNOWN);
  server.send(200, F("text/html"), "");

  // ---- HEAD & CSS ----
  chunk(F("<!doctype html><html lang='de'><head>"
          "<meta charset='utf-8'>"
          "<meta name='viewport' content='width=device-width,initial-scale=1'>"
          "<title>Dottie - The Matrix Clock 'Extended Version'</title>"
          "<style>"
          ":root{--c:#3b82f6;--bg:#f8fafc;--card:#fff;--border:#e2e8f0;--text:#1e293b;--muted:#64748b;--soft:#f8fafc;--tab:#e5e7eb;--shadow:rgba(15,23,42,.10)}"
          "body.theme-dark{--c:#60a5fa;--bg:#11161d;--card:#1b222c;--border:#303a49;--text:#e8edf4;--muted:#a3afbf;--soft:#161d26;--tab:#2b3441;--shadow:rgba(0,0,0,.30)}"
          "body{font-family:system-ui,Arial,sans-serif;margin:0;background:var(--bg);color:var(--text)}"
          ".hdr{background:var(--c);color:#fff;padding:10px 16px;display:flex;align-items:center;gap:10px;flex-wrap:wrap}"
          ".hdr h1{margin:0;font-size:1.2rem;flex:1}"
          ".hdr h1{margin:0;font-size:1.3rem}"
          ".badge{background:rgba(255,255,255,.2);border-radius:6px;padding:2px 8px;font-size:.8rem}"
          ".wrap{max-width:860px;margin:auto;padding:16px}"
          ".tabs{display:flex;gap:4px;margin-bottom:16px;flex-wrap:wrap}"
          ".tab{padding:8px 16px;border-radius:8px 8px 0 0;cursor:pointer;background:var(--tab);"
               "border:1px solid var(--border);border-bottom:none;font-size:.9rem}"
          ".tab.active{background:var(--card);border-color:var(--border);color:var(--c);font-weight:600}"
          ".panel{display:none;background:var(--card);border:1px solid var(--border);"
                 "border-radius:0 8px 8px 8px;padding:20px}"
          ".panel.active{display:block}"
          ".row2{display:grid;grid-template-columns:1fr 1fr;gap:14px}"
          ".row3{display:grid;grid-template-columns:1fr 1fr 1fr;gap:14px}"
          "label{display:block;font-size:.85rem;font-weight:600;margin:10px 0 3px;color:var(--muted)}"
          "input,select{width:100%;padding:8px 10px;border:1px solid var(--border);"
                       "border-radius:6px;font-size:.95rem;box-sizing:border-box;background:var(--soft);color:var(--text)}"
          "input:focus,select:focus{outline:2px solid var(--c)}"
          "input:disabled{opacity:.45}"
          ".chk{display:flex;align-items:center;gap:8px;margin:10px 0}"
          ".chk input{width:auto}"
          "button{padding:9px 16px;font-size:.95rem;border-radius:6px;border:none;"
                 "cursor:pointer;background:var(--c);color:#fff}"
          "button:hover{filter:brightness(1.1)}"
          ".btn-danger{background:#ef4444}"
          ".btn-sec{background:var(--muted)}"
          ".stat{background:var(--soft);border-radius:8px;padding:12px;margin:8px 0;font-size:.9rem}"
          ".stat b{color:var(--c)}"
          ".ok{color:#16a34a} .fail{color:#dc2626}"
          ".mono{font-family:monospace;font-size:.82rem;white-space:pre-wrap;background:var(--soft);"
                "padding:10px;border-radius:6px;margin:6px 0}"
          ".hint{font-size:.8rem;color:var(--muted);margin-top:3px}"
          "h3{margin:0 0 12px;font-size:1rem;border-bottom:1px solid var(--border);padding-bottom:6px}"
          "@media(max-width:600px){.row2,.row3{grid-template-columns:1fr}}"
          ".dm-panel{background:#0a0a0a;border:1px solid #1e1e2a;border-radius:10px;padding:10px 14px 8px;margin-left:auto;box-shadow:0 0 24px rgba(255,140,0,.08),inset 0 0 20px rgba(0,0,0,.6);}"
          ".dm-lbl{font-size:8px;letter-spacing:2px;color:#2a2a3a;text-align:center;text-transform:uppercase;margin-bottom:5px;font-family:monospace;}"
          ".dm-div{height:1px;background:linear-gradient(to right,transparent,#1a1a2a,transparent);margin:5px 0;}"
          ".chart-wrap{background:var(--soft);border-radius:8px;padding:12px;margin-bottom:6px;border:1px solid var(--border)}"
          ".chart{height:140px;width:100%;margin-top:8px;position:relative}"
          ".chart svg{width:100%;height:100%;display:block;overflow:visible}"
          ".chart-line{fill:none;stroke-width:2.5;stroke-linecap:round;stroke-linejoin:round}"
          ".chart-area{opacity:0.15}"
          ".chart-grid{stroke:var(--border);stroke-width:1;stroke-dasharray:4,4}"
          ".chart-lbl{font-size:11px;fill:var(--muted);font-weight:600}"
          ".w-table{width:100%;border-collapse:collapse;margin:10px 0 16px;background:var(--soft);border-radius:8px;overflow:hidden}"
          ".w-table th,.w-table td{padding:8px 12px;text-align:center;border-bottom:1px solid var(--border);font-size:.9rem}"
          ".w-table th{background:rgba(59,130,246,0.1);color:var(--text);font-weight:600;font-size:.85rem;text-transform:uppercase}"
          ".w-table tr:last-child td{border-bottom:none}"
          ".w-day{font-weight:600;text-align:left!important}"
          ".w-max{color:#ef4444;font-weight:600} .w-min{color:#3b82f6;font-weight:600}"
          "</style>"
          "<script>"
          "function showTab(id){"
          "document.querySelectorAll('.tab,.panel').forEach(e=>e.classList.remove('active'));"
          "document.getElementById('t_'+id).classList.add('active');"
          "document.getElementById('p_'+id).classList.add('active');"
          "localStorage.setItem('tab',id);"
          "if(id=='env'||id=='env365')updHistory();}"
          "function updHistory(){"
          "fetch('/api/history').then(r=>r.json()).then(d=>{"
          "if(!d||!d.length)return;"
          "renderC('c_temp',d,'t','#3b82f6','\u00B0C');"
          "renderC('c_humi',d,'h','#84cc16','%');"
          "renderC('c_pres',d,'p','#f97316','hPa');"
          "renderC('c_iaq',d,'i','#ef4444','');"
          "renderC('c_dew',d,'d','#0ea5e9','\u00B0C');"
          "renderC('c_heat',d,'x','#a855f7','\\u00B0C');"
          "renderC('c_abs',d,'a','#06b6d4',' g/m³',true);"
          "}).catch(e=>console.error(e));"
          "fetch('/api/history_month').then(r=>r.json()).then(d=>{"
          "renderCMonth('cm_temp',d,'td','tn','#facc15','#3b82f6','\u00B0C');"
          "renderCMonth('cm_humi',d,'hd','hn','#a3e635','#4d7c0f','%');"
          "renderCMonth('cm_pres',d,'pd','pn','#fb923c','#c2410c','hPa');"
          "renderCMonth('cm_iaq',d,'id','in','#f87171','#b91c1c','');"
          "renderCMonth('cm_dew',d,'dd','dn','#38bdf8','#0284c7','\u00B0C');"
          "renderCMonth('cm_heat',d,'xd','xn','#c084fc','#7e22ce','\\u00B0C');"
          "renderCMonth('cm_abs',d,'ad','an','#22d3ee','#0891b2',' g/m³',true);"
          "}).catch(e=>console.error(e));"
          "fetch('/api/history_year').then(r=>r.json()).then(d=>{"
          "renderCYear('cy_temp',d,'tmax','tmin','#facc15','#3b82f6','\u00B0C');"
          "renderCYear('cy_humi',d,'hmax','hmin','#a3e635','#4d7c0f','%');"
          "renderCYear('cy_pres',d,'pmax','pmin','#fb923c','#c2410c','hPa');"
          "renderCYear('cy_iaq',d,'imax','imin','#f87171','#b91c1c','');"
          "renderCYear('cy_dew',d,'dmax','dmin','#38bdf8','#0284c7','\u00B0C');"
          "renderCYear('cy_heat',d,'xmax','xmin','#c084fc','#7e22ce','\\u00B0C');"
          "renderCYear('cy_abs',d,'amax','amin','#22d3ee','#0891b2',' g/m³',true);"
          "renderWTable(d);"
          "}).catch(e=>console.error(e));}"
          "function renderWTable(d){"
          "var el=document.getElementById('w_table_div'); if(!el||!d)return;"
          "var html='<table class=\"w-table\"><tr><th class=\"w-day\">Rückblick</th><th>Temperatur</th><th>Feuchte</th><th>Luftdruck</th></tr>';"
          "var days=['So','Mo','Di','Mi','Do','Fr','Sa'];"
          "var now=new Date();"
          "for(var i=0;i<7;i++){"
          "  if(i>=d.length)break;"
          "  var idx = d.length - 1 - i;"
          "  var e = d[idx];"
          "  var date = new Date(now.getTime() - (i+1)*86400000);"
          "  var dayStr = i==0?'Gestern':(i==1?'Vorgestern':days[date.getDay()]);"
          "  html+='<tr><td class=\"w-day\">'+dayStr+'</td>';"
          "  html+='<td><span class=\"w-max\">'+e.tmax.toFixed(1)+'\u00B0</span> / <span class=\"w-min\">'+e.tmin.toFixed(1)+'\u00B0</span></td>';"
          "  html+='<td><span class=\"w-max\">'+e.hmax.toFixed(0)+'%</span> / <span class=\"w-min\">'+e.hmin.toFixed(0)+'%</span></td>';"
          "  html+='<td><span class=\"w-max\">'+e.pmax.toFixed(0)+'</span> / <span class=\"w-min\">'+e.pmin.toFixed(0)+'</span></td></tr>';"
          "}"
          "html+='</table>';"
          "el.innerHTML=html;}"
          "function renderC(id,data,key,col,unit,isAbs){"
          "var el=document.getElementById(id); if(!el)return;"
          "var w=el.clientWidth, h=el.clientHeight, pad=20, slots=287;"
          "var vals=data.map(e=>e[key]);"
          "var min=Math.min(...vals), max=Math.max(...vals);"
          "if(max==min){min-=1;max+=1;} var ran=max-min;"
          "if(isAbs){min=0;max=Math.max(max,20);ran=max-min;}"
          "var pts=vals.map((v,i)=>({"
          "x:((slots-(data.length-1-i))/slots)*w,"
          "y:h-pad-((v-min)/ran)*(h-pad*2)}));"
          "var dLine='M'+pts.map(p=>p.x+','+p.y).join('L');"
          "var dArea=dLine+'L'+w+','+h+'L0,'+h+'Z';"
          "var rects='';"
          "if(isAbs){"
          "  var gy=v=>{var yy=h-pad-((v-min)/ran)*(h-pad*2);return yy<pad?pad:(yy>(h-pad)?(h-pad):yy);};"
          "  var r=(yT,yB,c)=>'<rect x=\"0\" y=\"'+yT+'\" width=\"'+w+'\" height=\"'+(yB-yT)+'\" fill=\"'+c+'\"/>';"
          "  rects=r(gy(25),gy(16),'rgba(239,68,68,0.15)')+r(gy(16),gy(13.5),'rgba(249,115,22,0.15)')+r(gy(13.5),gy(11),'rgba(250,204,21,0.15)')+r(gy(11),gy(7),'rgba(34,197,94,0.15)')+r(gy(7),gy(5),'rgba(250,204,21,0.15)')+r(gy(5),gy(0),'rgba(249,115,22,0.15)');"
          "}"
          "var svg='<svg viewBox=\"0 0 '+w+' '+h+'\">'+rects+"
          "'<line class=\"chart-grid\" x1=\"0\" y1=\"'+(h-pad)+'\" x2=\"'+w+'\" y2=\"'+(h-pad)+'\"/>'+"
          "'<line class=\"chart-grid\" x1=\"0\" y1=\"'+pad+'\" x2=\"'+w+'\" y2=\"'+pad+'\"/>'+"
          "'<line class=\"chart-grid\" x1=\"'+(w*0.25)+'\" y1=\"'+pad+'\" x2=\"'+(w*0.25)+'\" y2=\"'+(h-pad)+'\"/>'+"
          "'<line class=\"chart-grid\" x1=\"'+(w*0.5)+'\" y1=\"'+pad+'\" x2=\"'+(w*0.5)+'\" y2=\"'+(h-pad)+'\"/>'+"
          "'<line class=\"chart-grid\" x1=\"'+(w*0.75)+'\" y1=\"'+pad+'\" x2=\"'+(w*0.75)+'\" y2=\"'+(h-pad)+'\"/>'+"
          "'<path class=\"chart-area\" d=\"'+dArea+'\" fill=\"'+col+'\"/>'+"
          "'<path class=\"chart-line\" d=\"'+dLine+'\" stroke=\"'+col+'\"/>'+"
          "'<text class=\"chart-lbl\" x=\"0\" y=\"'+(pad-4)+'\">'+max.toFixed(1)+unit+'</text>'+"
          "'<text class=\"chart-lbl\" x=\"0\" y=\"'+(h-pad-4)+'\">'+min.toFixed(1)+unit+'</text>'+"
          "'<text class=\"chart-lbl\" x=\"0\" y=\"'+(h-2)+'\">-24h</text>'+"
          "'<text class=\"chart-lbl\" x=\"'+(w/2-15)+'\" y=\"'+(h-2)+'\">-12h</text>'+"
          "'<text class=\"chart-lbl\" x=\"'+(w-35)+'\" y=\"'+(h-2)+'\">JETZT</text>'+"
          "'</svg>';"
          "el.innerHTML=svg;}"
          "function renderCMonth(id,data,kd,kn,cd,cn,unit,isAbs){"
          "var el=document.getElementById(id); if(!el)return;"
          "var w=el.clientWidth, h=el.clientHeight, pad=20, slots=29;"
          "var min=0, max=0, ran=1, dLine_d='', dLine_n='';"
          "if(data&&data.length>0){"
          "  var vd=data.map(e=>e[kd]), vn=data.map(e=>e[kn]);"
          "  min=Math.min(...vd,...vn); max=Math.max(...vd,...vn);"
          "  if(max==min){min-=1;max+=1;} ran=max-min;"
          "  if(isAbs){min=0;max=Math.max(max,20);ran=max-min;}"
          "  var pts_d=vd.map((v,i)=>({x:((slots-(data.length-1-i))/slots)*w, y:h-pad-((v-min)/ran)*(h-pad*2)}));"
          "  var dLine_d='<path class=\"chart-line\" d=\"M'+pts_d.map(p=>p.x+','+p.y).join('L')+'\" stroke=\"'+cd+'\" stroke-width=\"2\" fill=\"none\"/>';"
          "  dLine_d += pts_d.map(p=>'<circle cx=\"'+p.x+'\" cy=\"'+p.y+'\" r=\"2.5\" fill=\"'+cd+'\"/>').join('');"
          "  var pts_n=vn.map((v,i)=>({x:((slots-(data.length-1-i))/slots)*w, y:h-pad-((v-min)/ran)*(h-pad*2)}));"
          "  var dLine_n='<path class=\"chart-line\" d=\"M'+pts_n.map(p=>p.x+','+p.y).join('L')+'\" stroke=\"'+cn+'\" stroke-width=\"2\" fill=\"none\"/>';"
          "  dLine_n += pts_n.map(p=>'<circle cx=\"'+p.x+'\" cy=\"'+p.y+'\" r=\"2.5\" fill=\"'+cn+'\"/>').join('');"
          "}"
          "var rects='';"
          "if(isAbs){"
          "  var gy=v=>{var yy=h-pad-((v-min)/ran)*(h-pad*2);return yy<pad?pad:(yy>(h-pad)?(h-pad):yy);};"
          "  var r=(yT,yB,c)=>'<rect x=\"0\" y=\"'+yT+'\" width=\"'+w+'\" height=\"'+(yB-yT)+'\" fill=\"'+c+'\"/>';"
          "  rects=r(gy(25),gy(16),'rgba(239,68,68,0.15)')+r(gy(16),gy(13.5),'rgba(249,115,22,0.15)')+r(gy(13.5),gy(11),'rgba(250,204,21,0.15)')+r(gy(11),gy(7),'rgba(34,197,94,0.15)')+r(gy(7),gy(5),'rgba(250,204,21,0.15)')+r(gy(5),gy(0),'rgba(249,115,22,0.15)');"
          "}"
          "var svg='<svg viewBox=\"0 0 '+w+' '+h+'\">'+rects+"
          "'<line class=\"chart-grid\" x1=\"0\" y1=\"'+(h-pad)+'\" x2=\"'+w+'\" y2=\"'+(h-pad)+'\"/>'+"
          "'<line class=\"chart-grid\" x1=\"0\" y1=\"'+pad+'\" x2=\"'+w+'\" y2=\"'+pad+'\"/>'+"
          "'<line class=\"chart-grid\" x1=\"'+(w*0.5)+'\" y1=\"'+pad+'\" x2=\"'+(w*0.5)+'\" y2=\"'+(h-pad)+'\"/>'+"
          "dLine_d + dLine_n +"
          "'<text class=\"chart-lbl\" x=\"0\" y=\"'+(pad-4)+'\">'+(data&&data.length>0?max.toFixed(1)+unit:'-')+'</text>'+"
          "'<text class=\"chart-lbl\" x=\"0\" y=\"'+(h-pad-4)+'\">'+(data&&data.length>0?min.toFixed(1)+unit:'-')+'</text>'+"
          "'<text class=\"chart-lbl\" x=\"0\" y=\"'+(h-2)+'\">-30T</text>'+"
          "'<text class=\"chart-lbl\" x=\"'+(w-35)+'\" y=\"'+(h-2)+'\">JETZT</text>'+"
          "'</svg>';"
          "el.innerHTML=svg;}"
          "function renderCYear(id,data,kx,kn,cx,cn,unit,isAbs){"
          "var el=document.getElementById(id); if(!el)return;"
          "var w=el.clientWidth, h=el.clientHeight, pad=20, slots=364;"
          "var min=0, max=0, ran=1, dLine_x='', dLine_n='';"
          "if(data&&data.length>0){"
          "  var vx=data.map(e=>e[kx]), vn=data.map(e=>e[kn]);"
          "  min=Math.min(...vx,...vn); max=Math.max(...vx,...vn);"
          "  if(max==min){min-=1;max+=1;} ran=max-min;"
          "  if(isAbs){min=0;max=Math.max(max,20);ran=max-min;}"
          "  var pts_x=vx.map((v,i)=>({x:((slots-(data.length-1-i))/slots)*w, y:h-pad-((v-min)/ran)*(h-pad*2)}));"
          "  var pts_n=vn.map((v,i)=>({x:((slots-(data.length-1-i))/slots)*w, y:h-pad-((v-min)/ran)*(h-pad*2)}));"
          "  if(pts_x.length==1){ pts_x.push({x:pts_x[0].x+4,y:pts_x[0].y}); pts_n.push({x:pts_n[0].x+4,y:pts_n[0].y}); }"
          "  var dLine_x='<path class=\"chart-line\" d=\"M'+pts_x.map(p=>p.x+','+p.y).join('L')+'\" stroke=\"'+cx+'\" stroke-width=\"1.5\" fill=\"none\"/>';"
          "  var dLine_n='<path class=\"chart-line\" d=\"M'+pts_n.map(p=>p.x+','+p.y).join('L')+'\" stroke=\"'+cn+'\" stroke-width=\"1.5\" fill=\"none\"/>';"
          "}"
          "var rects='';"
          "if(isAbs){"
          "  var gy=v=>{var yy=h-pad-((v-min)/ran)*(h-pad*2);return yy<pad?pad:(yy>(h-pad)?(h-pad):yy);};"
          "  var r=(yT,yB,c)=>'<rect x=\"0\" y=\"'+yT+'\" width=\"'+w+'\" height=\"'+(yB-yT)+'\" fill=\"'+c+'\"/>';"
          "  rects=r(gy(25),gy(16),'rgba(239,68,68,0.15)')+r(gy(16),gy(13.5),'rgba(249,115,22,0.15)')+r(gy(13.5),gy(11),'rgba(250,204,21,0.15)')+r(gy(11),gy(7),'rgba(34,197,94,0.15)')+r(gy(7),gy(5),'rgba(250,204,21,0.15)')+r(gy(5),gy(0),'rgba(249,115,22,0.15)');"
          "}"
          "var svg='<svg viewBox=\"0 0 '+w+' '+h+'\">'+rects+"
          "'<line class=\"chart-grid\" x1=\"0\" y1=\"'+(h-pad)+'\" x2=\"'+w+'\" y2=\"'+(h-pad)+'\"/>'+"
          "'<line class=\"chart-grid\" x1=\"0\" y1=\"'+pad+'\" x2=\"'+w+'\" y2=\"'+pad+'\"/>'+"
          "'<line class=\"chart-grid\" x1=\"'+(w*0.5)+'\" y1=\"'+pad+'\" x2=\"'+(w*0.5)+'\" y2=\"'+(h-pad)+'\"/>'+"
          "dLine_x + dLine_n +"
          "'<text class=\"chart-lbl\" x=\"0\" y=\"'+(pad-4)+'\">'+(data&&data.length>0?max.toFixed(1)+unit:'-')+'</text>'+"
          "'<text class=\"chart-lbl\" x=\"0\" y=\"'+(h-pad-4)+'\">'+(data&&data.length>0?min.toFixed(1)+unit:'-')+'</text>'+"
          "'<text class=\"chart-lbl\" x=\"0\" y=\"'+(h-2)+'\">-365T</text>'+"
          "'<text class=\"chart-lbl\" x=\"'+(w-35)+'\" y=\"'+(h-2)+'\">JETZT</text>'+"
          "'</svg>';"
          "el.innerHTML=svg;}"
          "function updTheme(){"
          "var cb=document.getElementById('dark_mode');"
          "document.body.classList.toggle('theme-dark', !!(cb&&cb.checked));}"
          "window.onload=function(){"
          "var t=localStorage.getItem('tab')||'status';"
          "showTab(t);"
          "updTheme();"
          "updDhcp();"
          "updDst();"
          "updBottomMode();"
          "};"
          "function updDhcp(){"
          "var dh=document.getElementById('use_dhcp');"
          "if(!dh)return;"
          "var on=dh.checked;"
          "['static_ip','static_gw','static_mask','dns1','dns2'].forEach(function(id){"
          "var e=document.getElementById(id);if(!e)return;"
          "e.disabled=on;e.style.opacity=on?0.4:1;});}"
          "function updDst(){"
          "var sel=document.getElementById('dst_mode');"
          "if(!sel)return;"
          "var show=sel.value=='3';"
          "var sec=document.getElementById('dst_custom');"
          "if(sec)sec.style.display=show?'block':'none';}"
          "function updBottomMode(){"
          "var sel=document.querySelector('[name=bottom_mode]');"
          "if(!sel)return;"
          "var m=parseInt(sel.value);"
          "var s=document.getElementById('grp_bottom_switch');"
          "var c=document.getElementById('grp_bottom_scroll');"
          "var ef=document.getElementById('grp_bottom_env_font');"
          "if(s)s.style.display=(m==2)?'block':'none';"
          "if(c)c.style.display=(m>=1)?'block':'none';"
          "if(ef)ef.style.display=(m>=1)?'block':'none';}"
          "function rtcSetNow(){"
          "var d=document.getElementById('rtc_date');"
          "var t=document.getElementById('rtc_time');"
          "var msg=document.getElementById('rtc_msg');"
          "if(!d||!t)return;"
          "var body=new URLSearchParams();"
          "body.set('date',d.value);body.set('time',t.value);"
          "fetch('/rtcset',{method:'POST',headers:{'Content-Type':'application/x-www-form-urlencoded'},body:body})"
          ".then(function(r){return r.text().then(function(x){return {ok:r.ok,text:x};});})"
          ".then(function(r){if(!r.ok)throw new Error(r.text); if(msg)msg.textContent='RTC gesetzt'; pollStatus();})"
          ".catch(function(e){if(msg)msg.textContent='RTC-Fehler: '+e;});}"
          "function uploadFirmware(){"
          "var file=document.getElementById('fw_file');"
          "var msg=document.getElementById('fw_msg');"
          "if(!file||!file.files||!file.files.length){if(msg)msg.textContent='Bitte eine .bin-Datei auswaehlen.';return;}"
          "if(!confirm('Firmware wirklich hochladen und danach neu starten?'))return;"
          "var form=new FormData();"
          "form.append('firmware',file.files[0],file.files[0].name);"
          "if(msg)msg.textContent='Upload laeuft ...';"
          "fetch('/api/update',{method:'POST',body:form})"
          ".then(function(r){return r.json().then(function(j){return {ok:r.ok,json:j};});})"
          ".then(function(r){"
          "if(r.ok&&r.json&&r.json.ok){if(msg)msg.textContent='Firmware eingespielt. Neustart ...';setTimeout(function(){location.reload();},18000);return;}"
          "var err=(r.json&&r.json.error)?r.json.error:'unbekannter Fehler';"
          "if(msg)msg.textContent='Firmware-Update fehlgeschlagen: '+err;"
          "})"
          ".catch(function(e){if(msg)msg.textContent='Firmware-Upload fehlgeschlagen: '+e;});}"
          "var F8={"
          "'0':[0x3C,0x66,0x66,0x66,0x66,0x66,0x66,0x3C],"
          "'1':[0x18,0x38,0x18,0x18,0x18,0x18,0x18,0x7E],"
          "'2':[0x3C,0x66,0x06,0x0C,0x18,0x30,0x60,0x7E],"
          "'3':[0x3C,0x66,0x06,0x1C,0x06,0x06,0x66,0x3C],"
          "'4':[0x0C,0x1C,0x3C,0x6C,0x7E,0x0C,0x0C,0x0C],"
          "'5':[0x7E,0x60,0x60,0x7C,0x06,0x06,0x66,0x3C],"
          "'6':[0x1C,0x30,0x60,0x7C,0x66,0x66,0x66,0x3C],"
          "'7':[0x7E,0x06,0x0C,0x18,0x30,0x30,0x30,0x30],"
          "'8':[0x3C,0x66,0x66,0x3C,0x66,0x66,0x66,0x3C],"
          "'9':[0x3C,0x66,0x66,0x66,0x3E,0x06,0x0C,0x38],"
          "'\u003A':[0x00,0x18,0x18,0x00,0x00,0x18,0x18,0x00],"
          "' ':[0x00,0x00,0x00,0x00,0x00,0x00,0x00,0x00]};"
          "var F5={"
          "'0':[0x3E,0x51,0x49,0x45,0x3E],"
          "'1':[0x00,0x42,0x7F,0x40,0x00],"
          "'2':[0x42,0x61,0x51,0x49,0x46],"
          "'3':[0x21,0x41,0x45,0x4B,0x31],"
          "'4':[0x18,0x14,0x12,0x7F,0x10],"
          "'5':[0x27,0x45,0x45,0x45,0x39],"
          "'6':[0x3C,0x4A,0x49,0x49,0x30],"
          "'7':[0x01,0x71,0x09,0x05,0x03],"
          "'8':[0x36,0x49,0x49,0x49,0x36],"
          "'9':[0x06,0x49,0x49,0x29,0x1E],"
          "'\u002E':[0x00,0x00,0x60,0x60,0x00],"
          "' ':[0x00,0x00,0x00,0x00,0x00]};"
          "function dF8(cv,txt,dp,gp,cOn,cOff,gw){"
          "var st=dp+gp,R=8,C=8,cw=C*st,sw=st;"
          "cv.width=Math.ceil(txt.length*cw+Math.max(0,txt.length-1)*sw);"
          "cv.height=Math.ceil(R*st);"
          "var ctx=cv.getContext('2d');"
          "ctx.clearRect(0,0,cv.width,cv.height);"
          "for(var ci=0;ci<txt.length;ci++){"
          "var g=F8[txt[ci]]||F8[' '],ox=ci*(cw+sw);"
          "for(var row=0;row<R;row++){"
          "var rb=g[row];"
          "for(var col=0;col<C;col++){"
          "var on=(rb>>(7-col))&1;"
          "ctx.beginPath();"
          "ctx.arc(ox+col*st+dp/2,row*st+dp/2,dp/2,0,Math.PI*2);"
          "if(on){ctx.shadowColor=gw;ctx.shadowBlur=dp*3;ctx.fillStyle=cOn;}"
          "else{ctx.shadowBlur=0;ctx.fillStyle=cOff;}"
          "ctx.fill();}}}}"
          "function dF5(cv,txt,dp,gp,cOn,cOff,gw){"
          "var st=dp+gp,R=7,tc=0;"
          "for(var i=0;i<txt.length;i++){tc+=(F5[txt[i]]||F5[' ']).length;if(i<txt.length-1)tc++;}"
          "cv.width=Math.ceil(tc*st);cv.height=Math.ceil(R*st);"
          "var ctx=cv.getContext('2d'),cx=0;"
          "ctx.clearRect(0,0,cv.width,cv.height);"
          "for(var ci=0;ci<txt.length;ci++){"
          "var g=F5[txt[ci]]||F5[' '];"
          "for(var col=0;col<g.length;col++){"
          "var cb=g[col];"
          "for(var row=0;row<R;row++){"
          "var on=(cb>>row)&1;"
          "ctx.beginPath();"
          "ctx.arc((cx+col)*st+dp/2,row*st+dp/2,dp/2,0,Math.PI*2);"
          "if(on){ctx.shadowColor=gw;ctx.shadowBlur=dp*3;ctx.fillStyle=cOn;}"
          "else{ctx.shadowBlur=0;ctx.fillStyle=cOff;}"
          "ctx.fill();}"
          "}"
          "cx+=g.length+1;}"
          "}"
          "var espLocalSec=0,espFetchMs=0;"
          "function redrawClock(){"
          "if(!espFetchMs)return;"
          "var elapsed=Math.floor((Date.now()-espFetchMs)/1000);"
          "var s=(espLocalSec+elapsed)%86400;"
          "var hh=Math.floor(s/3600),mm=Math.floor((s%3600)/60),ss=s%60;"
          "var p=function(n){return String(n).padStart(2,'0');};"
          "var tstr=p(hh)+'\u003A'+p(mm)+'\u003A'+p(ss);"
          "var c1=document.getElementById('dm_time');"
          "if(c1)dF8(c1,tstr,5,1.5,'#FFA030','#1c1005','#FF8000');"
          "}"
          "function pollStatus(){"
          "fetch('/api/status')"
          ".then(function(r){return r.json();})"
          ".then(function(d){"
          "var u=document.getElementById('hdr_uptime');"
          "if(u)u.textContent=d.uptime;"
          "var ns=document.getElementById('next_sync');"
          "if(ns&&d.nextsync!==undefined)ns.textContent=d.nextsync+'s';"
          "var lux=document.getElementById('v-lux');"
          "if(lux)lux.textContent=d.lux>=0?d.lux.toFixed(1)+' lx':'-';"
          "var lux2=document.getElementById('v-env-lux');"
          "if(lux2)lux2.textContent=d.lux>=0?d.lux.toFixed(1)+' lx':'-';"
          "var bl=document.getElementById('v-bl');"
          "if(bl)bl.textContent=d.brightness+' / 15';"
          "var fw=document.getElementById('v-fw');"
          "if(fw&&d.fw_version)fw.textContent=d.fw_version;"
          "var sa=document.getElementById('v-auto');"
          "if(sa)sa.textContent=d.auto_brightness?'aktiv':'aus';"
          "var ss=document.getElementById('v-sensor');"
          "if(ss)ss.textContent=d.sensor_msg|| (d.sensor_ok?'OK':'nicht gefunden');"
          "var ss2=document.getElementById('v-env-sensor');"
          "if(ss2)ss2.textContent=d.sensor_msg|| (d.sensor_ok?'OK':'nicht gefunden');"
          "var ts=document.getElementById('v-source');"
          "if(ts)ts.textContent=d.time_source||'keine';"
          "var tsd=document.getElementById('v-source-detail');"
          "if(tsd)tsd.textContent=d.time_source_detail||'';"
          "var rts=document.getElementById('v-rtc-source');"
          "if(rts)rts.textContent=d.time_source||'keine';"
          "var rtd=document.getElementById('v-rtc-source-detail');"
          "if(rtd)rtd.textContent=d.time_source_detail||'';"
          "var rp=document.getElementById('v-rtc-present');"
          "if(rp)rp.textContent=d.rtc_present?'ja':'nein';"
          "var rv=document.getElementById('v-rtc-valid');"
          "if(rv)rv.textContent=d.rtc_ok?'ja':'nein';"
          "var ri1=document.getElementById('v-i2c-1');"
          "if(ri1)ri1.textContent=d.i2c_diag||'-';"
          "var ri2=document.getElementById('v-i2c-2');"
          "if(ri2)ri2.textContent=d.i2c_diag||'-';"
          "var ei=document.getElementById('v-i2c-env');"
          "if(ei)ei.textContent=d.i2c_env_diag||'-';"
          "var eb=document.getElementById('v-bme');"
          "if(eb)eb.textContent=d.bme_ok?'ja':'nein';"
          "var eiq=document.getElementById('v-bme-iaq');"
          "if(eiq)eiq.textContent=d.bme_iaq>=0?d.bme_iaq:'-';"
          "var eiqt=document.getElementById('v-bme-iaq-text');"
          "if(eiqt){"
          "  eiqt.textContent=d.bme_iaq_text||'-';"
          "  if(d.bme_iaq<0)eiqt.style.color=''; else if(d.bme_iaq<=50)eiqt.style.color='#16a34a'; else if(d.bme_iaq<=100)eiqt.style.color='#84cc16'; else if(d.bme_iaq<=150)eiqt.style.color='#eab308'; else if(d.bme_iaq<=200)eiqt.style.color='#f97316'; else eiqt.style.color='#dc2626';"
          "}"
          "var et=document.getElementById('v-bme-temp');"
          "if(et)et.textContent=d.bme_temp>-100?d.bme_temp.toFixed(1)+' \u00B0C':'-';"
          "var eh=document.getElementById('v-bme-humi');"
          "if(eh)eh.textContent=d.bme_humi>=0?d.bme_humi.toFixed(1)+' %':'-';"
          "var eht=document.getElementById('v-bme-humi-text');"
          "if(eht){eht.textContent=d.bme_humi_text||''; eht.style.color=d.bme_humi_color||'';}"
          "var ep=document.getElementById('v-bme-pres');"
          "if(ep)ep.textContent=d.bme_pres>=0?d.bme_pres.toFixed(1)+' hPa':'-';"
          "var ept=document.getElementById('v-bme-pres-trend');"
          "if(ept)ept.innerHTML=d.bme_pres_trend||'';"
          "var efor=document.getElementById('v-bme-forecast');"
          "if(efor)efor.textContent=d.bme_forecast||'-';"
          "var edew=document.getElementById('v-bme-dew');"
          "if(edew)edew.textContent=d.bme_dew>-100?d.bme_dew.toFixed(1)+' \u00B0C':'-';"
          "var eheat=document.getElementById('v-bme-heat');"
          "if(eheat)eheat.textContent=d.bme_heat>-100?d.bme_heat.toFixed(1)+' \u00B0C':'-';"
          "var eabsh=document.getElementById('v-bme-abshumi');"
          "if(eabsh)eabsh.textContent=d.bme_abs_humi>=0?d.bme_abs_humi.toFixed(1)+' g/m\u00B3':'-';"
          "var eat=document.getElementById('v-bme-abshumi-text');"
          "if(eat){eat.textContent=d.bme_abs_humi_text||''; eat.style.color=d.bme_abs_humi_color||'';}"
          "var eg=document.getElementById('v-bme-gas');"
          "if(eg)eg.textContent=d.bme_gas>=0?d.bme_gas.toFixed(1)+' kOhm':'-';"
          "var egb=document.getElementById('v-bme-baseline');"
          "if(egb)egb.textContent=d.bme_baseline>0?d.bme_baseline.toFixed(1)+' kOhm':'-';"
          "var els=document.getElementById('v-bme-save');"
          "if(els)els.textContent=d.bme_last_save||'-';"
          "var ebd=document.getElementById('v-bme-diag');"
          "if(ebd)ebd.textContent=d.bme_diag||'-';"
          "var rd=document.getElementById('v-rtc-date');"
          "if(rd)rd.textContent=d.rtc_date||'-';"
          "var rt=document.getElementById('v-rtc-time');"
          "if(rt)rt.textContent=d.rtc_time||'-';"
          "var rl=document.getElementById('v-rtc-last-sync');"
          "if(rl)rl.textContent=d.last_ntp_sync||'-';"
          "var rdi=document.getElementById('rtc_date');"
          "if(rdi&&(!rdi.value||rdi.value===''))rdi.value=d.rtc_date_iso||'';"
          "var rti=document.getElementById('rtc_time');"
          "if(rti&&(!rti.value||rti.value===''))rti.value=d.rtc_time_iso||'';"
          "espLocalSec=d.localsec||0;espFetchMs=Date.now();"
          "var c2=document.getElementById('dm_date');"
          "if(c2)dF5(c2,d.date,3.2,1.1,'#CC6A00','#130d03','#AA5000');"
          "redrawClock();"
          "})"
          ".catch(function(){});"
          "}"
          "setInterval(redrawClock,1000);"
          "setInterval(pollStatus,5000);"
          "pollStatus();"
          "</script>"
          ));
  chunk(String(F("</head><body")) + (cfg.dark_mode ? F(" class='theme-dark'") : F("")) + F(">"));

  // ---- HEADER ----
  chunk(F("<div class='hdr'>"
          "<svg width='28' height='28' viewBox='0 0 24 24' fill='none' stroke='#fff' stroke-width='2'>"
          "<circle cx='12' cy='12' r='10'/><polyline points='12 6 12 12 16 14'/></svg>"
          "<h1>Dottie - The Matrix Clock 'Extended Version'</h1>"));
  chunk(String(F("<span class='badge'>")) + FPSTR(FW_VERSION) + F("</span>"));
  chunk(F("<span class='badge'>Uptime: <span id='hdr_uptime'>...</span></span>"));
  chunk(F("<div class='dm-panel'>"
          "<div class='dm-lbl'>NTP &middot; CLOCK</div>"
          "<canvas id='dm_time'></canvas>"
          "<div class='dm-div'></div>"
          "<canvas id='dm_date'></canvas>"
          "</div>"));
  chunk(F("</div><div class='wrap'>"));

  // ---- TABS ----
  chunk(F("<div class='tabs'>"));
  chunk(F("<div class='tab' id='t_status'  onclick='showTab(\"status\")'>📊 Status</div>"));
  chunk(F("<div class='tab' id='t_wifi'    onclick='showTab(\"wifi\")'>📶 WiFi</div>"));
  chunk(F("<div class='tab' id='t_ntp'     onclick='showTab(\"ntp\")'>🕐 NTP</div>"));
  chunk(F("<div class='tab' id='t_rtc'     onclick='showTab(\"rtc\")'>🧭 RTC</div>"));
  chunk(F("<div class='tab' id='t_env'     onclick='showTab(\"env\")'>🌡️ Umweltdaten</div>"));
  chunk(F("<div class='tab' id='t_env365'  onclick='showTab(\"env365\")'>📅 Umwelt (Jahr)</div>"));
  chunk(F("<div class='tab' id='t_tz'      onclick='showTab(\"tz\")'>🌍 Zeitzone</div>"));
  chunk(F("<div class='tab' id='t_display' onclick='showTab(\"display\")'>💡 Display</div>"));
  chunk(F("<div class='tab' id='t_system'  onclick='showTab(\"system\")'>⚙️ System</div>"));
  chunk(F("</div>"));

  chunk(F("<form method='POST' action='/save'>"));

  // ============================================================
  // TAB: STATUS
  // ============================================================
  chunk(F("<div class='panel' id='p_status'>"));
  chunk(F("<h3>Gerätestatus</h3>"));

  // WiFi
  if (inAP) {
    chunk(String(F("<div class='stat'>📡 <b>Modus:</b> Access Point &nbsp; <b>AP-IP:</b> ")) +
          WiFi.softAPIP().toString() + F("</div>"));
  } else {
    bool wifiOk = (WiFi.status() == WL_CONNECTED);
    chunk(String(F("<div class='stat'>📶 <b>SSID:</b> ")) + htmlEscape(cfg.sta_ssid)
        + F(" &nbsp; <b>IP:</b> ") + WiFi.localIP().toString()
        + F(" &nbsp; <b>RSSI:</b> ") + WiFi.RSSI() + F(" dBm"
        " &nbsp; <b>Status:</b> <span class='") + (wifiOk ? F("ok'>✓ Verbunden") : F("fail'>✗ Getrennt")) + F("</span>"
        "</div>"));
    chunk(String(F("<div class='stat'>&#x1F310; <b>DNS:</b> ")) + ipOrLabel(WiFi.dnsIP(0))
        + F(" / ") + ipOrLabel(WiFi.dnsIP(1))
        + F(" &nbsp; <b>Aktiver NTP:</b> ") + htmlEscape(activeNtp.length() ? activeNtp : "(keiner)")
        + F(" &nbsp; <b>N&auml;chster Sync:</b> <span id='next_sync'>-</span>"
        "</div>"));
  }

  // Letzte Sync-Zeit
  if (lastSyncEpoch > 0) {
    char buf[32]; struct tm tm_s;
    localtime_r(&lastSyncEpoch, &tm_s);
    strftime(buf, sizeof(buf), "%d.%m.%Y %H:%M:%S", &tm_s);
    chunk(String(F("<div class='stat'>🕐 <b>Letzter NTP-Sync:</b> ")) + buf + F("</div>"));
  }
  chunk(String(F("<div class='stat'>⏱ <b>Zeitquelle:</b> <span id='v-source'>")) +
        htmlEscape(timeSource) +
        F("</span>") +
        (timeSourceDetail.length() ? String(F(" &nbsp; <b>Info:</b> ")) + htmlEscape(timeSourceDetail) : String("")) +
        F("</div>"));

  chunk(F("</div>")); // panel status

  // ============================================================
  // TAB: WIFI
  // ============================================================
  chunk(F("<div class='panel' id='p_wifi'>"));
  chunk(F("<h3>Netzwerkeinstellungen</h3>"));
  chunk(F("<div class='row3'>"));
  chunk(String(F("<div><label>Hostname</label><input name='hostname' value='")) + htmlEscape(cfg.hostname) + F("'></div>"));
  chunk(String(F("<div><label>WLAN SSID</label><input name='sta_ssid' value='")) + htmlEscape(cfg.sta_ssid) + F("'></div>"));
  chunk(String(F("<div><label>WLAN Passwort</label><input name='sta_pass' type='password' value='")) + htmlEscape(cfg.sta_pass) + F("'></div>"));
  chunk(F("</div>"));
  chunk(F("<div class='row2'>"));
  chunk(String(F("<div><label>Verbindungs-Timeout (Sek.)</label>"
                 "<input name='wifi_timeout_sec' type='number' min='5' max='600' value='")) + cfg.wifi_timeout_sec + F("'></div>"));
  chunk(String(F("<div><label>IP anzeigen nach Verbindung (Sek., 0=aus)</label>"
                 "<input name='ip_show_sec' type='number' min='0' max='60' value='")) + cfg.ip_show_sec + F("'></div>"));
  chunk(F("</div>"));

  chunk(F("<h3>IP-Konfiguration</h3>"));
  chunk(String(F("<div class='chk'><input id='use_dhcp' type='checkbox' name='use_dhcp' value='1'")) +
        checked(cfg.use_dhcp) + F(" onchange='updDhcp()'><label style='margin:0'>DHCP verwenden</label></div>"));
  chunk(F("<div class='row3'>"));
  chunk(String(F("<div><label>Statische IP</label><input id='static_ip' name='static_ip' value='")) + htmlEscape(cfg.static_ip) + F("'></div>"));
  chunk(String(F("<div><label>Gateway</label><input id='static_gw' name='static_gw' value='")) + htmlEscape(cfg.static_gw) + F("'></div>"));
  chunk(String(F("<div><label>Subnetzmaske</label><input id='static_mask' name='static_mask' value='")) + htmlEscape(cfg.static_mask) + F("'></div>"));
  chunk(F("</div>"));
  chunk(F("<h3>DNS-Überschreibung (nur bei statischer IP)</h3>"));
  chunk(F("<div class='row2'>"));
  chunk(String(F("<div><label>DNS 1</label><input id='dns1' name='dns1' placeholder='leer = DHCP-DNS' value='")) + htmlEscape(cfg.dns1) + F("'></div>"));
  chunk(String(F("<div><label>DNS 2</label><input id='dns2' name='dns2' placeholder='leer = DHCP-DNS' value='")) + htmlEscape(cfg.dns2) + F("'></div>"));
  chunk(F("</div>"));
  chunk(F("<p class='hint'>Bei DHCP wird DNS-Überschreibung nicht angewendet.</p>"));
  chunk(F("</div>")); // panel wifi

  // ============================================================
  // TAB: NTP
  // ============================================================
  chunk(F("<div class='panel' id='p_ntp'>"));
  chunk(F("<h3>NTP-Server</h3>"));
  chunk(String(F("<label>NTP #1</label><input name='ntp1' value='")) + htmlEscape(cfg.ntp1) + F("'>"));
  chunk(String(F("<label>NTP #2</label><input name='ntp2' value='")) + htmlEscape(cfg.ntp2) + F("'>"));
  chunk(String(F("<label>NTP #3</label><input name='ntp3' value='")) + htmlEscape(cfg.ntp3) + F("'>"));
  chunk(String(F("<label>Synchronisationsintervall (Minuten, 0=15)</label>"
                 "<input name='ntp_interval_min' type='number' min='0' max='1440' value='")) + cfg.ntp_interval_min + F("'>"));

  chunk(F("</div>")); // panel ntp

  // ============================================================
  // TAB: RTC
  // ============================================================
  chunk(F("<div class='panel' id='p_rtc'>"));
  chunk(F("<h3>DS3231 / RTC</h3>"));
  chunk(F("<div class='row2'>"));
  chunk(F("<div class='stat'>"
          "<b>RTC vorhanden:</b> <span id='v-rtc-present'>-</span><br>"
          "<b>RTC gültig:</b> <span id='v-rtc-valid'>-</span><br>"
          "<b>I2C:</b> <span id='v-i2c-1'>-</span><br>"
          "<b>Zeitquelle:</b> <span id='v-rtc-source'>-</span><br>"
          "<b>Info:</b> <span id='v-rtc-source-detail'>-</span>"
          "</div>"));
  chunk(F("<div class='stat'>"
          "<b>RTC-Datum:</b> <span id='v-rtc-date'>-</span><br>"
          "<b>RTC-Zeit:</b> <span id='v-rtc-time'>-</span><br>"
          "<b>Letzter NTP-Sync:</b> <span id='v-rtc-last-sync'>-</span>"
          "</div>"));
  chunk(F("</div>"));
  chunk(F("<h3>Manuell setzen</h3>"));
  chunk(F("<div class='row2'>"));
  chunk(F("<div><label>Datum</label><input id='rtc_date' type='date'></div>"));
  chunk(F("<div><label>Uhrzeit</label><input id='rtc_time' type='time' step='1'></div>"));
  chunk(F("</div>"));
  chunk(F("<p class='hint'>Eingabe in lokaler Zeit. Die Uhr wird direkt in die DS3231 geschrieben.</p>"));
  chunk(F("<div class='row3'>"));
  chunk(F("<div><button type='button' onclick='rtcSetNow()'>📝 RTC setzen</button></div>"));
  chunk(F("<div></div><div></div>"));
  chunk(F("</div>"));
  chunk(F("<div id='rtc_msg' class='hint' style='margin-top:8px'></div>"));
  chunk(F("</div>")); // panel rtc

  // ============================================================
  // TAB: UMWELTDATEN
  // ============================================================
  chunk(F("<div class='panel' id='p_env'>"));
  chunk(F("<h3>Umweltsensoren</h3>"));
  chunk(F("<div id='w_table_div'></div>"));
  chunk(F("<div class='row2'>"));
  chunk(F("<div class='stat'>"
          "<b>BME680 vorhanden:</b> <span id='v-bme'>-</span><br>"
          "<b>Luftqualität (IAQ):</b> <span id='v-bme-iaq'>-</span> &nbsp; <b id='v-bme-iaq-text'>-</b><br>"
          "<b>Temperatur:</b> <span id='v-bme-temp'>-</span><br>"
          "<b>Feuchtigkeit:</b> <span id='v-bme-humi'>-</span> &nbsp; <b id='v-bme-humi-text'></b><br>"
          "<b>Luftdruck (NN):</b> <span id='v-bme-pres'>-</span> &nbsp; <b id='v-bme-pres-trend'></b><br>"
          "<b>Wetter-Tendenz:</b> <span id='v-bme-forecast'>-</span><br>"
          "<b>Taupunkt:</b> <span id='v-bme-dew'>-</span><br>"
          "<b>Gefühlt:</b> <span id='v-bme-heat'>-</span><br>"
          "<b>Absolute Feuchte:</b> <span id='v-bme-abshumi'>-</span> &nbsp; <b id='v-bme-abshumi-text'></b><br>"
          "<b>Gaswiderstand:</b> <span id='v-bme-gas'>-</span><br>"
          "<b>Referenz saubere Luft:</b> <span id='v-bme-baseline'>-</span><br>"
          "<b>Zuletzt gespeichert:</b> <span id='v-bme-save'>-</span><br>"
          "<b>Diagnose:</b> <span id='v-bme-diag'>-</span>"
          "</div>"));
  chunk(F("<div class='stat'>"
          "<b>VEML7700:</b> <span id='v-env-sensor'>-</span><br>"
          "<b>Helligkeit:</b> <span id='v-env-lux'>-</span>"
          "</div>"));
  chunk(F("</div>"));
  chunk(F("<h3>I2C-Scan</h3>"));
  chunk(F("<div class='stat'><b>RTC/Licht:</b> <span id='v-i2c-2'>-</span></div>"));
  chunk(F("<div class='stat'><b>Umwelt:</b> <span id='v-i2c-env'>-</span></div>"));

  chunk(F("<h3>24h Historie</h3>"));
  chunk(F("<div class='row2'>"));
  chunk(F("<div class='chart-wrap'><label>Temperatur (\u00B0C)</label><div id='c_temp' class='chart'></div></div>"));
  chunk(F("<div class='chart-wrap'><label>Luftfeuchtigkeit (%)</label><div id='c_humi' class='chart'></div></div>"));
  chunk(F("</div><div class='row2'>"));
  chunk(F("<div class='chart-wrap'><label>Luftdruck (hPa)</label><div id='c_pres' class='chart'></div></div>"));
  chunk(F("<div class='chart-wrap'><label>Luftqualität (IAQ)</label><div id='c_iaq' class='chart'></div></div>"));
  chunk(F("</div><div class='row2'>"));
  chunk(F("<div class='chart-wrap'><label>Taupunkt (\u00B0C)</label><div id='c_dew' class='chart'></div></div>"));
  chunk(F("<div class='chart-wrap'><label>Gefühlte Temp (\u00B0C)</label><div id='c_heat' class='chart'></div></div>"));
  chunk(F("</div><div class='row2'>"));
  chunk(F("<div class='chart-wrap' style='grid-column: 1 / -1'><label>Absolute Feuchte (g/m\u00B3)</label><div id='c_abs' class='chart'></div></div>"));
  chunk(F("</div><div class='hint' style='margin-top:2px;line-height:1.6'><b>Kategorien Absolute Feuchte:</b> "
          "<span style='color:#ef4444'>&#9608;</span> &gt;16 (Sehr hoch) &nbsp; "
          "<span style='color:#f97316'>&#9608;</span> 13.5-16 (Hoch) &nbsp; "
          "<span style='color:#facc15'>&#9608;</span> 11-13.5 (Erhöht) &nbsp; "
          "<span style='color:#22c55e'>&#9608;</span> 7-11 (Optimal) &nbsp; "
          "<span style='color:#facc15'>&#9608;</span> 5-7 (Trocken) &nbsp; "
          "<span style='color:#f97316'>&#9608;</span> &lt;5 (Sehr trocken)"
          "</div>"));

  chunk(F("<h3>30-Tage Trend (Tag/Nacht)</h3>"));
  chunk(F("<div class='row2'>"));
  chunk(F("<div class='chart-wrap'><label>Temperatur (\u00B0C)</label><div id='cm_temp' class='chart'></div></div>"));
  chunk(F("<div class='chart-wrap'><label>Luftfeuchtigkeit (%)</label><div id='cm_humi' class='chart'></div></div>"));
  chunk(F("</div><div class='row2'>"));
  chunk(F("<div class='chart-wrap'><label>Luftdruck (hPa)</label><div id='cm_pres' class='chart'></div></div>"));
  chunk(F("<div class='chart-wrap'><label>Luftqualität (IAQ)</label><div id='cm_iaq' class='chart'></div></div>"));
  chunk(F("</div><div class='row2'>"));
  chunk(F("<div class='chart-wrap'><label>Taupunkt (\u00B0C)</label><div id='cm_dew' class='chart'></div></div>"));
  chunk(F("<div class='chart-wrap'><label>Gefühlte Temp (\u00B0C)</label><div id='cm_heat' class='chart'></div></div>"));
  chunk(F("</div><div class='row2'>"));
  chunk(F("<div class='chart-wrap' style='grid-column: 1 / -1'><label>Absolute Feuchte (g/m\u00B3)</label><div id='cm_abs' class='chart'></div></div>"));
  chunk(F("</div><div class='hint' style='margin-top:2px;line-height:1.6'><b>Kategorien Absolute Feuchte:</b> "
          "<span style='color:#ef4444'>&#9608;</span> &gt;16 (Sehr hoch) &nbsp; "
          "<span style='color:#f97316'>&#9608;</span> 13.5-16 (Hoch) &nbsp; "
          "<span style='color:#facc15'>&#9608;</span> 11-13.5 (Erhöht) &nbsp; "
          "<span style='color:#22c55e'>&#9608;</span> 7-11 (Optimal) &nbsp; "
          "<span style='color:#facc15'>&#9608;</span> 5-7 (Trocken) &nbsp; "
          "<span style='color:#f97316'>&#9608;</span> &lt;5 (Sehr trocken)"
          "</div>"));

  chunk(F("</div>")); // panel env

  // ============================================================
  // TAB: UMWELTDATEN (JAHR)
  // ============================================================
  chunk(F("<div class='panel' id='p_env365'>"));
  chunk(F("<h3>365-Tage Trend (Max/Min)</h3>"));
  chunk(F("<div class='row2'>"));
  chunk(F("<div class='chart-wrap'><label>Temperatur (\u00B0C)</label><div id='cy_temp' class='chart'></div></div>"));
  chunk(F("<div class='chart-wrap'><label>Luftfeuchtigkeit (%)</label><div id='cy_humi' class='chart'></div></div>"));
  chunk(F("</div><div class='row2'>"));
  chunk(F("<div class='chart-wrap'><label>Luftdruck (hPa)</label><div id='cy_pres' class='chart'></div></div>"));
  chunk(F("<div class='chart-wrap'><label>Luftqualität (IAQ)</label><div id='cy_iaq' class='chart'></div></div>"));
  chunk(F("</div><div class='row2'>"));
  chunk(F("<div class='chart-wrap'><label>Taupunkt (\u00B0C)</label><div id='cy_dew' class='chart'></div></div>"));
  chunk(F("<div class='chart-wrap'><label>Gefühlte Temp (\u00B0C)</label><div id='cy_heat' class='chart'></div></div>"));
  chunk(F("</div><div class='row2'>"));
  chunk(F("<div class='chart-wrap' style='grid-column: 1 / -1'><label>Absolute Feuchte (g/m\u00B3)</label><div id='cy_abs' class='chart'></div></div>"));
  chunk(F("</div><div class='hint' style='margin-top:2px;line-height:1.6'><b>Kategorien Absolute Feuchte:</b> "
          "<span style='color:#ef4444'>&#9608;</span> &gt;16 (Sehr hoch) &nbsp; "
          "<span style='color:#f97316'>&#9608;</span> 13.5-16 (Hoch) &nbsp; "
          "<span style='color:#facc15'>&#9608;</span> 11-13.5 (Erhöht) &nbsp; "
          "<span style='color:#22c55e'>&#9608;</span> 7-11 (Optimal) &nbsp; "
          "<span style='color:#facc15'>&#9608;</span> 5-7 (Trocken) &nbsp; "
          "<span style='color:#f97316'>&#9608;</span> &lt;5 (Sehr trocken)"
          "</div>"));
  chunk(F("</div>")); // panel env365

  // ============================================================
  // TAB: ZEITZONE
  // ============================================================
  chunk(F("<div class='panel' id='p_tz'>"));
  chunk(F("<h3>Zeitzone</h3>"));
  chunk(F("<div class='row2'>"));
  chunk(F("<div><label>UTC-Offset</label><select name='utc_offset_min'>"));
  for (int h = -12; h <= 14; h++) {
    int mins = h * 60;
    chunk(String(F("<option value='")) + mins + F("'") + selected(cfg.utc_offset_min == mins) +
          F(">UTC") + (h >= 0 ? "+" : "") + h + F("</option>"));
  }
  chunk(F("</select></div>"));
  chunk(F("<div><label>Sommer­zeitregel</label><select name='dst_mode' id='dst_mode' onchange='updDst()'>"));
  for (uint8_t m = 0; m <= 3; m++) {
    chunk(String(F("<option value='")) + m + F("'") + selected(cfg.dst_mode == m) +
          F(">") + dstModeLabel(m) + F("</option>"));
  }
  chunk(F("</select></div></div>"));
  chunk(F("<div class='row2'>"));
  chunk(String(F("<div><label>Sommerzeit fügt hinzu (Minuten)</label>"
                 "<input name='dst_add_min' type='number' min='0' max='180' value='")) + cfg.dst_add_min + F("'></div>"));
  chunk(F("<div></div></div>"));

  // Custom DST
  chunk(F("<div id='dst_custom'>"));
  chunk(F("<h3>Benutzerdefinierte Sommerzeit (M.w.d/h)</h3>"));
  chunk(F("<p class='hint'>w=1..4 (n-ter), w=5 (letzter) &nbsp; d=0 Sonntag … d=6 Samstag</p>"));
  chunk(F("<div class='row2'>"));
  chunk(String(F("<div><label>Beginn (z.B. 3.5.0/2)</label>"
                 "<input name='dst_start' value='")) +
        cfg.dst_sm + '.' + cfg.dst_sw + '.' + cfg.dst_sd + '/' + cfg.dst_sh + F("'></div>"));
  chunk(String(F("<div><label>Ende (z.B. 10.5.0/3)</label>"
                 "<input name='dst_end' value='")) +
        cfg.dst_em + '.' + cfg.dst_ew + '.' + cfg.dst_ed + '/' + cfg.dst_eh + F("'></div>"));
  chunk(F("</div></div>"));
  chunk(F("</div>")); // panel tz

  // ============================================================
  // TAB: DISPLAY
  // ============================================================
  chunk(F("<div class='panel' id='p_display'>"));
  chunk(F("<h3>Zeitformat</h3>"));
  chunk(String(F("<div class='chk'><input type='checkbox' name='show_24h' value='1'")) +
        checked(cfg.show_24h) +
        F("><label>24-Stunden-Anzeige</label></div>"));
  chunk(String(F("<div class='chk'><input type='checkbox' name='show_seconds' value='1'")) +
        checked(cfg.show_seconds) +
        F("><label>Sekunden anzeigen (nur im 24h-Modus)</label></div>"));
  chunk(F("<p class='hint'>Im 12h-Modus wird statt der Sekunden AM/PM angezeigt.</p>"));
  chunk(F("<h3>Datumsformat</h3>"));
  chunk(String(F("<select name='date_fmt'>")) +
        String(F("<option value='0'")) + selected(cfg.date_fmt==0) + F(">DD.MM.YYYY (07.03.2026)</option>") +
        String(F("<option value='1'")) + selected(cfg.date_fmt==1) + F(">MM/DD/YYYY (03/07/2026)</option>") +
        String(F("<option value='2'")) + selected(cfg.date_fmt==2) + F(">YYYY-MM-DD (2026-03-07)</option>") +
        String(F("<option value='3'")) + selected(cfg.date_fmt==3) + F(">DD.MM.YY (07.03.26)</option>") +
        String(F("<option value='4'")) + selected(cfg.date_fmt==4) + F(">MM/DD/YY (03/07/26)</option>") +
        F("</select>"));
  chunk(F("<h3>Lichtstatus</h3>"));
  chunk(String(F("<div class='stat'><b>Lux:</b> <span id='v-lux'>")) + lux_s +
        F("</span> &nbsp; <b>Sensor:</b> <span id='v-sensor'>") + sensor_s +
        F("</span> &nbsp; <b>Auto:</b> <span id='v-auto'>") + auto_s +
        F("</span> &nbsp; <b>Helligkeit:</b> <span id='v-bl'>") + bl_s +
        F("</span></div>"));
  chunk(F("<h3>Helligkeit</h3>"));
  chunk(String(F("<label>Helligkeit (0 = dunkel … 15 = maximum)</label>"
                 "<input name='brightness' type='range' min='0' max='15' value='")) +
        cfg.brightness + F("' oninput='this.nextElementSibling.value=this.value'>"
                           "<output>") + cfg.brightness + F("</output>"));
  chunk(F("<p class='hint'>Wird sofort nach dem Speichern übernommen.</p>"));
  chunk(F("<h3>Lichtsensor</h3>"));
  chunk(String(F("<div class='chk'><input type='checkbox' name='auto_brightness' value='1'")) +
        checked(cfg.auto_brightness) +
        F("><label>Helligkeit automatisch mit VEML7700 regeln</label></div>"));
  chunk(F("<p class='hint'>Wenn aktiv, folgt die Display-Helligkeit dem Umgebungslicht. Der manuelle Wert bleibt als Fallback erhalten.</p>"));
  chunk(F("<h3>Anzeigeeffekt</h3>"));
  chunk(String(F("<div class='chk'><input type='checkbox' name='scroll_enabled' value='1'")) +
        checked(cfg.scroll_enabled) +
        F("><label>Scroll-Effekt beim Ziffernwechsel</label></div>"));
  chunk(F("<p class='hint'>Ziffern der Uhrzeit scrollen von unten nach oben wenn sie sich &auml;ndern.</p>"));
  chunk(F("<h3>Wochentagsanzeige</h3>"));
  chunk(F("<label>Schriftart Wochentag</label>"));
  {
    String sel = F("<select name='bottom_font'>");
    for (uint8_t i = 0; i < 7; i++) {
      sel += String(F("<option value='")) + i + F("'") + selected(cfg.bottom_font == i) + F(">") + BOTTOM_FONT_LABELS[i] + F("</option>");
    }
    sel += F("</select>");
    chunk(sel);
  }
  chunk(F("<div id='grp_bottom_env_font'><label>Schriftart Umweltdaten</label>"));
  {
    String sel = F("<select name='bottom_env_font'>");
    for (uint8_t i = 0; i < 7; i++) {
      sel += String(F("<option value='")) + i + F("'") + selected(cfg.bottom_env_font == i) + F(">") + BOTTOM_FONT_LABELS[i] + F("</option>");
    }
    sel += F("</select></div>");
    chunk(sel);
  }
  chunk(String(F("<div class='chk'><input type='checkbox' name='weekday_mixed_case' value='1'")) +
        checked(cfg.weekday_mixed_case) +
        F("><label>Gro&szlig;-/Kleinschreibung (z.&nbsp;B. Mittwoch statt MITTWOCH)</label></div>"));
  
  chunk(F("<h3>Anzeigemodus 3. Zeile</h3>"));
  chunk(F("<div class='row2'>"));
  chunk(F("<div><label>Modus</label><select name='bottom_mode' onchange='updBottomMode()'>"));
  chunk(String(F("<option value='0'")) + selected(cfg.bottom_mode == 0) + F(">Nur Wochentag</option>"));
  chunk(String(F("<option value='1'")) + selected(cfg.bottom_mode == 1) + F(">Nur Umweltdaten</option>"));
  chunk(String(F("<option value='2'")) + selected(cfg.bottom_mode == 2) + F(">Wechselnd</option>"));
  chunk(F("</select></div>"));
  chunk(String(F("<div id='grp_bottom_switch'><label>Wechsel-Intervall (Sek.)</label><input name='bottom_switch_sec' type='number' min='2' max='600' value='")) + cfg.bottom_switch_sec + F("'></div>"));
  chunk(F("</div>"));
  chunk(String(F("<div id='grp_bottom_scroll'><label>Scroll-Geschwindigkeit (ms pro Pixel, 10=schnell, 100=langsam)</label>"
                 "<input name='bottom_scroll_speed' type='number' min='5' max='250' value='")) + cfg.bottom_scroll_speed + F("'></div>"));

  chunk(F("</div>")); // panel display

  // ============================================================
  // TAB: SYSTEM
  // ============================================================
  chunk(F("<div class='panel' id='p_system'>"));
  chunk(F("<h3>OTA-Update</h3>"));
  chunk(String(F("<div class='chk'><input type='checkbox' name='ota_enabled' value='1'")) +
        checked(cfg.ota_enabled) + F("><label style='margin:0'>OTA aktiviert</label></div>"));
  chunk(String(F("<label>OTA-Passwort (leer = kein Passwort)</label>"
                 "<input name='ota_password' type='password' value='")) + htmlEscape(cfg.ota_password) + F("'>"));
  chunk(String(F("<p class='hint'>OTA-Hostname: <b>")) + htmlEscape(cfg.hostname) + F(".local</b> — Änderungen gelten nach Neustart.</p>"));

  chunk(F("<h3>Darstellung</h3>"));
  chunk(String(F("<div class='chk'><input type='checkbox' id='dark_mode' name='dark_mode' value='1'")) +
        checked(cfg.dark_mode) + F(" onchange='updTheme()'><label style='margin:0'>Dark Mode</label></div>"));
  chunk(F("<p class='hint'>Dunkles Theme mit reduzierter Helligkeit f&uuml;r das Webinterface, passend zu typischen Desktop- und Browser-Dark-Themes.</p>"));

  chunk(F("<h3>Standort</h3>"));
  chunk(F("<div class='row2'>"));
  chunk(String(F("<div><label>Höhe über NN (Meter)</label>"
                 "<input name='elevation' type='number' value='")) + cfg.elevation + F("'></div>"));
  chunk(F("<div></div></div>"));
  
  chunk(F("<h3>Firmware-Installer</h3>"));
  chunk(String(F("<div class='stat'>"
                 "<b>Aktuelle Firmware:</b> <span id='v-fw'>")) + htmlEscape(FPSTR(FW_VERSION)) + F("</span><br>"
                 "<b>Firmware-Datei:</b> <input id='fw_file' type='file' accept='.bin' style='margin-top:8px'>"
                 "</div>"));
  chunk(F("<div class='row3'>"));
  chunk(F("<div><button type='button' onclick='uploadFirmware()'>⬆ Firmware einspielen</button></div>"));
  chunk(F("<div></div><div></div>"));
  chunk(F("</div>"));
  chunk(F("<div id='fw_msg' class='hint' style='margin-top:8px'></div>"));

  chunk(F("<h3>Chip-Info</h3>"));
  chunk(String(F("<div class='stat'>"
                 "<b>Chip:</b> ")) + clockChipLabel() +
        F(" &nbsp; <b>ID:</b> 0x") + clockChipIdHex() +
        F(" &nbsp; <b>Flash:</b> ") + ESP.getFlashChipSize() / 1024 + F(" KB"
        " &nbsp; <b>Freier Heap:</b> ") + ESP.getFreeHeap() + F(" Byte"
        " &nbsp; <b>Sketch-Größe:</b> ") + ESP.getSketchSize() / 1024 + F(" KB"
        " &nbsp; <b>Frei:</b> ") + ESP.getFreeSketchSpace() / 1024 + F(" KB"
        "</div>"));

  chunk(F("<h3>Aktionen</h3>"));
  chunk(F("<div class='row3'>"));
  chunk(F("<div><button formaction='/apply' formmethod='POST' class='btn-sec'>⚡ Sofort anwenden</button></div>"));
  chunk(F("<div><button formaction='/applyreboot' formmethod='POST' class='btn-sec'>⚡ Anwenden + Neustart</button></div>"));
  chunk(F("<div><button formaction='/reboot' formmethod='POST' class='btn-sec'>🔄 Neustart</button></div>"));
  chunk(F("</div>"));
  chunk(F("<div style='margin-top:10px'>"));
  chunk(F("<button formaction='/factory' formmethod='POST' class='btn-danger'"
          " onclick='return confirm(\"Wirklich Factory Reset? Alle Einstellungen werden gelöscht.\")'>"));
  chunk(F("🗑 Factory Reset</button></div>"));
  chunk(F("<h3>Diagnose</h3>"
          "<p><a href='/diag' target='_blank' style='color:var(--c)'>Diagnosedaten anzeigen</a> &mdash; zeigt WiFi-Status und gespeicherte Konfiguration.</p>"));
  chunk(F("</div>")); // panel system

  // ---- Footer: Save-Button (innerhalb des Hauptformulars!) ----
  chunk(F("<div style='position:sticky;bottom:0;background:var(--bg);padding:10px 0;"
          "text-align:right;border-top:1px solid var(--border);margin-top:16px'>"
          "<button type='submit' style='font-size:1rem;padding:10px 28px'>💾 Speichern</button>"
          "</div>"));
  chunk(F("</form>"));

  chunk(F("</div></body></html>"));
}

// ============================================================
// Web-Handler: Save
// ============================================================
static bool parseRule(const String& s, uint8_t& m, uint8_t& w, uint8_t& d, uint8_t& h) {
  int d1 = s.indexOf('.'), d2 = s.indexOf('.', d1+1), sl = s.indexOf('/', d2+1);
  if (d1<0||d2<0||sl<0) return false;
  m=(uint8_t)s.substring(0,d1).toInt(); w=(uint8_t)s.substring(d1+1,d2).toInt();
  d=(uint8_t)s.substring(d2+1,sl).toInt(); h=(uint8_t)s.substring(sl+1).toInt();
  return m>=1&&m<=12 && w>=1&&w<=5 && d<=6 && h<=23;
}

static void applyFormToConfig() {
  auto arg = [&](const char* k) -> String { return trimStr(server.arg(k)); };

  if (server.hasArg(F("sta_ssid")))   cfg.sta_ssid  = arg("sta_ssid");
  if (server.hasArg(F("sta_pass")))   cfg.sta_pass  = arg("sta_pass");
  if (server.hasArg(F("hostname"))) {
    cfg.hostname = arg("hostname");
    if (cfg.hostname.length() > 32) cfg.hostname = cfg.hostname.substring(0, 32);
    if (cfg.hostname.length() == 0) cfg.hostname = "dottie";
  }

  cfg.use_dhcp = server.hasArg(F("use_dhcp"));

  if (server.hasArg(F("static_ip")))   cfg.static_ip   = arg("static_ip");
  if (server.hasArg(F("static_gw")))   cfg.static_gw   = arg("static_gw");
  if (server.hasArg(F("static_mask"))) cfg.static_mask = arg("static_mask");
  if (server.hasArg(F("dns1"))) cfg.dns1 = arg("dns1");
  if (server.hasArg(F("dns2"))) cfg.dns2 = arg("dns2");

  if (server.hasArg(F("ntp1"))) cfg.ntp1 = arg("ntp1");
  if (server.hasArg(F("ntp2"))) cfg.ntp2 = arg("ntp2");
  if (server.hasArg(F("ntp3"))) cfg.ntp3 = arg("ntp3");
  if (server.hasArg(F("ntp_interval_min"))) cfg.ntp_interval_min = (uint16_t)server.arg(F("ntp_interval_min")).toInt();

  if (server.hasArg(F("wifi_timeout_sec"))) cfg.wifi_timeout_sec = (uint16_t)server.arg(F("wifi_timeout_sec")).toInt();
  if (server.hasArg(F("ip_show_sec")))      cfg.ip_show_sec      = (uint16_t)server.arg(F("ip_show_sec")).toInt();

  if (server.hasArg(F("utc_offset_min")))   cfg.utc_offset_min   = (int16_t)server.arg(F("utc_offset_min")).toInt();
  if (server.hasArg(F("elevation")))        cfg.elevation        = (int16_t)server.arg(F("elevation")).toInt();
  if (server.hasArg(F("dst_mode")))         cfg.dst_mode         = (uint8_t)server.arg(F("dst_mode")).toInt();
  if (server.hasArg(F("dst_add_min")))      cfg.dst_add_min      = (int16_t)server.arg(F("dst_add_min")).toInt();

  uint8_t m,w,d,h;
  if (server.hasArg(F("dst_start")) && parseRule(arg("dst_start"),m,w,d,h))
    { cfg.dst_sm=m;cfg.dst_sw=w;cfg.dst_sd=d;cfg.dst_sh=h; }
  if (server.hasArg(F("dst_end"))   && parseRule(arg("dst_end"),m,w,d,h))
    { cfg.dst_em=m;cfg.dst_ew=w;cfg.dst_ed=d;cfg.dst_eh=h; }

  if (server.hasArg(F("brightness"))) {
    int b = constrain(server.arg(F("brightness")).toInt(), 0, 15);
    cfg.brightness = (uint8_t)b;
  }
  cfg.auto_brightness = server.hasArg(F("auto_brightness"));

  cfg.show_24h     = server.hasArg(F("show_24h"));
  cfg.show_seconds = server.hasArg(F("show_seconds"));
  if (server.hasArg(F("date_fmt"))) cfg.date_fmt = (uint8_t)constrain(server.arg(F("date_fmt")).toInt(), 0, 4);
  cfg.scroll_enabled = server.hasArg(F("scroll_enabled"));
  cfg.dark_mode = server.hasArg(F("dark_mode"));
  if (server.hasArg(F("bottom_font"))) cfg.bottom_font = (uint8_t)constrain(server.arg(F("bottom_font")).toInt(), 0, 6);
  if (server.hasArg(F("bottom_env_font"))) cfg.bottom_env_font = (uint8_t)constrain(server.arg(F("bottom_env_font")).toInt(), 0, 6);
  cfg.weekday_mixed_case = server.hasArg(F("weekday_mixed_case"));
  if (server.hasArg(F("bottom_mode"))) cfg.bottom_mode = (uint8_t)constrain(server.arg(F("bottom_mode")).toInt(), 0, 2);
  if (server.hasArg(F("bottom_switch_sec"))) cfg.bottom_switch_sec = (uint16_t)constrain(server.arg(F("bottom_switch_sec")).toInt(), 2, 600);
  if (server.hasArg(F("bottom_scroll_speed"))) cfg.bottom_scroll_speed = (uint8_t)constrain(server.arg(F("bottom_scroll_speed")).toInt(), 5, 250);
  
  // Scroll-State und Display-Cache zurücksetzen
  invalidateDisplayCache();
  lastDispTime[0] = 0;
  lastDispDate[0] = 0;
  lastDispWeekday[0] = 0;

  requestBrightnessFromLoop();
  cfg.ota_enabled  = server.hasArg(F("ota_enabled"));
  if (server.hasArg(F("ota_password"))) cfg.ota_password = arg("ota_password");
}

static void handleSave() {
  applyFormToConfig();

  if (!saveConfig()) {
    server.send(500, F("text/plain"), F("Konfiguration konnte nicht gespeichert werden."));
    return;
  }

  // Im AP-Modus: Neustart damit der ESP sich mit den neuen WLAN-Daten verbindet
  if (WiFi.getMode() & WIFI_AP) {
    server.send(200, F("text/html"),
      F("<!DOCTYPE html><html><head><meta charset='utf-8'>"
        "<meta http-equiv='refresh' content='12;url=http://192.168.4.1/'>"
        "</head><body style='font-family:sans-serif;text-align:center;padding:40px'>"
        "<h2>&#10003; Einstellungen gespeichert</h2>"
        "<p>Der ESP startet jetzt neu und verbindet sich mit dem WLAN.</p>"
        "<p>Diese Seite leitet in 12 Sekunden weiter.</p>"
        "</body></html>"));
    delay(500);
    ESP.restart();
    return;
  }

  server.sendHeader(F("Location"), F("/"));
  server.send(303);
}

static bool parseRtcFields(const String& dateStr, const String& timeStr, time_t& epochOut) {
  int y = 0, m = 0, d = 0, hh = 0, mm = 0, ss = 0;
  if (sscanf(dateStr.c_str(), "%d-%d-%d", &y, &m, &d) != 3) return false;
  if (sscanf(timeStr.c_str(), "%d:%d:%d", &hh, &mm, &ss) < 2) return false;
  if (sscanf(timeStr.c_str(), "%d:%d", &hh, &mm) < 2) return false;
  if (y < 2000 || y > 2199) return false;
  if (m < 1 || m > 12) return false;
  if (d < 1 || d > daysInMonth(y, m)) return false;
  if (hh < 0 || hh > 23) return false;
  if (mm < 0 || mm > 59) return false;
  if (ss < 0 || ss > 59) return false;
  struct tm tmv {};
  tmv.tm_year = y - 1900;
  tmv.tm_mon  = m - 1;
  tmv.tm_mday = d;
  tmv.tm_hour = hh;
  tmv.tm_min  = mm;
  tmv.tm_sec  = ss;
  tmv.tm_isdst = -1;
  epochOut = mktime(&tmv);
  return epochOut > 0;
}

static void handleRtcSet() {
  if (!ds3231Present) {
    server.send(409, F("text/plain"), F("DS3231 nicht gefunden"));
    return;
  }
  String dateStr = trimStr(server.arg(F("date")));
  String timeStr = trimStr(server.arg(F("time")));
  time_t epoch = 0;
  if (!parseRtcFields(dateStr, timeStr, epoch)) {
    server.send(400, F("text/plain"), F("Ungueltiges Datum oder Uhrzeit"));
    return;
  }
  if (!rtcSetTimeFromEpoch(epoch)) {
    server.send(500, F("text/plain"), F("RTC konnte nicht beschrieben werden"));
    return;
  }
  ds3231TimeValid = true;
  lastRtcSyncMs = millis();
  applySystemTimeEpoch(epoch, false, F("DS3231 aktiv"), F("RTC manuell gesetzt"));
  server.send(200, F("text/plain"), F("OK"));
}

static void handleFirmwareUpdateDone() {
  if (firmwareUpdateOk) {
    server.send(200, F("application/json"), F("{\"ok\":true}"));
    delay(750);
    ESP.restart();
    return;
  }

  String err = firmwareUpdateError.length() ? firmwareUpdateError : F("Firmware-Update fehlgeschlagen");
  String json = String(F("{\"ok\":false,\"error\":\"")) + jsonEscape(err) + F("\"}");
  server.send(500, F("application/json"), json);
}

static void handleFirmwareUpdateUpload() {
  HTTPUpload& upload = server.upload();

  if (upload.status == UPLOAD_FILE_START) {
    firmwareUpdateOk = false;
    firmwareUpdateError = "";
    String name = upload.filename;
    if (!name.endsWith(F(".bin"))) {
      firmwareUpdateError = F("Nur .bin-Dateien sind erlaubt");
      return;
    }
    if (!Update.begin(UPDATE_SIZE_UNKNOWN)) {
      firmwareUpdateError = Update.errorString();
      return;
    }
  } else if (upload.status == UPLOAD_FILE_WRITE) {
    if (firmwareUpdateError.length()) return;
    size_t written = Update.write(upload.buf, upload.currentSize);
    if (written != upload.currentSize) {
      firmwareUpdateError = Update.errorString();
    }
  } else if (upload.status == UPLOAD_FILE_END) {
    if (firmwareUpdateError.length()) {
      Update.abort();
      return;
    }
    if (!Update.end(true)) {
      firmwareUpdateError = Update.errorString();
      return;
    }
    firmwareUpdateOk = true;
  } else if (upload.status == UPLOAD_FILE_ABORTED) {
    Update.abort();
    firmwareUpdateError = F("Upload abgebrochen");
  }
}

// ============================================================
// Web-Handler: Apply / Reboot / Factory
// ============================================================
static void handleApply() {
  applyFormToConfig();
  applyTimezone();
  startWiFiSTA();
  server.sendHeader(F("Location"),F("/"));
  server.send(303);
}

static const char REBOOT_PAGE[] PROGMEM =
  "<!doctype html><html><head><meta charset='utf-8'>"
  "<title>Neustart...</title>"
  "<style>body{font-family:system-ui,sans-serif;display:flex;align-items:center;justify-content:center;"
  "min-height:100vh;margin:0;background:#f8fafc;color:#1e293b}"
  ".box{text-align:center;padding:40px;background:#fff;border-radius:12px;"
  "box-shadow:0 4px 24px rgba(0,0,0,.08);max-width:360px;width:90%}"
  "h2{margin:0 0 8px}.sub{color:#64748b;margin:0 0 24px}"
  ".bar{width:100%;height:6px;background:#e2e8f0;border-radius:3px;overflow:hidden;margin:20px 0}"
  ".fill{height:100%;background:#3b82f6;border-radius:3px;transition:width .4s}"
  "#msg{font-size:.9rem;color:#64748b}</style></head>"
  "<body><div class='box'>"
  "<h2>&#x1F504; Dottie startet neu</h2>"
  "<p class='sub'>Bitte warten...</p>"
  "<div class='bar'><div class='fill' id='bar' style='width:0'></div></div>"
  "<div id='msg'>Neustart wird eingeleitet...</div>"
  "</div><script>"
  "var start=Date.now(),wait=12000;"
  "function tick(){"
  "var el=Date.now()-start,pct=Math.min(100,el/wait*100);"
  "document.getElementById('bar').style.width=pct+'%';"
  "if(el<5000){document.getElementById('msg').textContent='Neustart laeuft... ('+(Math.ceil((wait-el)/1000))+'s)';"
  "setTimeout(tick,200);return;}"
  "fetch('/api/status').then(function(r){if(r.ok){window.location.href='/';}"
  "else{setTimeout(tick,800);}}).catch(function(){setTimeout(tick,800);});}"
  "setTimeout(tick,200);"
  "</script></body></html>";

static void sendRebootPage() {
  server.send_P(200, "text/html", REBOOT_PAGE);
}

static void handleApplyReboot()  {
  applyFormToConfig();
  applyTimezone();
  sendRebootPage();
  delay(400);
  ESP.restart();
}
static void handleReboot()       { sendRebootPage(); delay(400); ESP.restart(); }
static void handleFactory()      { server.send(200,F("text/plain"),F("Factory Reset...")); delay(200); factoryReset(); }

// ============================================================
// Web-Setup
// ============================================================
static void handleApiStatus() {
  time_t now = time(nullptr);
  time_t rtcNow = 0;
  char tbuf[20] = "--:--:--";
  char dbuf[14] = "--.--.----";
  char rtcDate[14] = "--.--.----";
  char rtcDateIso[11] = "----.--.--";
  char rtcTime[20] = "--:--:--";
  char rtcTimeIso[9] = "--:--:--";
  char lastSync[20] = "-";
  struct tm tm_l; memset(&tm_l, 0, sizeof(tm_l));
  bool timeValid = (now > 1700000000UL);
  bool rtcPresent = ds3231Present;
  bool rtcValid = false;
  if (timeValid) {
    localtime_r(&now, &tm_l);
    snprintf(tbuf, sizeof(tbuf), "%02d:%02d:%02d", tm_l.tm_hour, tm_l.tm_min, tm_l.tm_sec);
    formatDateDmy(dbuf,
                  (uint8_t)tm_l.tm_mday,
                  (uint8_t)(tm_l.tm_mon + 1),
                  (uint16_t)(tm_l.tm_year + 1900));
  }
  if (rtcPresent && rtcEpochToTime(rtcNow)) {
    struct tm rtcTm {};
    localtime_r(&rtcNow, &rtcTm);
    snprintf(rtcDate, sizeof(rtcDate), "%02d.%02d.%04d",
             rtcTm.tm_mday, rtcTm.tm_mon + 1, rtcTm.tm_year + 1900);
    snprintf(rtcDateIso, sizeof(rtcDateIso), "%04d-%02d-%02d",
             rtcTm.tm_year + 1900, rtcTm.tm_mon + 1, rtcTm.tm_mday);
    snprintf(rtcTime, sizeof(rtcTime), "%02d:%02d:%02d",
             rtcTm.tm_hour, rtcTm.tm_min, rtcTm.tm_sec);
    snprintf(rtcTimeIso, sizeof(rtcTimeIso), "%02d:%02d:%02d",
             rtcTm.tm_hour, rtcTm.tm_min, rtcTm.tm_sec);
    rtcValid = true;
  }
  if (lastSyncEpoch > 0) {
    struct tm tm_s {};
    localtime_r(&lastSyncEpoch, &tm_s);
    snprintf(lastSync, sizeof(lastSync), "%02d.%02d.%04d %02d:%02d:%02d",
             tm_s.tm_mday, tm_s.tm_mon + 1, tm_s.tm_year + 1900,
             tm_s.tm_hour, tm_s.tm_min, tm_s.tm_sec);
  }
  // Uptime
  uint32_t s=(millis()-bootMs)/1000; uint32_t m=s/60; s%=60;
  uint32_t h=m/60; m%=60; uint32_t d=h/24; h%=24;
  char upbuf[24]; snprintf(upbuf, sizeof(upbuf), "%lud %02lu:%02lu:%02lu",
                           (unsigned long)d,
                           (unsigned long)h,
                           (unsigned long)m,
                           (unsigned long)s);

  auto iaqText = [](float score) -> const char* {
    if (score < 0) return "Sensoren stabilisieren...";
    if (score <= 50) return "Ausgezeichnet";
    if (score <= 100) return "Gut";
    if (score <= 150) return "Mäßig";
    if (score <= 200) return "Unvorteilhaft";
    if (score <= 250) return "Schlecht";
    if (score <= 350) return "Sehr schlecht";
    return "Extrem schlecht";
  };

  auto humiText = [](float h) -> const char* {
    if (h < 0.0f) return "";
    if (h < 30.0f) return "Zu trocken";
    if (h <= 40.0f) return "Trocken";
    if (h <= 60.0f) return "Optimal";
    if (h <= 65.0f) return "Feucht";
    return "Lüften! (Schimmelgefahr)";
  };

  auto humiColor = [](float h) -> const char* {
    if (h < 0.0f) return "";
    if (h < 30.0f || h > 70.0f) return "#dc2626";
    if (h <= 40.0f || h > 60.0f) return "#eab308";
    return "#16a34a";
  };

  auto absHumiText = [](float ah) -> const char* {
    if (ah < 0.0f) return "";
    if (ah < 5.0f) return "Sehr trocken";
    if (ah <= 7.0f) return "Trocken";
    if (ah <= 11.0f) return "Optimal";
    if (ah <= 13.5f) return "Erhöht";
    if (ah <= 16.0f) return "Hoch (schwül)";
    return "Sehr hoch (schwül)";
  };

  auto absHumiColor = [](float ah) -> const char* {
    if (ah < 0.0f) return "";
    if (ah < 5.0f || ah > 16.0f) return "#dc2626";
    if (ah <= 7.0f || ah > 13.5f) return "#eab308";
    return "#16a34a";
  };

  String presTrend = "";
  float diff = 0.0f;
  if (bmeHistCount >= 36) { // 3 Stunden (36 * 5 Minuten)
    int prevIdx = (bmeHistIdx + BME_HIST_POINTS - 36) % BME_HIST_POINTS;
    float oldPres = bmeHistory[prevIdx].pres;
    if (isfinite(oldPres) && oldPres > 0 && isfinite(bmePres)) {
      diff = bmePres - oldPres;
      if (diff > 1.0f) presTrend = "&nearr;";
      else if (diff < -1.0f) presTrend = "&searr;";
      else presTrend = "&rarr;";
    }
  }

  String forecast = "Wird berechnet...";
  if (bmeHistCount >= 36 && isfinite(bmePres)) {
    if (bmePres < 1000) {
      if (diff < -1.0f) forecast = "Nass";
      else if (diff > 1.0f) forecast = "Aufklarend";
      else forecast = "Unbeständig";
    } else if (bmePres > 1020) {
      if (diff < -1.0f) forecast = "Eintrübend";
      else if (diff > 1.0f) forecast = "Beständig";
      else forecast = "Freundlich";
    } else {
      if (diff < -1.0f) forecast = "Wechselhaft";
      else if (diff > 1.0f) forecast = "Aufklarend";
      else forecast = "Ruhig";
    }
  }

  String json = "{";
  json += String(F("\"time\":\"")) + tbuf + F("\",");
  json += String(F("\"date\":\"")) + dbuf + F("\",");
  json += String(F("\"uptime\":\"")) + upbuf + F("\",");
  json += String(F("\"epoch\":")) + (unsigned long)now + F(",");
  // localsec: Sekunden seit Tagesbeginn in Lokalzeit — für JS-Interpolation
  json += String(F("\"localsec\":")) +
          (timeValid ? (uint32_t)(tm_l.tm_hour * 3600 + tm_l.tm_min * 60 + tm_l.tm_sec) : 0UL)
          + F(",");
  json += String(F("\"lux\":")) + (isfinite(luxHold) ? String(luxHold, 1) : String(-1.0f)) + F(",");
  json += String(F("\"brightness\":")) + displayIntensityApplied + F(",");
  json += String(F("\"fw_version\":\"")) + jsonEscape(FPSTR(FW_VERSION)) + F("\",");
  json += String(F("\"auto_brightness\":")) + (cfg.auto_brightness ? F("true") : F("false")) + F(",");
  json += String(F("\"sensor_ok\":")) + (vemlOk ? F("true") : F("false")) + F(",");
  json += String(F("\"sensor_msg\":\"")) + jsonEscape(vemlOk ? F("OK") : F("nicht gefunden")) + F("\",");
  json += String(F("\"i2c_diag\":\"")) + jsonEscape(i2cDiag) + F("\",");
  json += String(F("\"i2c_env_diag\":\"")) + jsonEscape(i2cDiagEnv) + F("\",");
  json += String(F("\"bme_ok\":")) + (bmeOk ? F("true") : F("false")) + F(",");
  json += String(F("\"bme_diag\":\"")) + jsonEscape(bmeDiag) + F("\",");
  json += String(F("\"bme_temp\":")) + (isfinite(bmeTemp) ? String(bmeTemp, 1) : String(-127.0f)) + F(",");
  json += String(F("\"bme_humi\":")) + (isfinite(bmeHumi) ? String(bmeHumi, 1) : String(-1.0f)) + F(",");
  json += String(F("\"bme_pres\":")) + (isfinite(bmePres) ? String(bmePres, 1) : String(-1.0f)) + F(",");
  json += String(F("\"bme_gas\":")) + (isfinite(bmeGas) ? String(bmeGas, 1) : String(-1.0f)) + F(",");
  json += String(F("\"bme_baseline\":")) + (bmeGasBaseline > 0.1f ? String(bmeGasBaseline, 1) : String(0.0f)) + F(",");
  json += String(F("\"bme_iaq\":")) + String(bmeIaqScore, 0) + F(",");
  json += String(F("\"bme_iaq_text\":\"")) + jsonEscape(iaqText(bmeIaqScore)) + F("\",");
  json += String(F("\"bme_humi_text\":\"")) + jsonEscape(humiText(bmeHumi)) + F("\",");
  json += String(F("\"bme_humi_color\":\"")) + humiColor(bmeHumi) + F("\",");
  json += String(F("\"bme_pres_trend\":\"")) + presTrend + F("\",");
  json += String(F("\"bme_forecast\":\"")) + jsonEscape(forecast) + F("\",");
  json += String(F("\"bme_dew\":")) + (isfinite(bmeDew) ? String(bmeDew, 1) : String(-127.0f)) + F(",");
  json += String(F("\"bme_heat\":")) + (isfinite(bmeHeat) ? String(bmeHeat, 1) : String(-127.0f)) + F(",");
  json += String(F("\"bme_abs_humi\":")) + (isfinite(bmeAbsHumi) ? String(bmeAbsHumi, 1) : String(-1.0f)) + F(",");
  json += String(F("\"bme_abs_humi_text\":\"")) + jsonEscape(absHumiText(bmeAbsHumi)) + F("\",");
  json += String(F("\"bme_abs_humi_color\":\"")) + absHumiColor(bmeAbsHumi) + F("\",");
  json += String(F("\"bme_last_save\":\"")) + jsonEscape(lastBmeSaveTime) + F("\",");
  json += String(F("\"rtc_present\":")) + (rtcPresent ? F("true") : F("false")) + F(",");
  json += String(F("\"rtc_ok\":")) + (rtcValid ? F("true") : F("false")) + F(",");
  json += String(F("\"rtc_date\":\"")) + rtcDate + F("\",");
  json += String(F("\"rtc_time\":\"")) + rtcTime + F("\",");
  json += String(F("\"rtc_date_iso\":\"")) + rtcDateIso + F("\",");
  json += String(F("\"rtc_time_iso\":\"")) + rtcTimeIso + F("\",");
  json += String(F("\"last_ntp_sync\":\"")) + lastSync + F("\",");
  json += String(F("\"time_source\":\"")) + jsonEscape(timeSource) + F("\",");
  json += String(F("\"time_source_detail\":\"")) + jsonEscape(timeSourceDetail) + F("\",");
  uint32_t nextSyncSec = 0;
  if (lastSyncEpoch > 0) {
    uint32_t interval = (uint32_t)cfg.ntp_interval_min * 60;
    uint32_t elapsed = (uint32_t)(time(nullptr) - lastSyncEpoch);
    if (elapsed < interval) nextSyncSec = interval - elapsed;
  }
  json += String(F("\"nextsync\":")) + nextSyncSec + F(",");
  json += String(F("\"heap\":")) + ESP.getFreeHeap() + F(",");
  json += String(F("\"rssi\":")) + (WiFi.status()==WL_CONNECTED ? WiFi.RSSI() : 0);
  json += "}";

  server.sendHeader(F("Cache-Control"), F("no-cache"));
  server.send(200, F("application/json"), json);
}

static void handleDiag() {
  String out;
  out += F("<!DOCTYPE html><html><head><meta charset='utf-8'>"
           "<style>body{font-family:monospace;padding:20px}pre{background:#111;color:#0f0;padding:15px;border-radius:6px}</style>"
           "</head><body><h2>Dottie Diagnose</h2><pre>");
  out += "FW:       "; out += FPSTR(FW_VERSION);       out += "\n";
  out += "Host:     "; out += htmlEscape(cfg.hostname);   out += "\n";
  out += "SSID:     ["; out += htmlEscape(cfg.sta_ssid); out += "]\n";
  out += "Passwort: ";
  if (cfg.sta_pass.length()) { out += "(gesetzt, "; out += cfg.sta_pass.length(); out += " Zeichen)"; }
  else out += "(LEER - kein Passwort gespeichert!)";
  out += "\n";
  out += "DHCP:     "; out += (cfg.use_dhcp ? "ja" : "nein"); out += "\n";
  out += "Stat.IP:  "; out += htmlEscape(cfg.static_ip); out += "\n";
  out += "WiFi:     ";
  if (WiFi.status() == WL_CONNECTED) { out += WiFi.localIP().toString(); out += " (verbunden)"; }
  else { out += "NICHT verbunden (status="; out += (int)WiFi.status(); out += ")"; }
  out += "\n";
  out += "AP-Modus: "; out += ((WiFi.getMode()&WIFI_AP) ? "ja" : "nein"); out += "\n";
  out += "DNS0:     "; out += WiFi.dnsIP(0).toString(); out += "\n";
  out += "Heap:     "; out += ESP.getFreeHeap(); out += "\n";
  out += "NTP1:     "; out += htmlEscape(cfg.ntp1); out += "\n";
  out += F("</pre><p><a href='/'>Zuruck zur Hauptseite</a></p></body></html>");
  server.send(200, F("text/html"), out);
}

static void handleApiHistory() {
  server.setContentLength(CONTENT_LENGTH_UNKNOWN);
  server.send(200, F("application/json"), "");
  server.sendContent(F("["));
  
  char buf[128];
  for (uint16_t i = 0; i < bmeHistCount; i++) {
    // Start bei ältester Position
    uint16_t idx = (bmeHistIdx - bmeHistCount + i + BME_HIST_POINTS) % BME_HIST_POINTS;
    BmeHistEntry &e = bmeHistory[idx];
    
    float ah = (6.112f * exp((17.67f * e.temp)/(e.temp + 243.5f)) * e.humi * 2.1674f) / (273.15f + e.temp);
    snprintf(buf, sizeof(buf), "{\"t\":%.1f,\"h\":%.1f,\"p\":%.1f,\"i\":%.0f,\"d\":%.1f,\"x\":%.1f,\"a\":%.1f}",
             e.temp, e.humi, e.pres, e.iaq, e.dew, e.heat, ah);
    server.sendContent(buf);
    
    if (i < bmeHistCount - 1) server.sendContent(F(","));
    
    // Alle paar Einträge yielden
    if (i % 20 == 0) yield();
  }
  
  server.sendContent(F("]"));
  server.sendContent("");
}

static void handleApiHistoryMonth() {
  server.setContentLength(CONTENT_LENGTH_UNKNOWN);
  server.send(200, F("application/json"), "");
  server.sendContent(F("["));
  
  char buf[200];
  for (uint16_t i = 0; i < bmeMonthCount; i++) {
    uint16_t idx = (bmeMonthIdx - bmeMonthCount + i + 30) % 30;
    BmeMonthEntry &e = bmeMonthHistory[idx];
    
    float ad = (6.112f * exp((17.67f * e.temp_day)/(e.temp_day + 243.5f)) * e.humi_day * 2.1674f) / (273.15f + e.temp_day);
    float an = (6.112f * exp((17.67f * e.temp_night)/(e.temp_night + 243.5f)) * e.humi_night * 2.1674f) / (273.15f + e.temp_night);
    snprintf(buf, sizeof(buf), "{\"td\":%.1f,\"tn\":%.1f,\"hd\":%.1f,\"hn\":%.1f,\"pd\":%.1f,\"pn\":%.1f,\"id\":%.0f,\"in\":%.0f,\"dd\":%.1f,\"dn\":%.1f,\"xd\":%.1f,\"xn\":%.1f,\"ad\":%.1f,\"an\":%.1f}",
             e.temp_day, e.temp_night, e.humi_day, e.humi_night, e.pres_day, e.pres_night, e.iaq_day, e.iaq_night, e.dew_day, e.dew_night, e.heat_day, e.heat_night, ad, an);
    server.sendContent(buf);
    
    if (i < bmeMonthCount - 1) server.sendContent(F(","));
    if (i % 5 == 0) yield();
  }
  
  server.sendContent(F("]"));
  server.sendContent("");
}

static void handleApiHistoryYear() {
  server.setContentLength(CONTENT_LENGTH_UNKNOWN);
  server.send(200, F("application/json"), "");
  server.sendContent(F("["));
  
  char buf[200];
  for (uint16_t i = 0; i < bmeYearCount; i++) {
    uint16_t idx = (bmeYearIdx - bmeYearCount + i + 365) % 365;
    BmeYearEntry &e = bmeYearHistory[idx];
    
    float am = (6.112f * exp((17.67f * e.temp_min)/(e.temp_min + 243.5f)) * e.humi_min * 2.1674f) / (273.15f + e.temp_min);
    float ax = (6.112f * exp((17.67f * e.temp_max)/(e.temp_max + 243.5f)) * e.humi_max * 2.1674f) / (273.15f + e.temp_max);
    snprintf(buf, sizeof(buf), "{\"tmin\":%.1f,\"tmax\":%.1f,\"hmin\":%.1f,\"hmax\":%.1f,\"pmin\":%.1f,\"pmax\":%.1f,\"imin\":%.0f,\"imax\":%.0f,\"dmin\":%.1f,\"dmax\":%.1f,\"xmin\":%.1f,\"xmax\":%.1f,\"amin\":%.1f,\"amax\":%.1f}",
             e.temp_min, e.temp_max, e.humi_min, e.humi_max, e.pres_min, e.pres_max, e.iaq_min, e.iaq_max, e.dew_min, e.dew_max, e.heat_min, e.heat_max, am, ax);
    server.sendContent(buf);
    
    if (i < bmeYearCount - 1) server.sendContent(F(","));
    if (i % 5 == 0) yield();
  }
  
  server.sendContent(F("]"));
  server.sendContent("");
}

static void setupWeb() {
  server.on(F("/"),            handleRoot);
  server.on(F("/api/history"), handleApiHistory);
  server.on(F("/api/history_month"), handleApiHistoryMonth);
  server.on(F("/api/history_year"), handleApiHistoryYear);
  server.on(F("/save"),        HTTP_POST, handleSave);
  server.on(F("/apply"),       HTTP_POST, handleApply);
  server.on(F("/applyreboot"), HTTP_POST, handleApplyReboot);
  server.on(F("/reboot"),      HTTP_POST, handleReboot);
  server.on(F("/factory"),     HTTP_POST, handleFactory);
  server.on(F("/rtcset"),      HTTP_POST, handleRtcSet);
  server.on(F("/api/update"),  HTTP_POST, handleFirmwareUpdateDone, handleFirmwareUpdateUpload);
  server.on(F("/api/status"),  HTTP_GET,  handleApiStatus);
  server.on(F("/diag"),        HTTP_GET,  handleDiag);
  server.begin();
}
