diwou/Dottie_-_The_Matrix_Clock_Extended_Edition/(commit log)

2026-05-13 feat: initialisiere dottie extended version
    [MAX7219_Dot_Matrix_1.kicad_sch, NTP Dot Matrix Clock 64x32.kicad_pcb, NTP Dot Matrix Clock 64x32.kicad_sch, bom.csv, designators.csv, positions.csv]
2026-05-13 fix: vervollstaendige font fuer wochentagsanzeige
    [display.h]
2026-05-13 fix: setze echten 6x7-font und direkte helligkeitsanwendung um
    [display.h, main.cpp]
2026-05-13 fix: korrigiere 6x7-modulfont und helligkeit auf allen modulen
    [display.h, main.cpp]
2026-05-13 fix: nutze 8x8-font fuer wochentagsanzeige 1zu1
    [display.h]
2026-05-13 fix: SPI-Race-Condition zwischen Web-Task und Haupt-Loop behoben
    Helligkeits- und PWM-Änderungen aus dem Webinterface werden nicht
    mehr direkt im Web-Task per mx.control() auf die MAX7219 geschrieben,
    sondern über Deferred-Flags sicher im Haupt-Loop verarbeitet.
    Behebt zufällige Pixelfehler und ungleichmäßige Helligkeit besonders
    bei Sprung von dunkel (0) auf hell (10-15).
    [main.cpp]
2026-05-13 docs: referenz fuer spi-race-fix im changelog ergaenzt
2026-05-13 fix: dritte Modulreihe beim OTA-Update löschen
    [main.cpp]
2026-05-13 feat: u8g2-proportionalschrift fuer wochentagsanzeige
    Dritte Modulreihe (Wochentag) nutzt jetzt u8g2_font_helvR08_tf
    als proportionalschrift. U8g2 rendert in einen offscreen-buffer
    (keine SPI-konkurrenz mit MD_MAX72XX); pixel werden via rowSet()
    auf die unteren MAX7219-module kopiert.
2026-05-13 fix: u8g2-buffer spaltenweise auslesen und baseline korrigiert
    Der MAX7219-Treiber in U8g2 nutzt u8g2_ll_hvline_vertical_top_lsb,
    der den Buffer spaltenweise organisiert (buf[col] = 8 vertikale
    Pixel). Behebt die 'zufaelligen Pixel' bei der Wochentagsanzeige.
    Baseline von y=8 auf y=7 korrigiert fuer 8px-Fonthoehe.
    [display.h]
2026-05-13 fix: buffer-layout auf horizontal_right_lsb korrigiert
    u8g2_Setup_max7219_64x8_f verwendet horizontal_right_lsb:
    buf[row*8 + tile] mit Maske 0x80>>col (MSB=linkes Pixel).
    Nicht vertical_top_lsb.
    [display.h]
2026-05-13 fix: u8g2-baseline auf y=8 fuer vollstaendige 8px-darstellung
    [display.h]
2026-05-13 fix: u8g2-font auf _tr variante ohne kerning
    [display.h]
2026-05-13 fix: font auf ncenR08 (new century schoolbook) fuer bessere laufweite
    [display.h]
2026-05-13 feat: schriftart und gross-/kleinschreibung fuer wochentag umschaltbar
    Web-UI: Font-Select (6 Schriftarten) + Checkbox fuer gemischte
    Gross-/Kleinschreibung im Display-Tab. Konfiguration wird
    persistent gespeichert.
2026-05-13 docs: u8g2-schriftauswahl und case-toggle im changelog dokumentiert
2026-05-13 fix: ntp-subsekunden und rundtrip-delay bei zeitsync kompensieren
    ntpProbeOnce und ntpProbeByIp lesen jetzt den fractional-teil
    der transmit-timestamp (bytes 44-47) und addieren die halbe
    round-trip-zeit. txSec wird auf naechste ganze sekunde gerundet.
    Behebt den ~1-sekunden-nachlauf der uhrzeit.
    [main.cpp]
2026-05-13 fix: scroll-animation vereinfacht, subsekunden-kompensation entfernt
    Die gettimeofday-basierte Subsekunden-Kompensation konnte auf
    ESP32 zu uninitialisierten Werten und damit zu quasi sofortigem
    Animationsende fuehren. Stattdessen immer volle 12 Schritte (240ms).
    [display.h]
2026-05-14 fix: datei webserver.h in ClockWebUi.h umbenannt, um windows-namenskonflikt mit WebServer.h zu beheben
    [ClockWebUi.h, main.cpp]
2026-05-15 fix: ntp-subsekunden-genauigkeit durch sekundengrenz-sync verbessert
    Vor dem RTC-Schreiben wird jetzt gezielt auf die naechste volle
    Sekundengrenze gewartet, damit die RTC exakt zur Sekundenmitte
    loslaeuft. Eliminiert den variablen Subsekunden-Versatz zwischen
    mehreren unabhaengig synchronisierten Uhren.
    [main.cpp]
2026-05-26 refactor: modernize architecture (asynchronous sntp, event-driven wifi, system time)
    - Switch to native ESP32 SNTP and internal system time
    - Replace blocking WiFi loops with event handlers
    - Remove jittery software PWM and redundant I2C polling
    - Optimize main loop for stability and smoothness
    - Update Web UI to reflect architectural changes
    [ClockWebUi.h, config.h, main.cpp]
2026-05-26 refactor: update time source status labels for clarity
    Change 'DS3231 active' to 'ESP32 (RTC)' and 'NTP active' to 'ESP32 (NTP)' to better reflect that the internal ESP32 clock is the primary source while indicating its sync status.
2026-05-27 fix: redraw separators after display clear by invalidating scroll cache
    [ClockWebUi.h, display.h, main.cpp]
2026-06-04 fix: korrigierte Platine V0.5
    [MAX7219_Dot_Matrix_1.kicad_sch, NTP Dot Matrix Clock 64x32.kicad_pcb, NTP Dot Matrix Clock 64x32.kicad_sch, bom.csv, designators.csv, positions.csv]
2026-06-06 docs: Changelog-Referenz korrigiert und .gitignore aktualisiert
2026-06-06 docs: Changelog und CSpell für Umweltdaten-Scrolltext aktualisiert
2026-06-06 fix: Grad-Symbol Encoding für Display korrigiert
    [main.cpp]
2026-06-06 fix: Flackern behoben und Font-Wiederherstellung korrigiert
    [main.cpp]
2026-06-06 fix: Scrolltext läuft im Wechselmodus nun immer komplett durch
    [main.cpp]
2026-06-06 fix: Wechsel-Intervall und Font-Selection in 3. Zeile korrigiert
    [main.cpp]
2026-06-06 fix: vertikaler Offset des Scrolltexts korrigiert
    [main.cpp]
2026-06-06 fix: U8g2 UTF8 API korrekt eingebunden und Scroll-Stottern behoben
    [main.cpp]
2026-06-06 fix: Grad-Symbol durch 'tf'-Fonts reaktiviert und Scroll-Stottern durch Task-Offloading behoben
    [display.h, main.cpp]
2026-06-06 fix: SVG-Escaping im JavaScript korrigiert
    [ClockWebUi.h]
2026-06-06 feat: Anzeige des letzten Speicherzeitpunkts der Historie
2026-06-06 feat: Zeitindex und Gitterlinien für Historie-Charts hinzugefügt
2026-06-06 fix: Überlappung der Chart-Beschriftungen behoben
    [ClockWebUi.h]
2026-06-07 fix: Systemstabilität durch Task-Trennung und optimiertes JSON-Streaming verbessert
    [ClockWebUi.h, main.cpp]
2026-06-07 fix: Syntaxfehler und Funktions-Umbenennungen korrigiert
    [display.h, main.cpp]
2026-06-07 fix: Chart-Skalierung auf feste 24h korrigiert
    [ClockWebUi.h]
2026-06-07 fix: Systemstabilität durch I2C-Mutex und optimierte Tasks verbessert; NTP-Sync Anzeige korrigiert
    [ClockWebUi.h, main.cpp]
2026-06-07 fix: Deadlock in setup() durch Umstellung auf rekursiven Mutex behoben
    [main.cpp]
2026-06-07 fix: BME680 Gasmessung durch Heizelement-Konfiguration reaktiviert
    [main.cpp]
2026-06-07 fix: BME680 Stabilisierungsphase (3 Min) für genauere IAQ-Baseline eingeführt
    [ClockWebUi.h, main.cpp]
2026-06-09 fix: BME680 Konfiguration und Baseline-Persistenz korrigiert
    [main.cpp]
2026-06-09 docs: Changelog für BME680-Fixes und Deadlock-Korrektur ergänzt
2026-06-09 feat: BME680-Baseline in WebUI und Projektregeln-Hinweis in Changelog
2026-06-10 fix(iaq): implement dynamic baseline decay and littlefs persistence
    [main.cpp]
2026-06-10 docs: update CHANGELOG for IAQ fix
    [main.cpp]
2026-06-10 fix(ui): render empty month charts properly
    [ClockWebUi.h]
2026-06-10 fix(version): revert base version to 1.7.0-dev
    [config.h]
2026-06-10 fix(bme680): clamp iaq score to 0-500 to prevent false 'stabilizing' state
    [main.cpp]
2026-06-11 fix(ui): draw circles on 30-day history graph to make single days visible
    [ClockWebUi.h]
2026-06-11 fix(iaq): baseline max tracking and score limits
    [main.cpp]
2026-06-17 feat(iaq): add ema filter for smoother iaq score rendering
2026-06-19 feat(ui): add humidity status text and pressure trend arrow
2026-06-19 fix(iaq): replace 5min average with dedicated 99% diagram EMA filter and fix -1.0 plot bug
    [main.cpp]
2026-06-21 feat(env): add dew point, heat index, and weather forecast
2026-06-21 feat(env): add absolute humidity, mold warning, sea level pressure and fix i2c diag ui
    [ClockWebUi.h, config.h, main.cpp]
2026-06-21 fix(ui): resolve duplicate i2c html id and add NN label
    [ClockWebUi.h]
2026-06-21 fix(config): add elevation to load and save routines in flash
    [config.h]
2026-06-22 fix(display): remove umlauts from uppercase matrix scrolltext to prevent top cutoff
    [main.cpp]
2026-06-22 fix(memory): replace String allocations in matrix loop with static char array to prevent LwIP heap fragmentation and network crashes
    [main.cpp]
2026-06-22 fix(ntp): set sync error indicator exactly 5 minutes after configured interval to allow router reboot grace period
    [main.cpp]
2026-06-22 style(env): replace weather trend categories with user suggested terminology
    [ClockWebUi.h, main.cpp]
2026-06-23 feat: add IBM BIOS 8x8 font (ib8x8u_tf) and revert env labels to mixed case to test lowercase rendering
    [ClockWebUi.h, display.h, main.cpp]
2026-06-23 fix: correct font index limit in display.h to 6
    [display.h]
2026-06-23 fix: change IBM font from VGA to CGA to ensure exact 8x8 bounding box
    [display.h]
2026-07-04 fix: Update heat index formula to NOAA algorithm
    [main.cpp]
2026-07-18 fix: WebUI year chart rendering and 7-day table labels
    [ClockWebUi.h]
